team2seniordesignwiki/OmegaBlade/4013 Senior Design/galleryImages/rgbLED_pic_prototype1.jpg

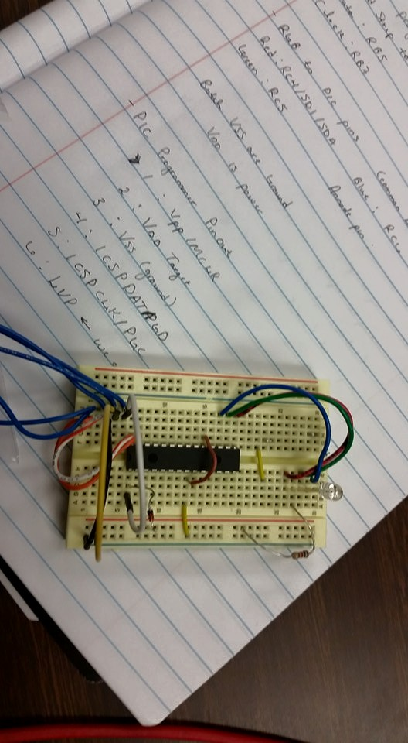
4013 Senior Design/galleryImages/rgbLED_pic_prototype1.jpg
