team2seniordesignwiki/OmegaBlade/4013 Senior Design/galleryImages/20151021221119.jpg

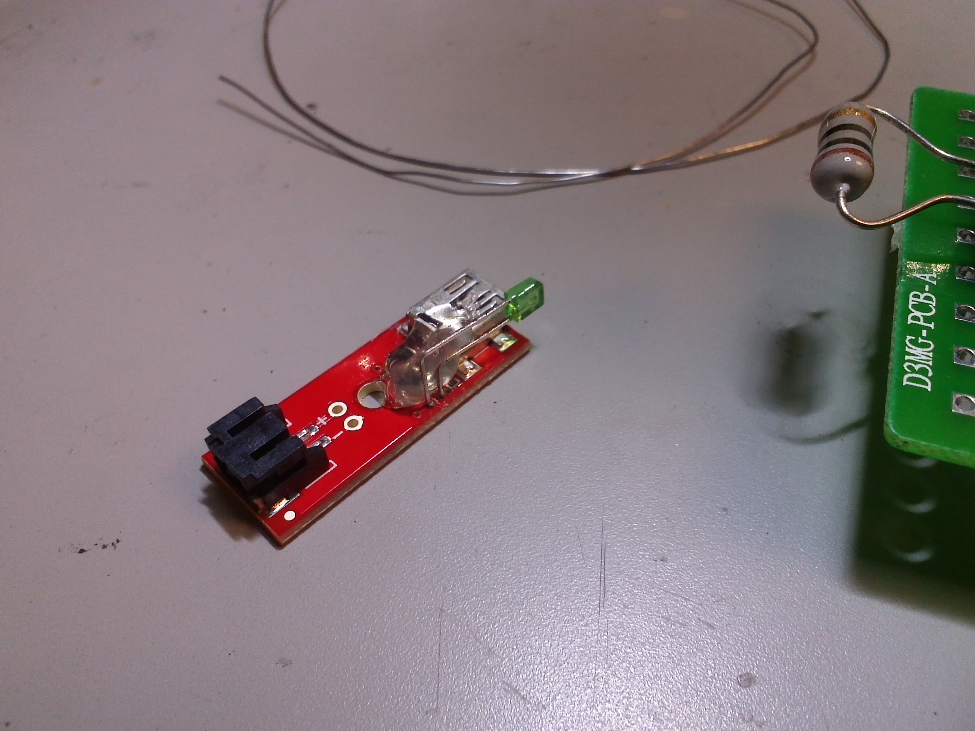
4013 Senior Design/galleryImages/20151021221119.jpg
