team2seniordesignwiki/OmegaBlade/Readme.txt

This the repository for Senior Design I - Team2 "Swordsmiths" for project OmegaBlade.
