team2seniordesignwiki/OmegaBlade/4013 Senior Design/Research/Blake/Blade and Grip Design/leather stripping for grips.txt

https://www.etsy.com/listing/176576841/russet-brown-genuine-leather-strips-2cm?ref=market
