team2seniordesignwiki/OmegaBlade/4013 Senior Design/Research/Derrian/Blade Locking Communication/Contact Connectors.txt

http://www.digikey.com/product-search/en?KeyWords=m90-6060845&WT.z_header=search_go

http://www.digikey.com/product-detail/en/M90-7060845/M90-7060845-ND/3924390

One order includes 4 connectors each
