team2seniordesignwiki/OmegaBlade/4013 Senior Design/Research/Derrian/Blade Locking Communication/Magnetic Connectors.txt

http://www.mindsetsonline.co.uk/Catalogue/ProductDetail/magnetic-connectors?productID=246373b2-2c6d-4ec8-a061-2f90dcc4a404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
