team2seniordesignwiki/OmegaBlade/4013 Senior Design/Managerial Docs/Team Block Diagram/Powerpoint Block Diagram Requirements.docx

## PowerPoint presentation must contain:

- Level 1 functional block diagram
- Pseudocode or flowchart for software
  - Flowchart must use proper symbology
- Gantt chart
  - Who’s doing what and when
- No Poster Needed
