team2seniordesignwiki/OmegaBlade/4013 Senior Design/Managerial Docs/Project Planning/4013 Senior Design I Team2 (Swordsmiths) Gantt Project.pdf

## 4013 Senior Design I Team2

(Swordsmiths) Gantt Project | Aug 30, 2015
ECEN Department | http://ecen4013.okstate.edu

Project manager
Project dates | Sep 1, 2015 - Nov 20, 2015
Completion | 0%
Tasks | 12
Resources | 6

This project contains both Gantt and PERT charts outlining task duration, deadlines, milestones, resource distribution, and task dependencies.

Name | Begin date | End date
Block Diagram | 9/1/15 | 9/21/15
Research | 9/1/15 | 9/21/15
Hardware Selection | 9/1/15 | 9/21/15
IR MIRP | 9/1/15 | 9/21/15
Enclosure Materials and Fabrication | 9/1/15 | 9/21/15
Prototyping | 9/17/15 | 10/8/15
Testing of IR Circuitry | 9/17/15 | 10/8/15
Testing of IR Transmission Code | 9/17/15 | 10/8/15
Enclosure Fabrication | 9/17/15 | 10/8/15
Integration Phase 1 | 10/1/15 | 10/15/15
Integration Phase 2 | 10/13/15 | 11/5/15
Project Report | 11/3/15 | 11/19/15

## 4013 Senior Design I Team2 (Swordsmiths)

Gantt Project | Aug 30, 2015
Tasks | 2

Name | Default role
Blake Schlesinger | Project Manger
Ben Jespersen | Lead Engineer
Austin Allen | Functional Specialist (Assembler)
Brandon Hogue | Treasurer
Christian Coffield | Proofreader/Editor
Derrian Glynn | Mediator
Resources | 3

## Gantt Chart

4

Name | Begin date | End date
Block Diagram | 9/1/15 | 9/21/15
Research | 9/1/15 | 9/21/15
Hardware Selection | 9/1/15 | 9/21/15
IR MIRP | 9/1/15 | 9/21/15
Enclosure Materials and ... 9/1/15 | 9/21/15
Prototyping | 9/17/15 | 10/8/15
Testing of IR Circuitry | 9/17/15 | 10/8/15
Testing of IR Transmissio...9/17/15 | 10/8/15
Enclosure Fabrication | 9/17/15 | 10/8/15
Integration Phase 1 | 10/1/15 | 10/15/15
Integration Phase 2 | 10/13/15 | 11/5/15
Project Report | 11/3/15 | 11/19/15
Week 36 | Week 37 | Week 38 | Week 39 | Week 40 | Week 41 | Week 42 | Week 43 | Week 44 | Week 45 | Week 46 | Week 47 | Week 48
8/30/15 | 9/6/15 | 9/13/15 | 9/20/15 | 9/27/15 | 10/4/15 | 10/11/15 | 10/18/15 | 10/25/15 | 11/1/15 | 11/8/15 | 11/15/15 | 11/22/15

## Resources Chart

5

Name | Default role
Blake Schlesinger | Project Manger
Ben Jespersen | Lead Engineer

Block Diagram

Hardware Sele...

Austin Allen | Functional Specialist (Ass...
Brandon Hogue | Treasurer
Christian Coffield | Proofreader/Editor
Derrian Glynn | Mediator
50% | 50% | 50%
70% | 70% | 70%
50% | 50% | 50%
20% | 20% | 20%
50% | 50% | 50% | 90% | 40% | 40% | 40%
50% | 50% | 50% | 70% | 20% | 20% | 20%
20% | 20% | 20% | 40% | 20% | 20% | 20%
50% | 50% | 50% | | 50% | 50% | 50%
Week 36 | Week 37 | Week 38 | Week 39 | Week 40 | Week 41 | Week 42 | Week 43 | Week 44 | Week 45 | Week 46 | Week 47 | Week 48
8/30/15 | 9/6/15 | 9/13/15 | 9/20/15 | 9/27/15 | 10/4/15 | 10/11/15 | 10/18/15 | 10/25/15 | 11/1/15 | 11/8/15 | 11/15/15 | 11/22/15
