team2seniordesignwiki/OmegaBlade/4013 Senior Design/Research/Brandon Hogue/IR/Transmit/NPN-CC-Driver-Schematic.pdf

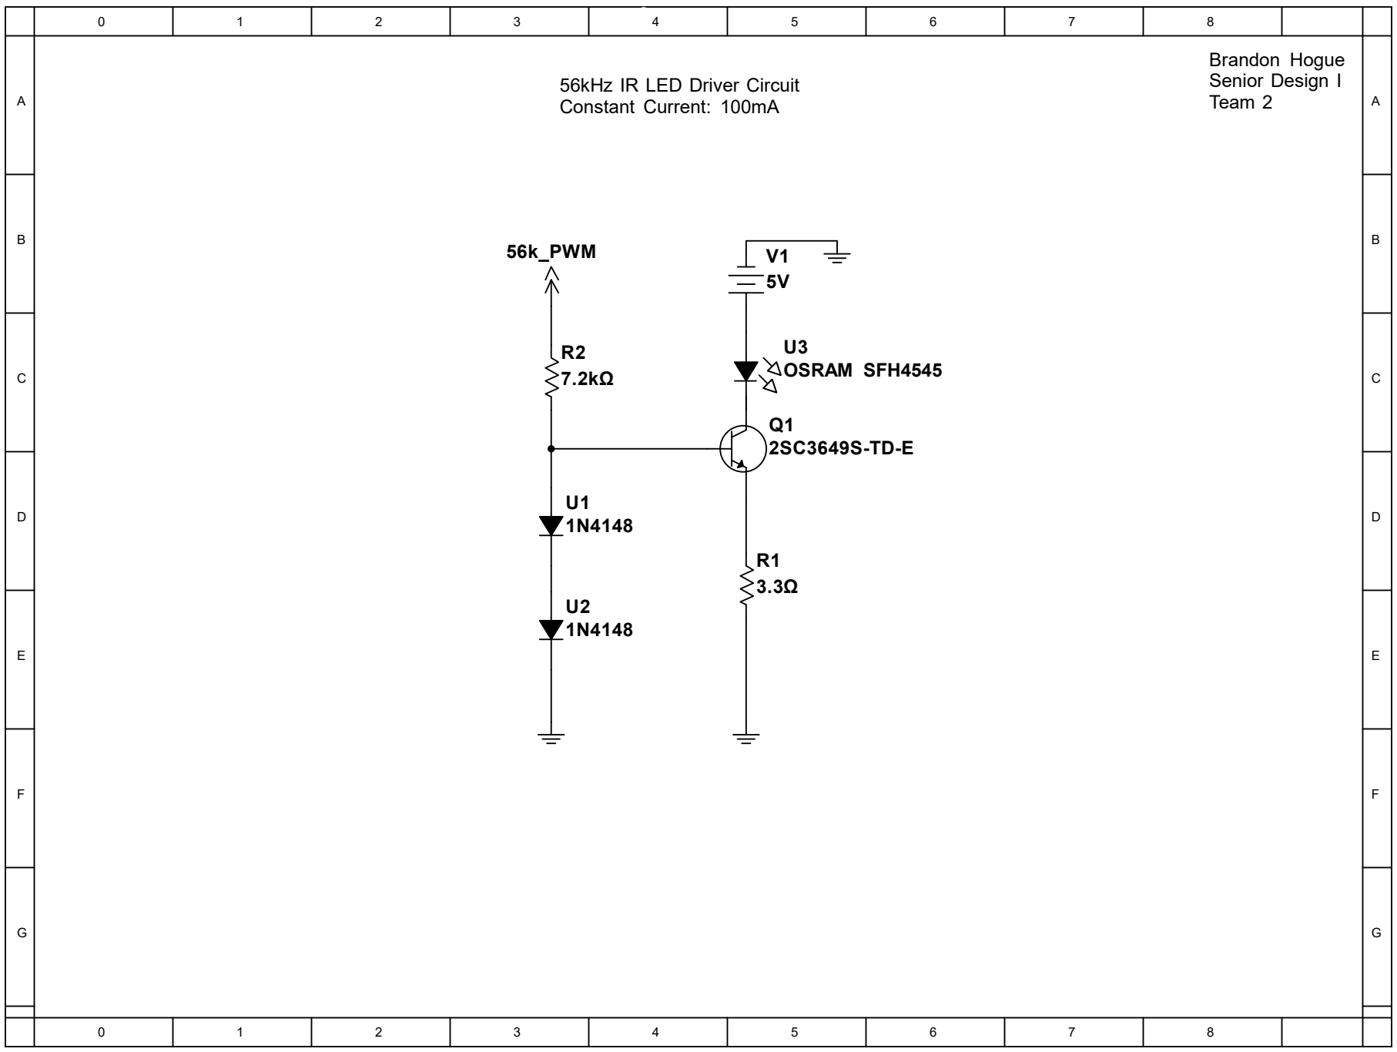
[picture p37: figure]
U3 OSRAM SFH4545; 56k_PWM; 56kHz IR LED Driver Circuit Constant Current: 100mA; Brandon Hogue Senior Design I Team 2
