team2seniordesignwiki/OmegaBlade/4013 Senior Design/Managerial Docs/Reports and Presentations/Omega Blade Team 2 Presentation.pptx

## Omega Blade

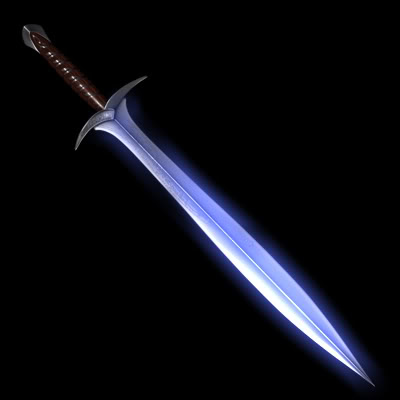
[picture p38: figure]
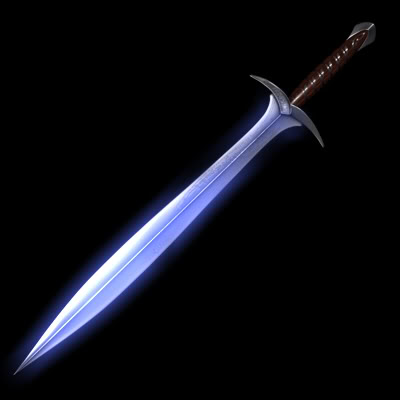
[picture p39: figure]

Team 2 “Swordsmiths”
Austin Allen
Christian Coffield
Derrian Glynn
Brandon Hogue
Ben Jespersen(LE)
Blake Schlesinger(PM)

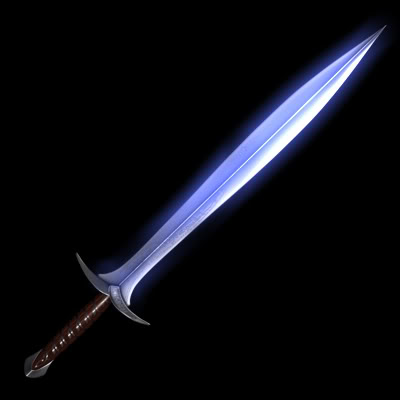
[picture p40: figure]

## The Story

## α

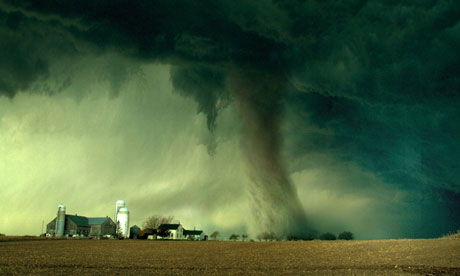
[picture p41: figure]

## β

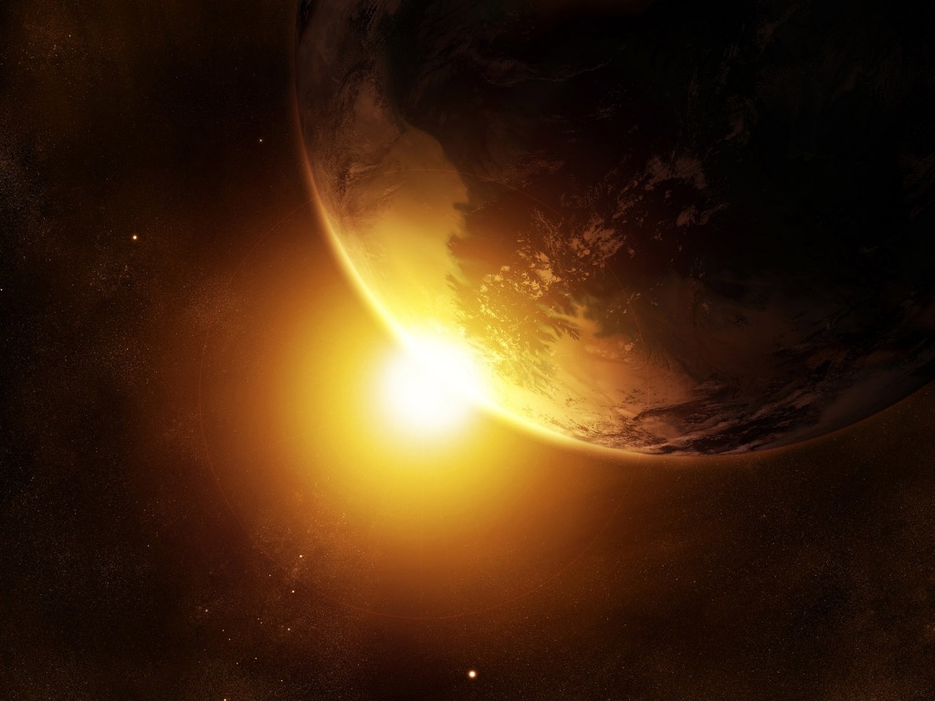
[picture p42: figure]

## Δ

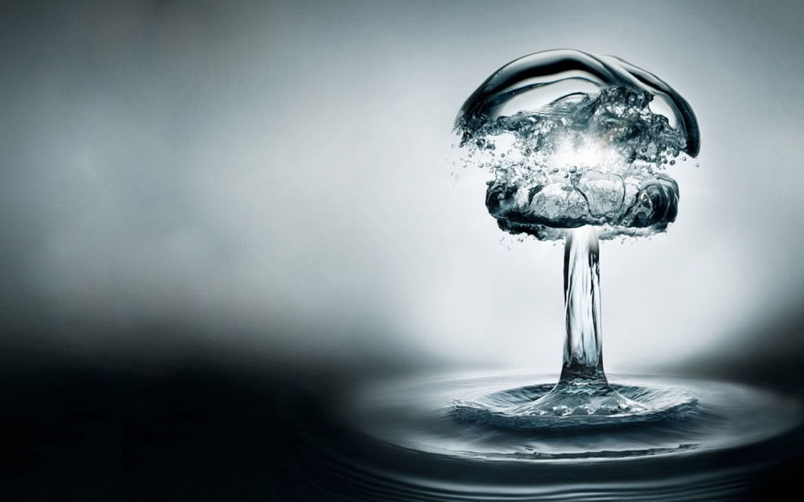
[picture p43: figure]

## γ

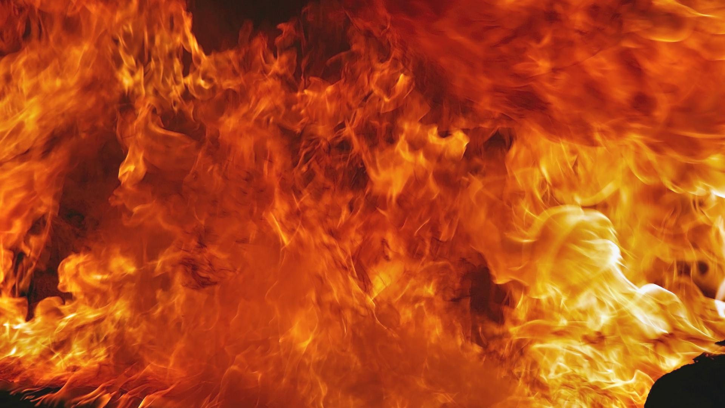
[picture p44: figure]

## Slide 7

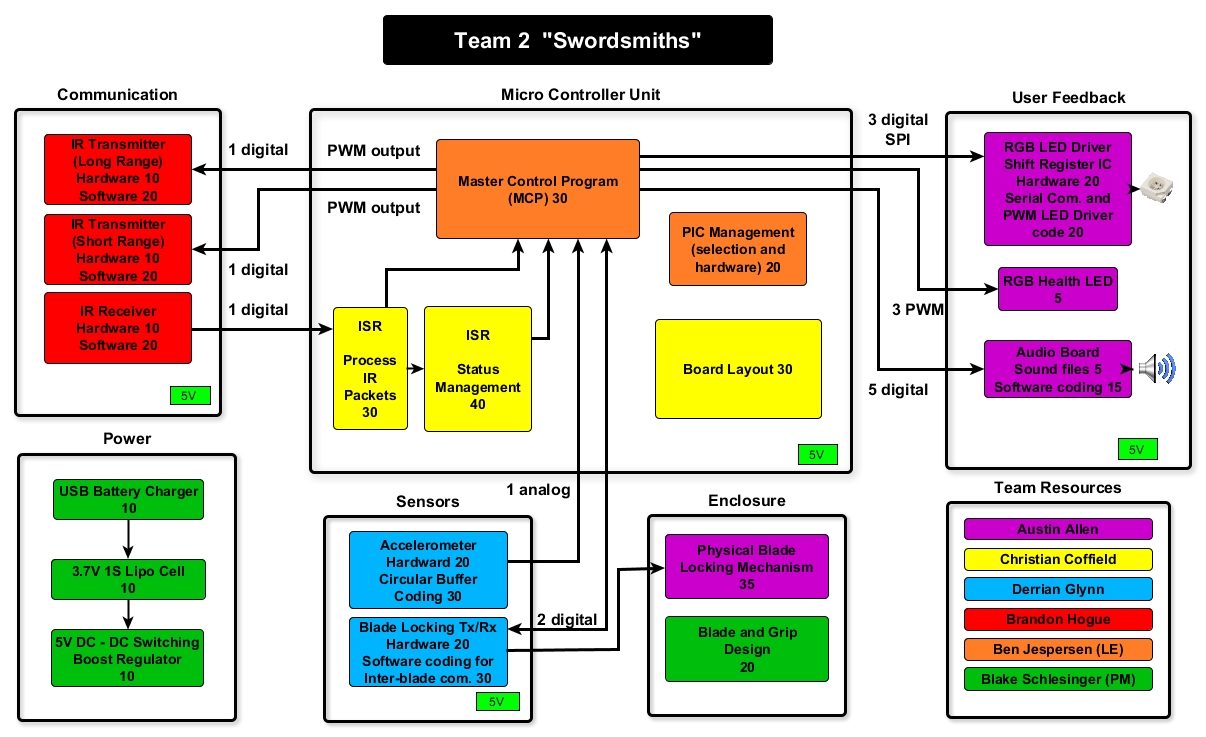
[picture p45: figure]

## Slide 8

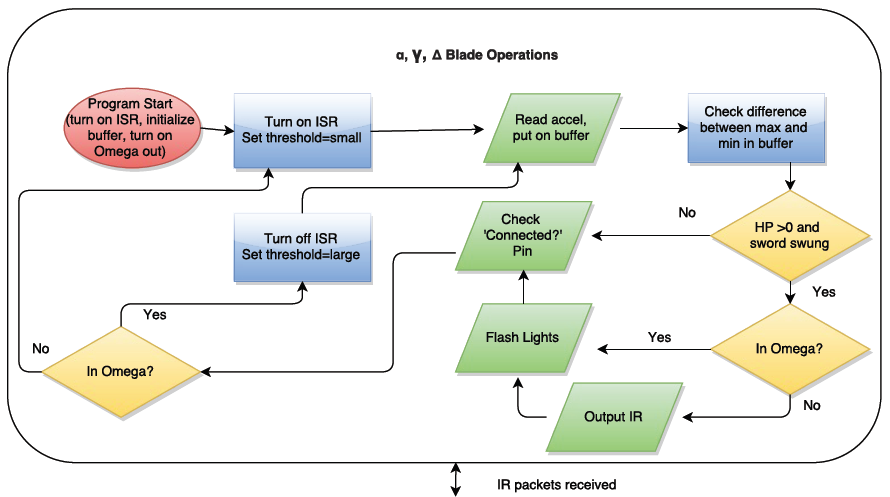
[picture p46: figure]
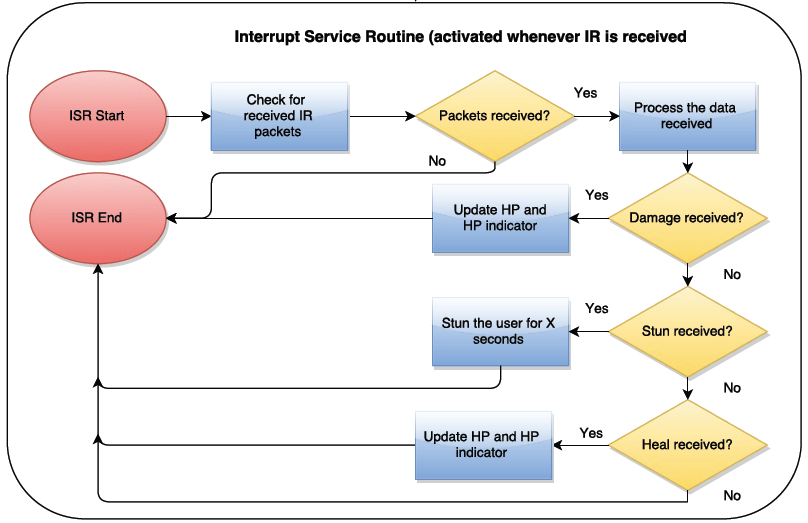
[picture p47: figure]

## Slide 9

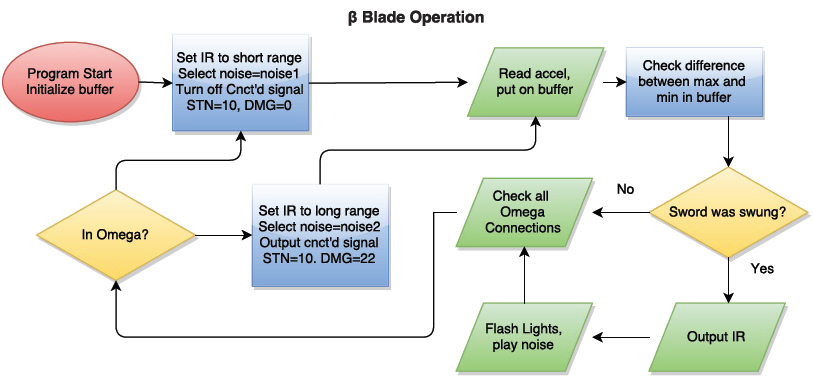
[picture p48: figure]

## Gantt Chart

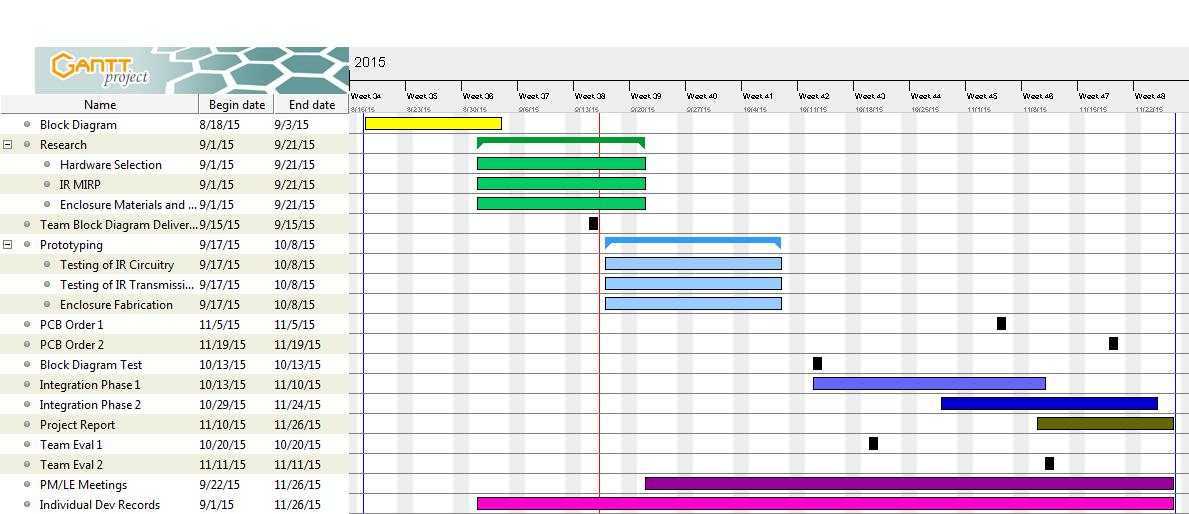
[picture p49: figure]

## Questions?
