team2seniordesignwiki/OmegaBlade/4013 Senior Design/Managerial Docs/Decision Matrix Spreadsheets/BLANK Table of Interests.xlsx

 | Pairwise comparison of selection criteria. |  |  |  |  |  |  |  | Note: Technical complexity meaning we want it to be more complex?
 |  | B |  |  |  |  |  |  | 1=A is equally important as B
 |  | Personal Skill | Complexity | Creativity | Cost | Interest | Geo.Mean | Weight | 2=A is moderately more important than B
A | Personal Skill |  |  |  |  |  | #NUM! | #NUM! | 3=A is strongly more important than B
 | Complexity |  |  |  |  |  | #NUM! | #NUM! | 4=A is very strongly more important than B
 | Creativity |  |  |  |  |  | #NUM! | #NUM! | 5=A is heavily more important than B
 | Cost |  |  |  |  |  | #NUM! | #NUM!
 | Interest |  |  |  |  |  | #NUM! | #NUM!
 |  |  |  |  |  | SUM= | #NUM! | #NUM!
 |  |  | Scoring the projects |  |  | Projects |  |  | Ranking from 1-5, with 1 being unfavorable, 5 being very favorable
 | CRITERIA | WEIGHT | Blacksmith | E-Bow | OmegaBlade | Puzzle | MOAB | Follower
 | Personal Skill | #NUM!
 | Complexity | #NUM!
 | Creativity | #NUM!
 | Cost | #NUM!
 | Interest | #NUM!
 |  | Points | #NUM! | #NUM! | #NUM! | #NUM! | #NUM! | #NUM!
