team2seniordesignwiki/OmegaBlade/4013 Senior Design/Managerial Docs/Decision Matrix Spreadsheets/decision_matrix_ben_jespersen.xlsx

Sheet: Sheet1
Determination of Weights | Team Skill | Technical Complexity | Creativity | Cost | Interest | Geometric Mean | Weights | Ranking Scale | Alternatives
Personal Skill | 1 | 2 | 0.5 | 0.3333333333 | 0.3333333333 | 0.644 | 0.110 | 1 = equal | Blacksmith 2.0
Technical Complexity | 0.5 | 1 | 0.5 | 0.25 | 0.25 | 0.435 | 0.074 | 2 = moderate | E-Bow
Creativity | 2 | 2 | 1 | 0.5 | 0.5 | 1.000 | 0.171 | 3 = strong | Omega Blade
Cost | 3 | 4 | 2 | 1 | 1 | 1.888 | 0.322 | 4 = very strong | Mystic Puzzle
Interest | 3 | 4 | 2 | 1 | 1 | 1.888 | 0.322 | 5 = heavy | MOAB
 |  |  |  |  |  |  |  |  | Follower Watchdog
Project Ratings | Personal Skill | Technical Complexity | Creativity | Cost | Interest | Geometric Mean | Ratings | Project Ratings Scale
Blacksmith 2.0 | 5 | 3 | 3 | 4 | 3 | 3.519 | 0.202 | 1 = least favorable
E-Bow | 3 | 2 | 2 | 2 | 4 | 2.491 | 0.143 | 2 = moderate
Omega Blade | 5 | 3 | 3 | 3 | 5 | 3.680 | 0.211 | 3 = strong
Mystic Puzzle | 3 | 2 | 4 | 3 | 5 | 3.245 | 0.186 | 4 = very strong
MOAB | 5 | 5 | 1 | 5 | 1 | 2.627 | 0.151 | 5 = most favorable
Follower Watchdog | 3 | 1 | 4 | 1 | 2 | 1.888 | 0.108
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
