team2seniordesignwiki/OmegaBlade/4013 Senior Design/Managerial Docs/Decision Matrix Spreadsheets/Table of Interests - Austin Allen.xlsx

Pairwise comparison of selection criteria. |  |  |  |  |  |  |  | Note: Technical complexity meaning we want it to be more complex?
 | B |  |  |  |  |  |  | 1=A is equally important as B
 | Personal Skill | Complexity | Creativity | Cost | Interest | Geo.Mean | Weight | 2=A is moderately more important than B
Personal Skill | 1 | 4 | 2 | 0.3333333333 | 1 | 1.216728684 | 0.2166311875 | 3=A is strongly more important than B
Complexity | 0.25 | 1 | 0.25 | 0.25 | 0.25 | 0.3298769777 | 0.05873260191 | 4=A is very strongly more important than B
Creativity | 0.5 | 4 | 1 | 3 | 1 | 1.430969081 | 0.2547753953 | 5=A is heavily more important than B
Cost | 3 | 4 | 0.3333333333 | 1 | 1 | 1.319507911 | 0.2349304076
Interest | 1 | 4 | 1 | 1 | 1 | 1.319507911 | 0.2349304076
 |  |  |  |  | SUM= | 5.616590564 | 1
 |  | Scoring the projects |  |  | Projects |  |  | Ranking from 1-5, with 1 being unfavorable, 5 being very favorable
CRITERIA | WEIGHT | Blacksmith | E-Bow | OmegaBlade | Puzzle | MOAB | Follower
Personal Skill | 0.25 | 4 | 4 | 3 | 2 | 4 | 4
Complexity | 0.25 | 2 | 3 | 4 | 4 | 2 | 5
Creativity | 0.25 | 3 | 3 | 2 | 1 | 4 | 3
Cost | 0.2349304076 | 3 | 2 | 3 | 2 | 3 | 1
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
