team2seniordesignwiki/OmegaBlade/4013 Senior Design/Managerial Docs/Decision Matrix Spreadsheets/Table of Interests - Christian Coffield.xlsx

 | Pairwise comparison of selection criteria. |  |  |  |  |  |  |  | Note: Technical complexity meaning we want it to be more complex?
 |  | B |  |  |  |  |  |  | 1=A is equally important as B
 |  | Personal Skill | Complexity | Creativity | Cost | Interest | Geo.Mean | Weight | 2=A is moderately more important than B
A | Personal Skill | 1 | 3 | 3 | 0.3333333333 | 0.5 | 1.084471771 | 0.1937165646 | 3=A is strongly more important than B
 | Complexity | 0.3333333333 | 1 | 0.25 | 0.3333333333 | 0.3333333333 | 0.3920263408 | 0.07002671531 | 4=A is very strongly more important than B
 | Creativity | 0.33 | 4 | 1 | 0.25 | 0.3333333333 | 0.6431000406 | 0.1148754019 | 5=A is heavily more important than B
 | Cost | 3 | 3 | 4 | 1 | 1 | 2.047672511 | 0.3657707787
 | Interest | 2 | 3 | 1 | 1 | 1 | 1.430969081 | 0.2556105394
 |  |  |  |  |  | SUM= | 5.598239745 | 1
 |  |  | Scoring the projects |  |  | Projects |  |  | Ranking from 1-5, with 1 being unfavorable, 5 being very favorable
 | CRITERIA | WEIGHT | Blacksmith | E-Bow | OmegaBlade | Puzzle | MOAB | Follower
 | Personal Skill | 0.1937165646 | 3 | 2 | 3 | 3 | 5 | 4
 | Complexity | 0.07002671531 | 3 | 4 | 3 | 3 | 1 | 4
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
