team2seniordesignwiki/OmegaBlade/4013 Senior Design/Managerial Docs/Decision Matrix Spreadsheets/Team2 AHP Project Decision Matrix Revised.xlsx

Team 2: Analytical Hierarchy Process (AHP)
Members: Austin Allen, Ben Jespersen, Blake Schlesinger, Brandon Hogue, Christian Coffield, Derrian Glynn
Pairwise Comparison of the Selection Criteria
 | Cost | Interest | Creativity | Skill | Complexity | Geometric Mean | Weight
Cost | 1 | 4 | 3 | 2 | 1 | 1.888175023 | 0.2486883236
Interst | 4 | 1 | 2 | 2 | 1 | 1.741101127 | 0.2293174707
Creativity | 3 | 2 | 1 | 1 | 2 | 1.64375183 | 0.2164957602
Skill | 2 | 2 | 1 | 1 | 1 | 1.319507911 | 0.1737901447
Complexity | 1 | 1 | 1 | 1 | 1 | 1 | 0.1317083007
 |  |  |  |  | Summation: | 7.592535889 | 1
Decision Matrix
 | BlackSmith 2.0 | E-Bow | The Omega Blade | The Mystic Puzzle | MOAB | Follower/WatchDog | Weight
Cost | 0.2 | 0.2 | 0.2666666667 | 0.2666666667 | 0.2666666667 | 0.2666666667 | 0.2486883236
Interest | 0.2 | 0.2666666667 | 0.2666666667 | 0.2 | 0.1333333333 | 0.06666666667 | 0.2293174707
Creativity | 0.2666666667 | 0.2 | 0.2 | 0.2 | 0.1333333333 | 0.1333333333 | 0.2164957602
Skill | 0.1333333333 | 0.2 | 0.1333333333 | 0.2 | 0.2666666667 | 0.2666666667 | 0.1737901447
Complexity | 0.2 | 0.1333333333 | 0.1333333333 | 0.1333333333 | 0.2 | 0.2666666667 | 0.1317083007
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
