team2seniordesignwiki/OmegaBlade/4013 Senior Design/Managerial Docs/Decision Matrix Spreadsheets/Team2 AHP Project Decision Matrix.xlsx

Team 2: Analytical Hierarchy Process (AHP)
Members: Austin Allen, Ben Jespersen, Blake Schlesinger, Brandon Hogue, Christian Coffield, Derrian Glynn
Pairwise Comparison of the Selection Criteria
 | Cost | Interest | Creativity | Skill | Complexity | Geometric Mean | Weight
Cost | 1 | 4 | 3 | 2 | 1 | 1.888175023 | 0.2486883236
Interst | 4 | 1 | 2 | 2 | 1 | 1.741101127 | 0.2293174707
Creativity | 3 | 2 | 1 | 1 | 2 | 1.64375183 | 0.2164957602
Skill | 2 | 2 | 1 | 1 | 1 | 1.319507911 | 0.1737901447
Complexity | 1 | 1 | 1 | 1 | 1 | 1 | 0.1317083007
 |  |  |  |  | Summation: | 7.592535889 | 1
Decision Matrix
 | BlackSmith 2.0 | E-Bow | The Omega Blade | The Mystic Puzzle | MOAB | Follower/WatchDog | Weight
Cost | 3 | 3 | 3 | 3 | 4 | 4 | 0.2486883236
Interest | 3 | 4 | 5 | 3 | 1 | 1 | 0.2293174707
Creativity | 4 | 3 | 4 | 3 | 2 | 3 | 0.2164957602
Skill | 2 | 3 | 3 | 3 | 4 | 1 | 0.1737901447
Complexity | 3 | 2 | 3 | 4 | 2 | 1 | 0.1317083007
Total Points | 3.042705616 | 3.09760917 | 3.675130702 | 3.131708301 | 2.615639466 | 2.179056491
Score Weights: | 0.1714987817 | 0.1745933606 | 0.2071447315 | 0.1765153209 | 0.1474276642 | 0.1228201412
Sum Weights (Should = 1): |  | 1
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
