team2seniordesignwiki/OmegaBlade/4013 Senior Design/Research/Derrian/Accelerometer/WiiMote Data/SwingLog.xlsx

RelAccX | RelAccY | RelAccZ
0.39 | 0.81 | 0.2
0 | 1.01 | -0.17
0.01 | -0.18 | -0.11
-0.02 | 0.27 | 0.14
-0.02 | 0.27 | 0.14
-0.01 | 0.18 | 0.1
-0.01 | 0.18 | 0.1
-0.01 | 0.18 | 0.1
-0.01 | 0.18 | 0.1
0 | 0.18 | 0.09
0 | 0.18 | 0.09
-0.01 | 0.33 | 0.17
0 | 0.03 | 0.02
0 | 0.03 | 0.02
-0.01 | 0.18 | 0.1
-0.01 | 0.18 | 0.1
-0.01 | 0.33 | 0.17
-0.01 | 0.33 | 0.17
-0.01 | 0.18 | 0.1
-0.01 | 0.18 | 0.1
-0.01 | 0.18 | 0.1
-0.01 | 0.18 | 0.1
-0.01 | 0.18 | 0.1
-0.01 | 0.26 | 0.14
-0.01 | 0.18 | 0.1
-0.01 | 0.33 | 0.17
-0.01 | 0.33 | 0.17
-0.01 | 0.18 | 0.1
-0.01 | 0.18 | 0.1
-0.01 | 0.26 | 0.14
-0.01 | 0.26 | 0.14
-0.01 | 0.18 | 0.1
-0.01 | 0.18 | 0.1
-0.01 | 0.25 | 0.14
-0.01 | 0.25 | 0.14
-0.01 | 0.25 | 0.14
-0.01 | 0.26 | 0.14
-0.01 | 0.26 | 0.14
-0.03 | 0.35 | 0.2
-0.03 | 0.35 | 0.2
-0.01 | 0.19 | 0.11
-0.01 | 0.19 | 0.11
0.28 | 1.51 | 0.01
-0.01 | 1.2 | 0.59
-0.7 | 0.02 | 1.15
-0.7 | 0.02 | 1.15
-0.02 | 0.19 | 0.13
-0.01 | 0.11 | 0.07
-0.01 | 0.11 | 0.07
0.09 | 0.5 | 0.45
0.09 | 0.5 | 0.45
0.48 | 1.87 | 0.26
0.48 | 1.87 | 0.26
-0.11 | -2.44 | 1.2
0.77 | -3.03 | 2.33
0 | -0.15 | -0.19
0 | -0.17 | -0.2
0 | -0.12 | -0.17
-0.01 | 0.21 | 0.3
-0.01 | 0.21 | 0.3
0 | 0.08 | 0.12
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
