team2seniordesignwiki/OmegaBlade/4013 Senior Design/galleryImages/4013 Senior Design I Team2 (Swordsmiths) Gantt Project.jpg

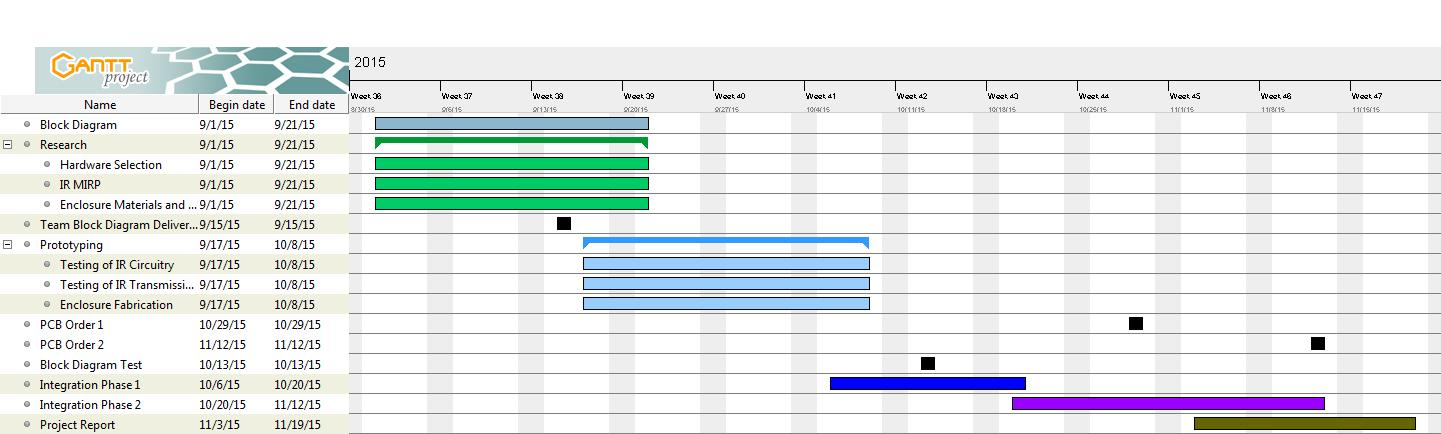
4013 Senior Design/galleryImages/4013 Senior Design I Team2 (Swordsmiths) Gantt Project.jpg
