team2seniordesignwiki/OmegaBlade/4013 Senior Design/galleryImages/4013 Senior Design Team2 Level1 Functional Block Diagram Rev1.0.jpg

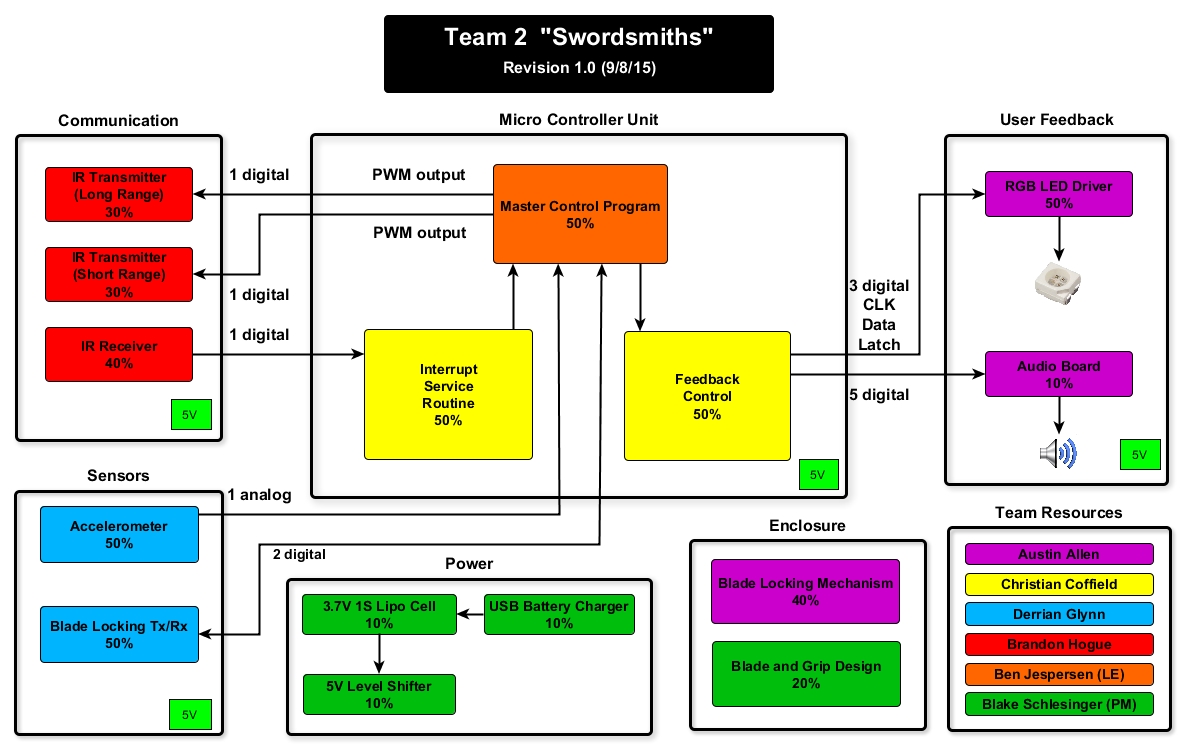
4013 Senior Design/galleryImages/4013 Senior Design Team2 Level1 Functional Block Diagram Rev1.0.jpg
