team2seniordesignwiki/OmegaBlade/4013 Senior Design/galleryImages/11950278_170965093241196_2516988166269493549_o.jpg

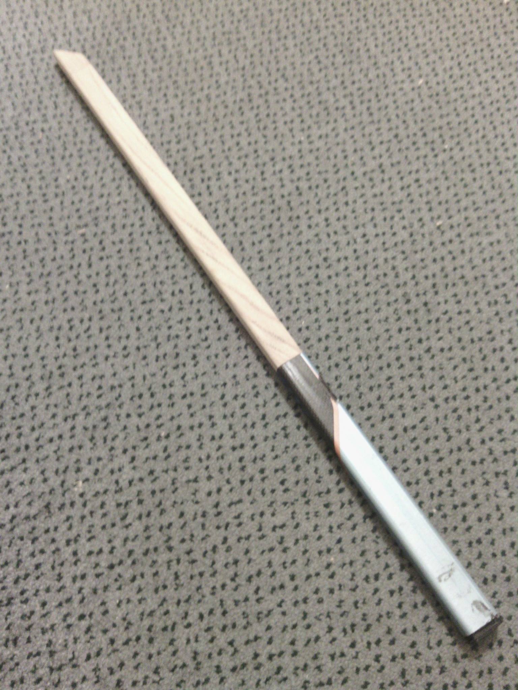
4013 Senior Design/galleryImages/11950278_170965093241196_2516988166269493549_o.jpg
