team2seniordesignwiki/OmegaBlade/4013 Senior Design/galleryImages/12080031_10203753922449047_6051384339884506381_o.jpg

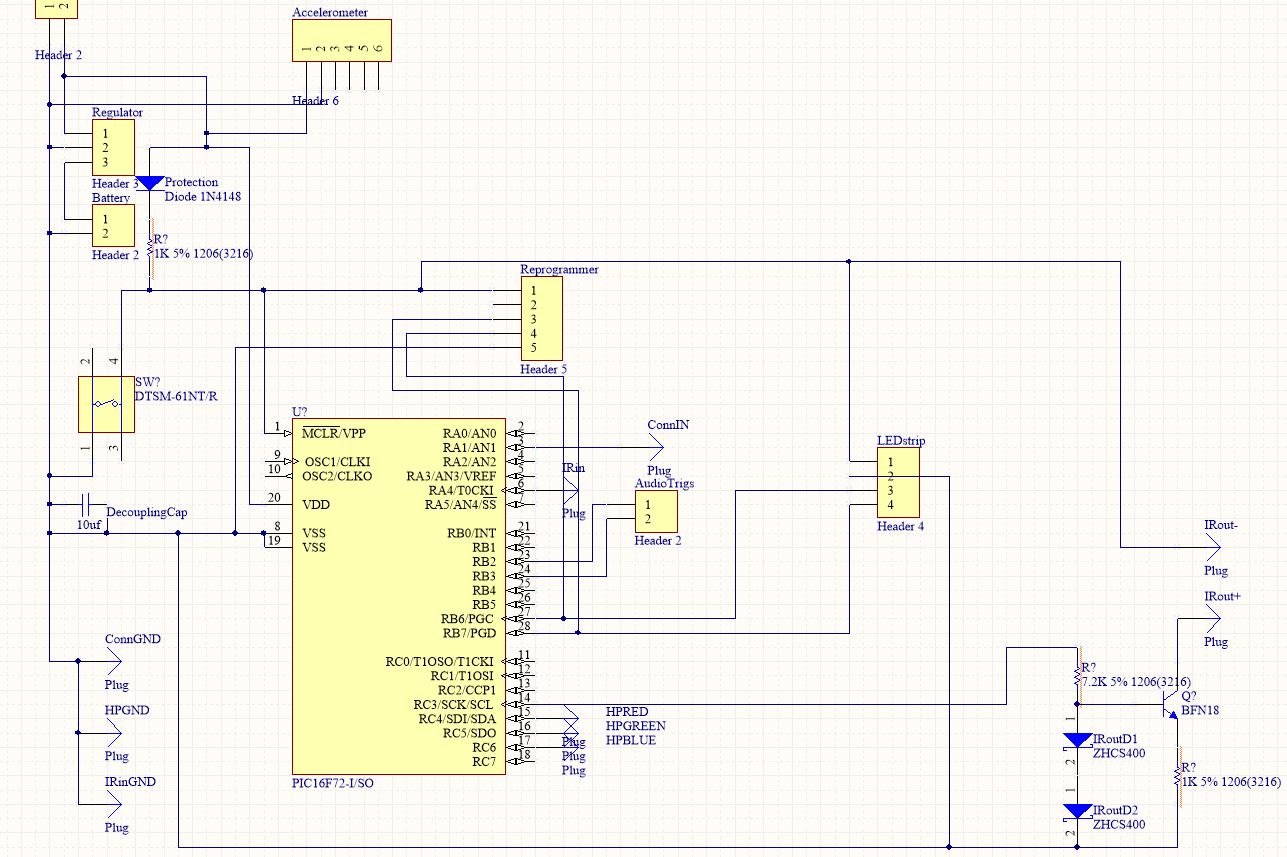
4013 Senior Design/galleryImages/12080031_10203753922449047_6051384339884506381_o.jpg
