team2seniordesignwiki/OmegaBlade/4013 Senior Design/galleryImages/12112323_10207700417086064_191214422558281539_n.jpg

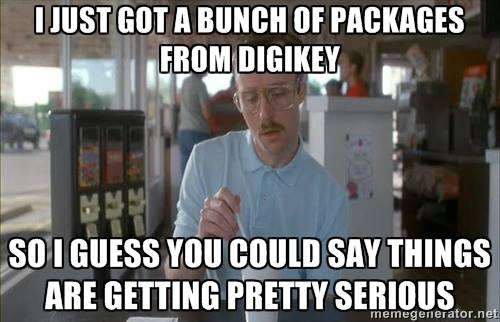
4013 Senior Design/galleryImages/12112323_10207700417086064_191214422558281539_n.jpg
