team2seniordesignwiki/OmegaBlade/4013 Senior Design/galleryImages/12144730_10203749504978613_2182690374924432743_n.jpg

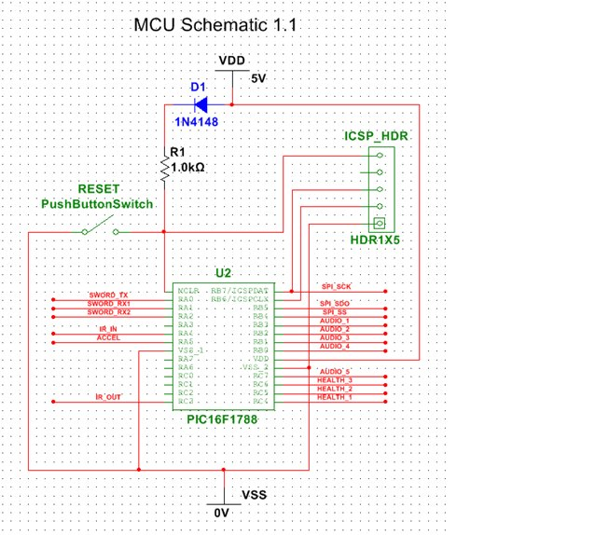
4013 Senior Design/galleryImages/12144730_10203749504978613_2182690374924432743_n.jpg
