team2seniordesignwiki/OmegaBlade/4013 Senior Design/galleryImages/20150928_135025.jpg

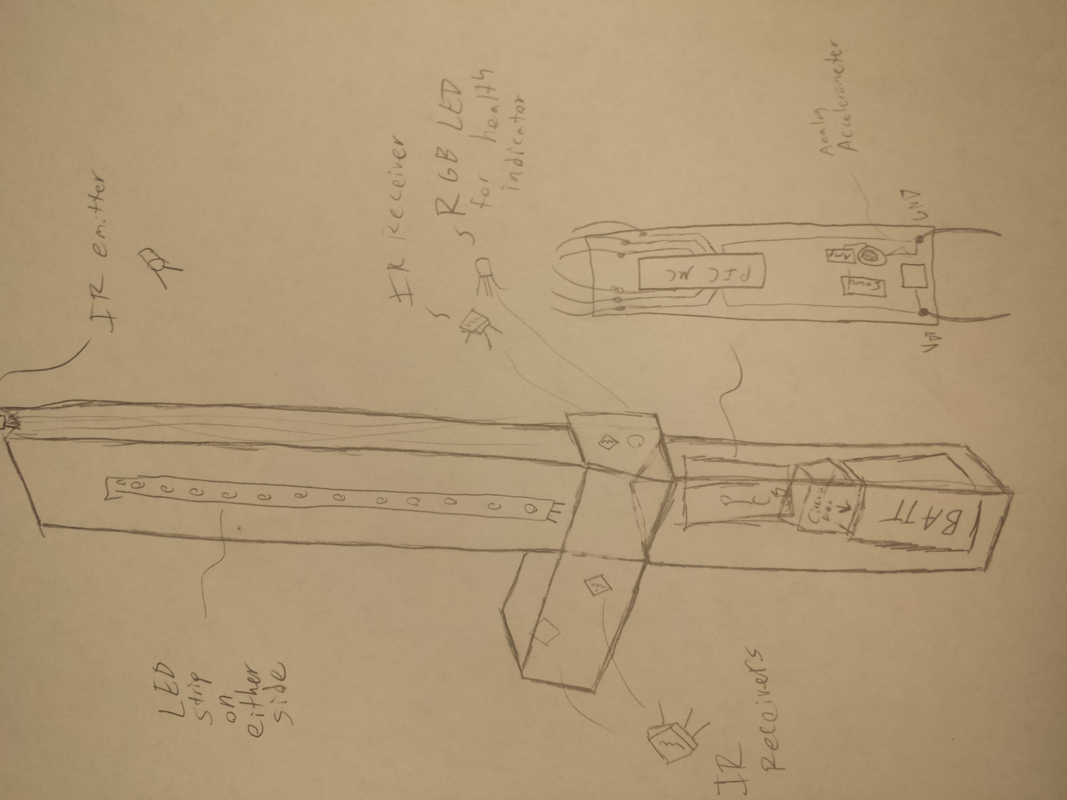
4013 Senior Design/galleryImages/20150928_135025.jpg
