team2seniordesignwiki/OmegaBlade/4013 Senior Design/galleryImages/20150928_135035.jpg

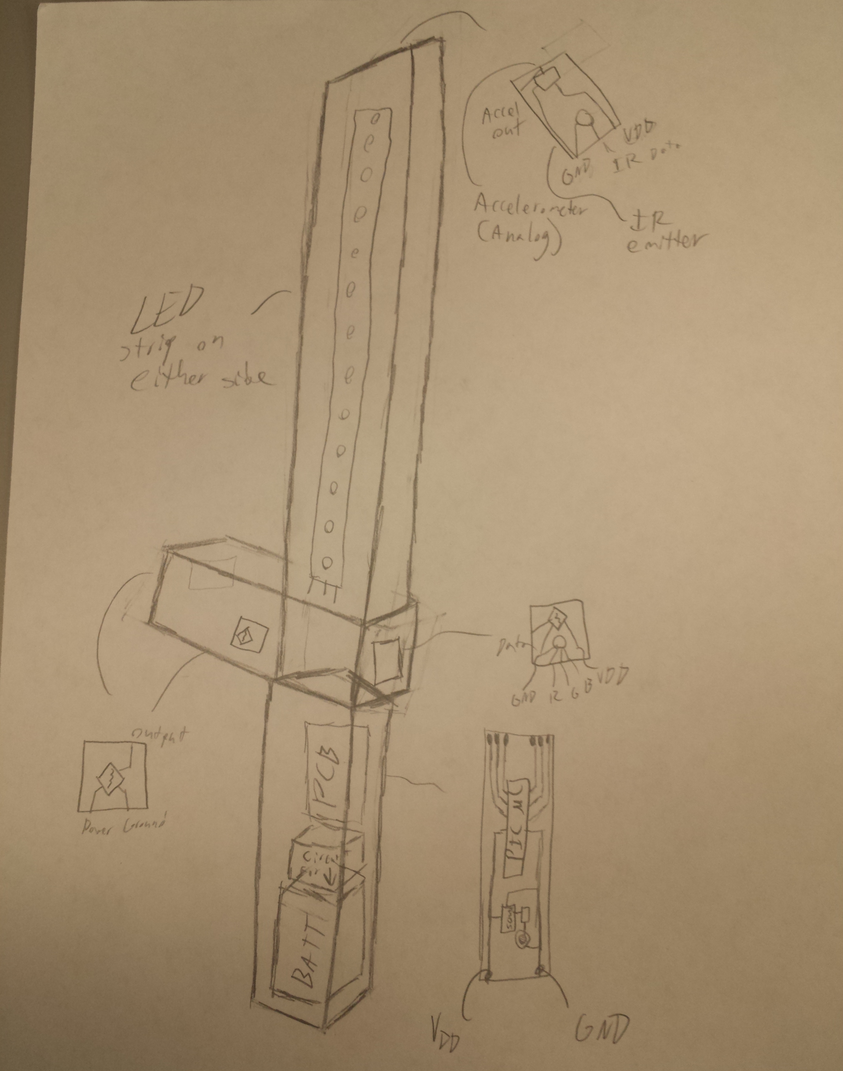
4013 Senior Design/galleryImages/20150928_135035.jpg
