team2seniordesignwiki/OmegaBlade/4013 Senior Design/galleryImages/20151020152824.jpg

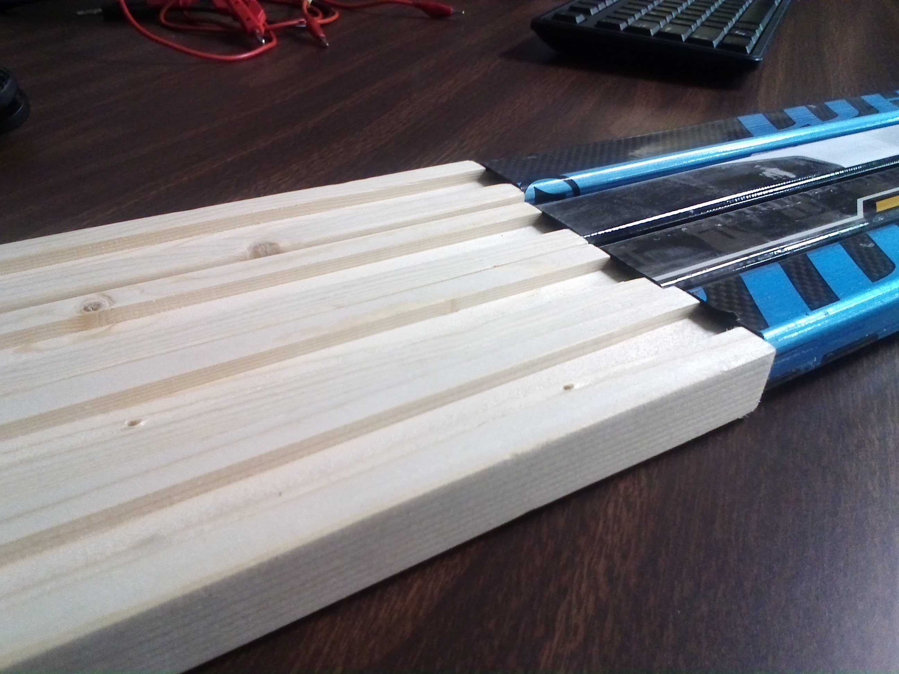
4013 Senior Design/galleryImages/20151020152824.jpg
