team2seniordesignwiki/OmegaBlade/4013 Senior Design/galleryImages/20151020170233.jpg

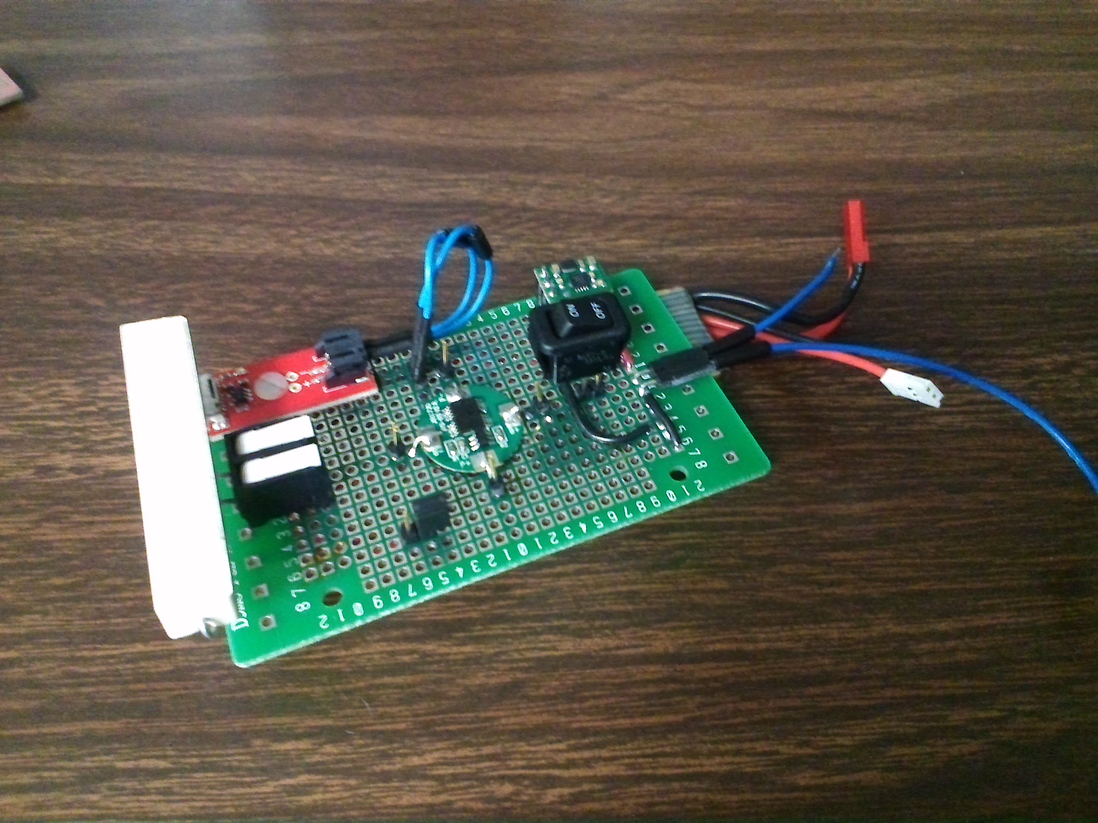
4013 Senior Design/galleryImages/20151020170233.jpg
