team2seniordesignwiki/OmegaBlade/4013 Senior Design/galleryImages/20151021221250.jpg

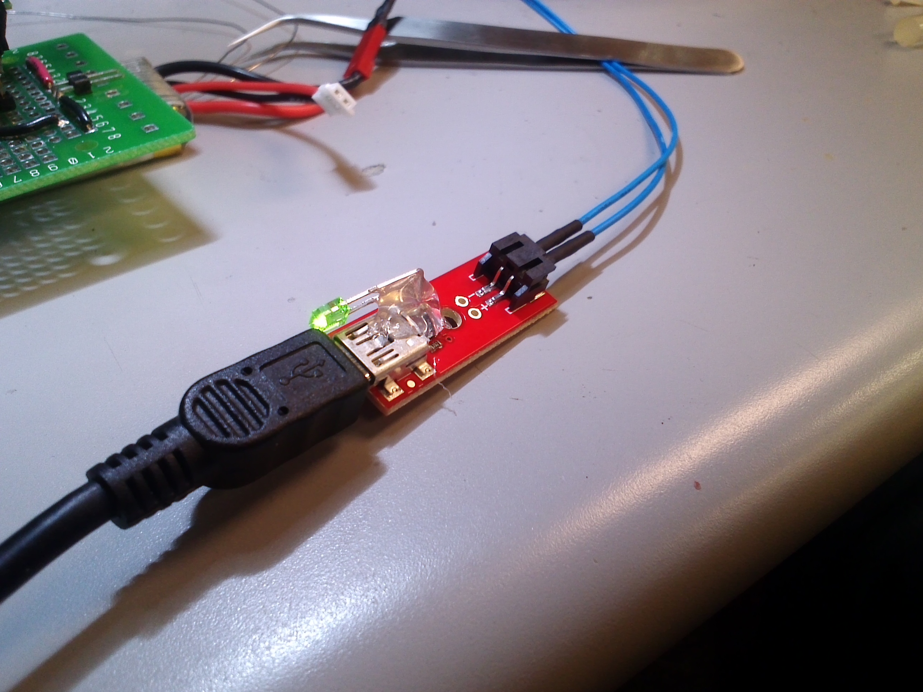
4013 Senior Design/galleryImages/20151021221250.jpg
