team2seniordesignwiki/OmegaBlade/4013 Senior Design/galleryImages/20151106184501.jpg

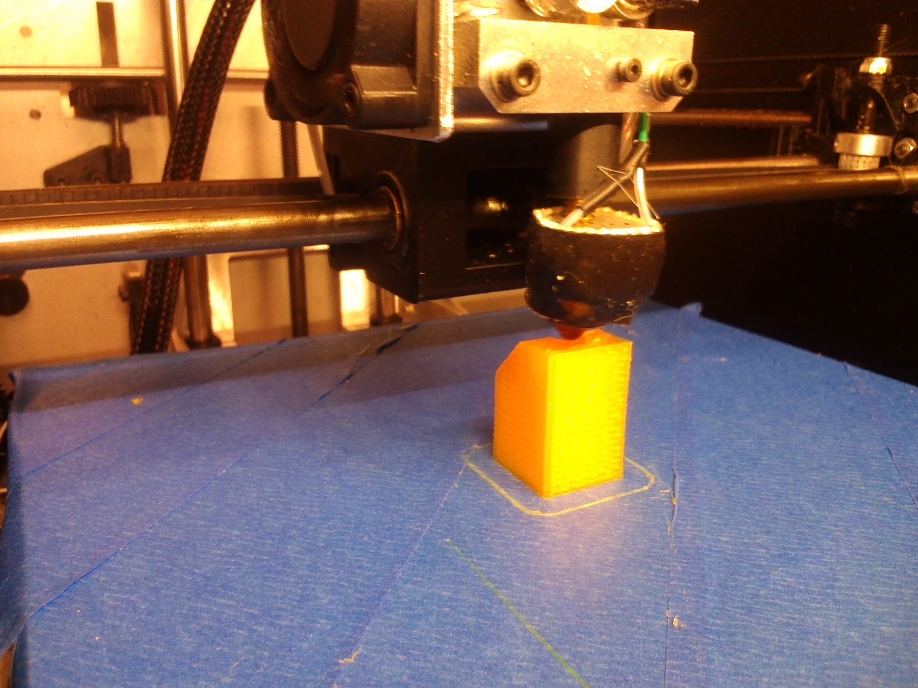
4013 Senior Design/galleryImages/20151106184501.jpg
