team2seniordesignwiki/OmegaBlade/4013 Senior Design/galleryImages/bladeGripConnectedPrototype.jpg

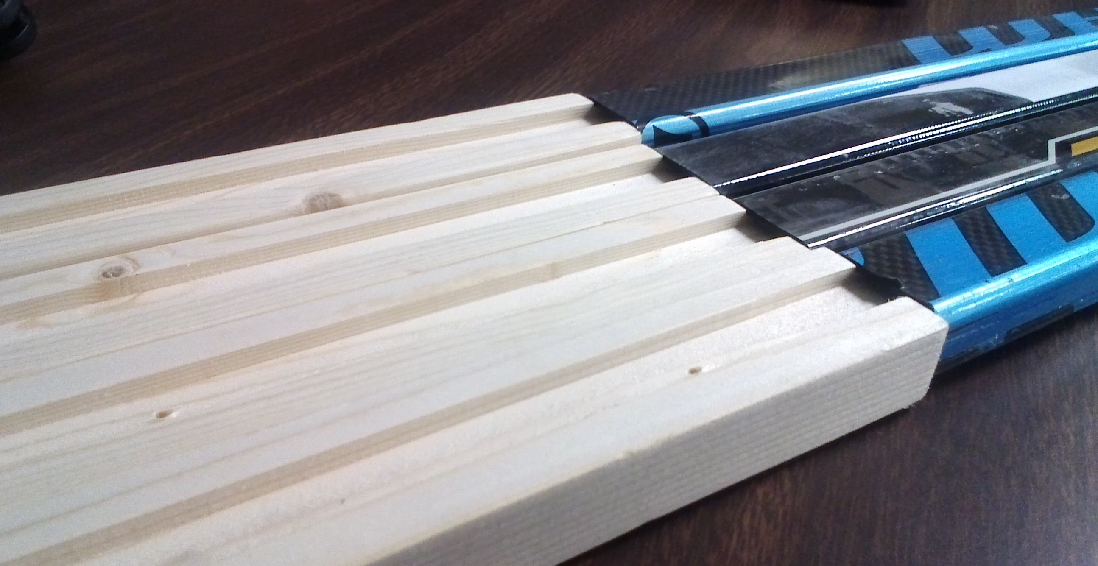
4013 Senior Design/galleryImages/bladeGripConnectedPrototype.jpg
