team2seniordesignwiki/OmegaBlade/4013 Senior Design/galleryImages/bladeTray2.jpg

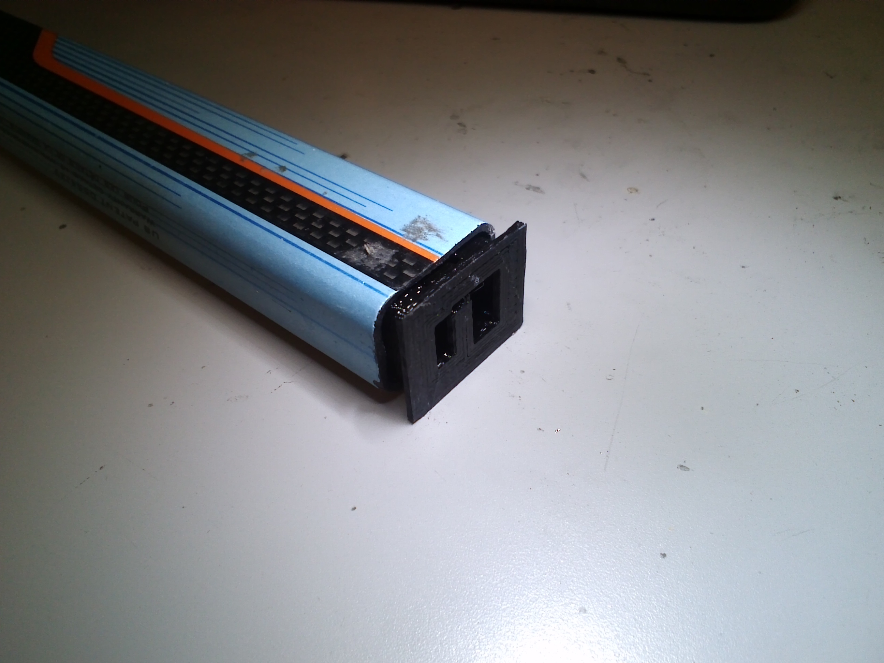
4013 Senior Design/galleryImages/bladeTray2.jpg
