team2seniordesignwiki/OmegaBlade/4013 Senior Design/galleryImages/Christian's Level 1 Functional Block.png

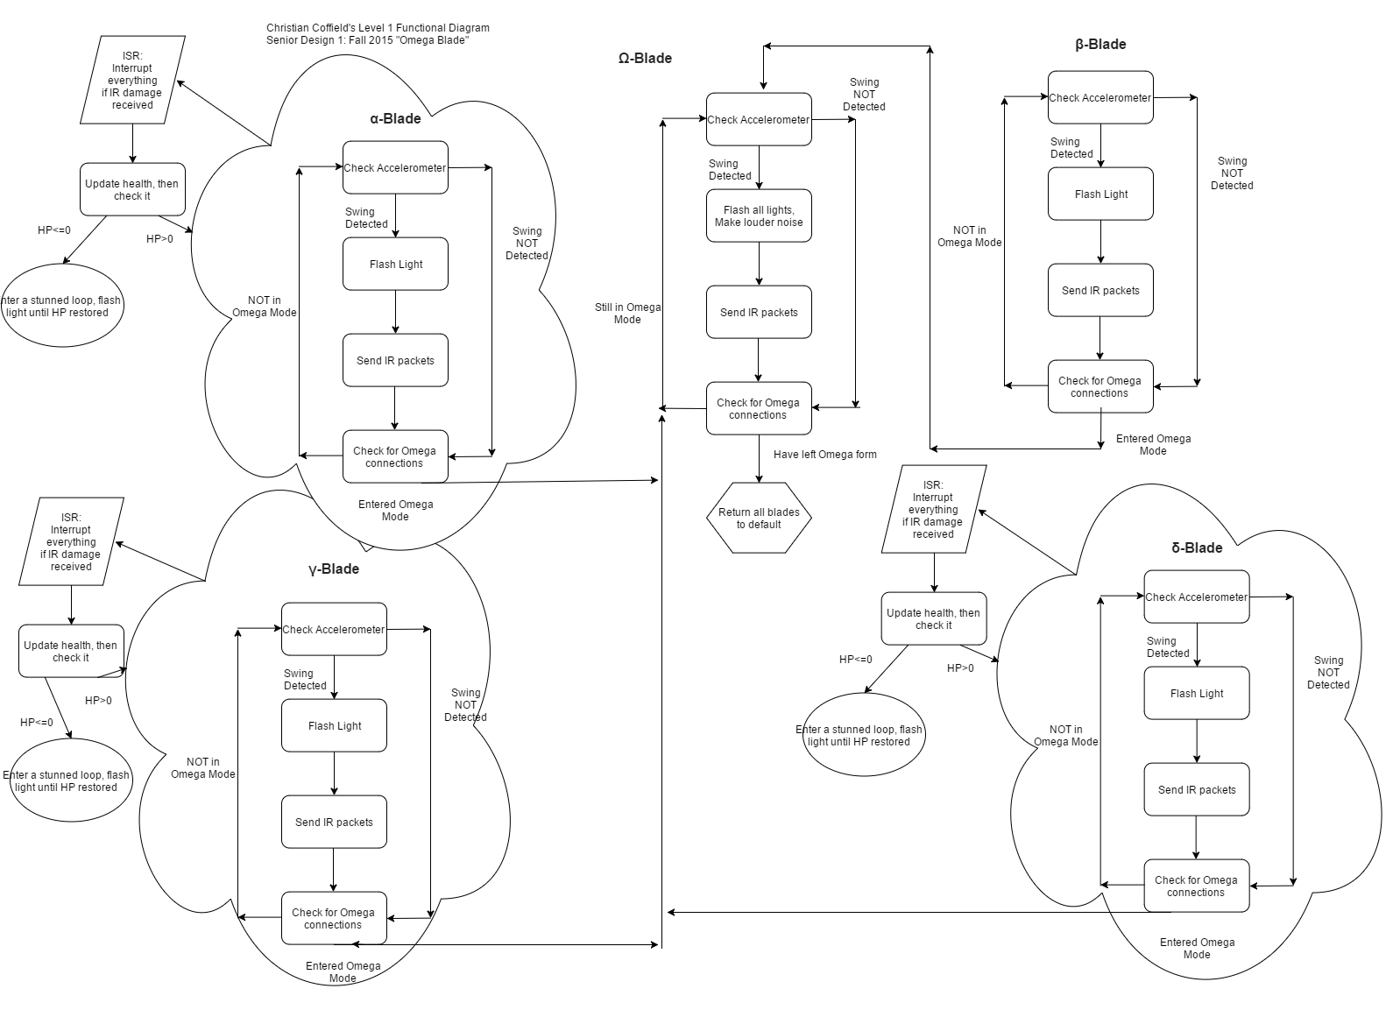
4013 Senior Design/galleryImages/Christian's Level 1 Functional Block.png
