team2seniordesignwiki/OmegaBlade/4013 Senior Design/galleryImages/internalGripTray.jpg

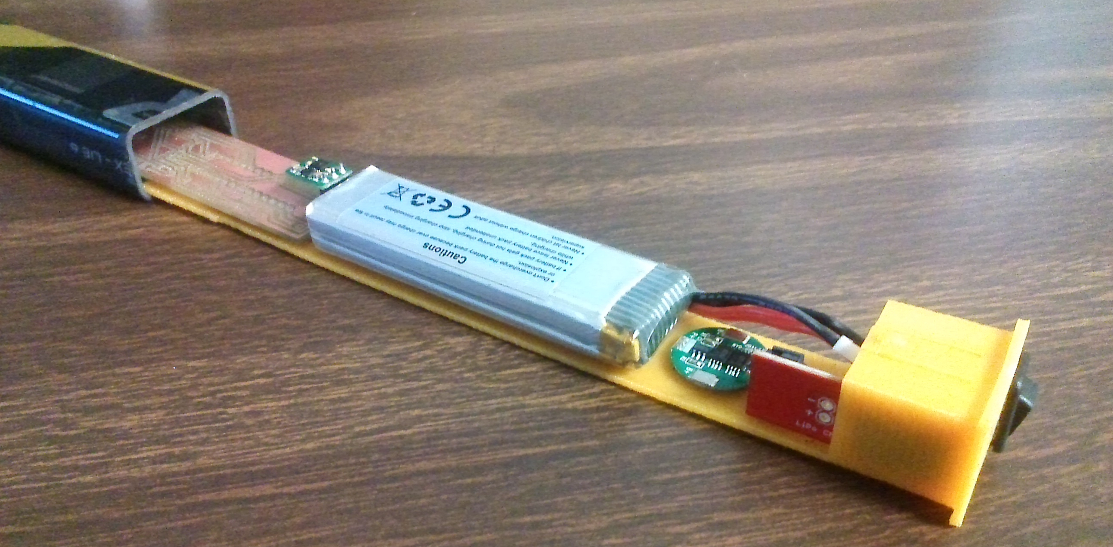
4013 Senior Design/galleryImages/internalGripTray.jpg
