team2seniordesignwiki/OmegaBlade/4013 Senior Design/galleryImages/ledStripsDone.jpg

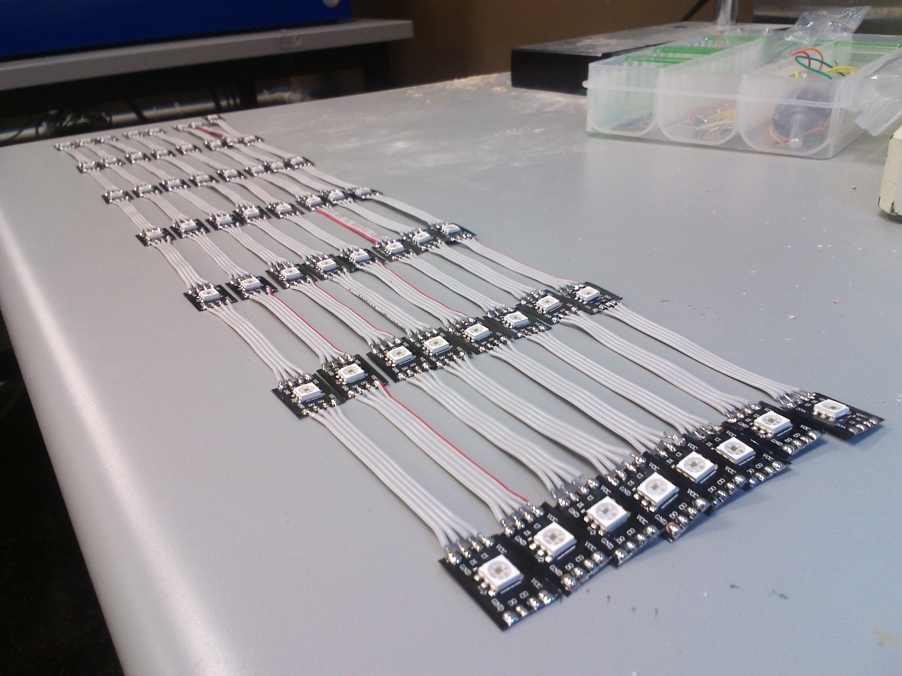
4013 Senior Design/galleryImages/ledStripsDone.jpg
