team2seniordesignwiki/OmegaBlade/4013 Senior Design/galleryImages/originalImages/adafruitAudioBoard.jpg

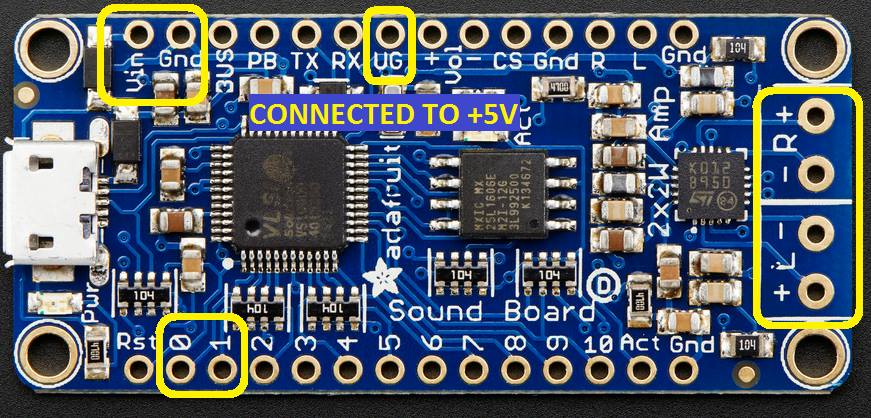
4013 Senior Design/galleryImages/originalImages/adafruitAudioBoard.jpg
