team2seniordesignwiki/OmegaBlade/4013 Senior Design/galleryImages/originalImages/bladeTray1.jpg

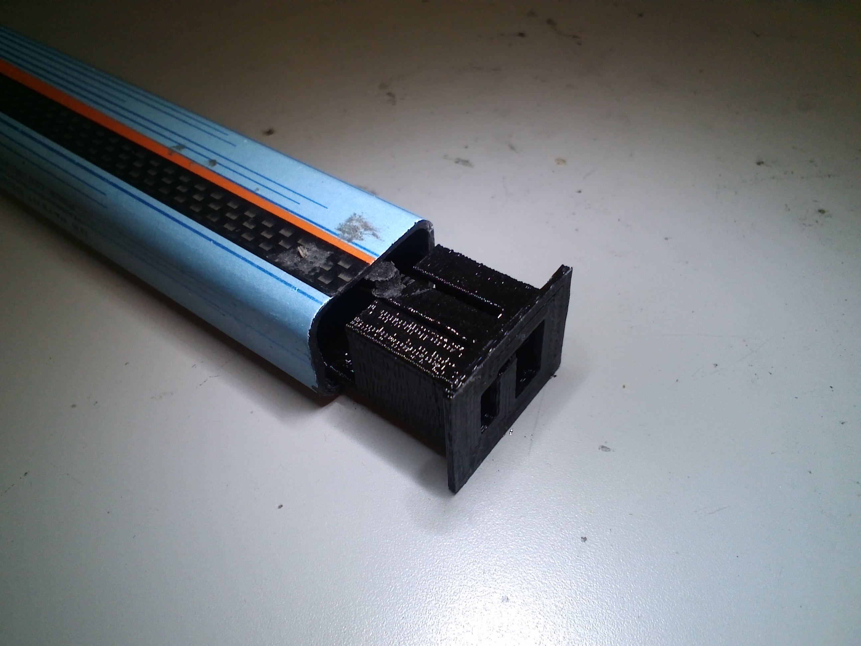
4013 Senior Design/galleryImages/originalImages/bladeTray1.jpg
