team2seniordesignwiki/OmegaBlade/4013 Senior Design/galleryImages/originalImages/bladeTrayPrototype.jpg

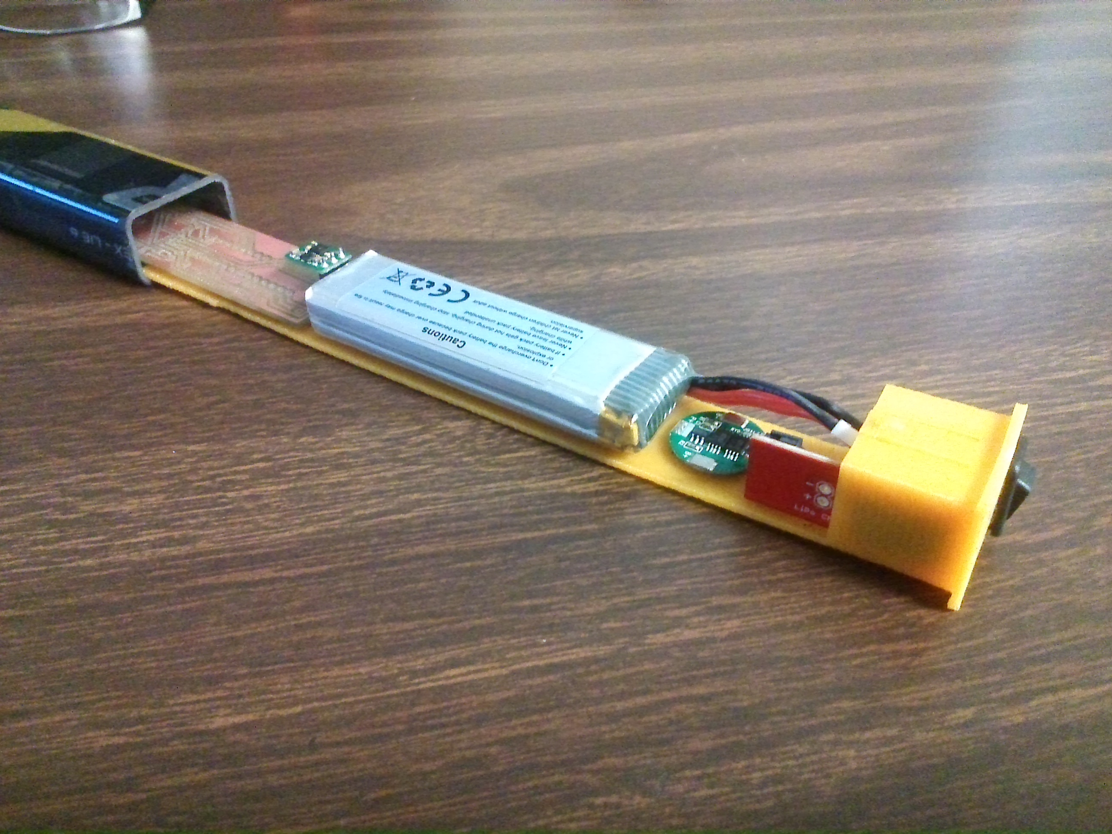
4013 Senior Design/galleryImages/originalImages/bladeTrayPrototype.jpg
