team2seniordesignwiki/OmegaBlade/4013 Senior Design/galleryImages/originalImages/connectorSizeComparison.jpg

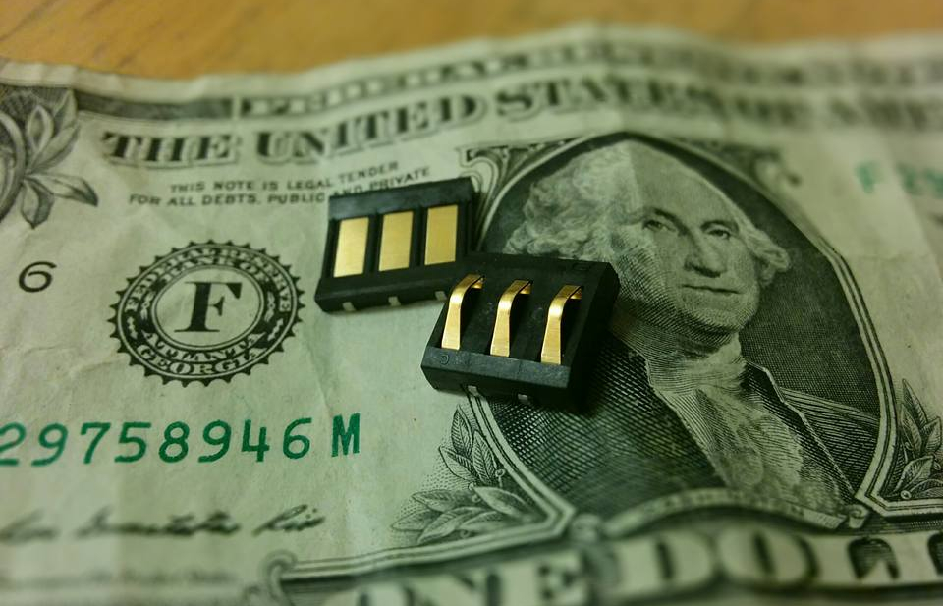
4013 Senior Design/galleryImages/originalImages/connectorSizeComparison.jpg
