team2seniordesignwiki/OmegaBlade/4013 Senior Design/galleryImages/originalImages/integrationPowerBoardHotGlue.jpg

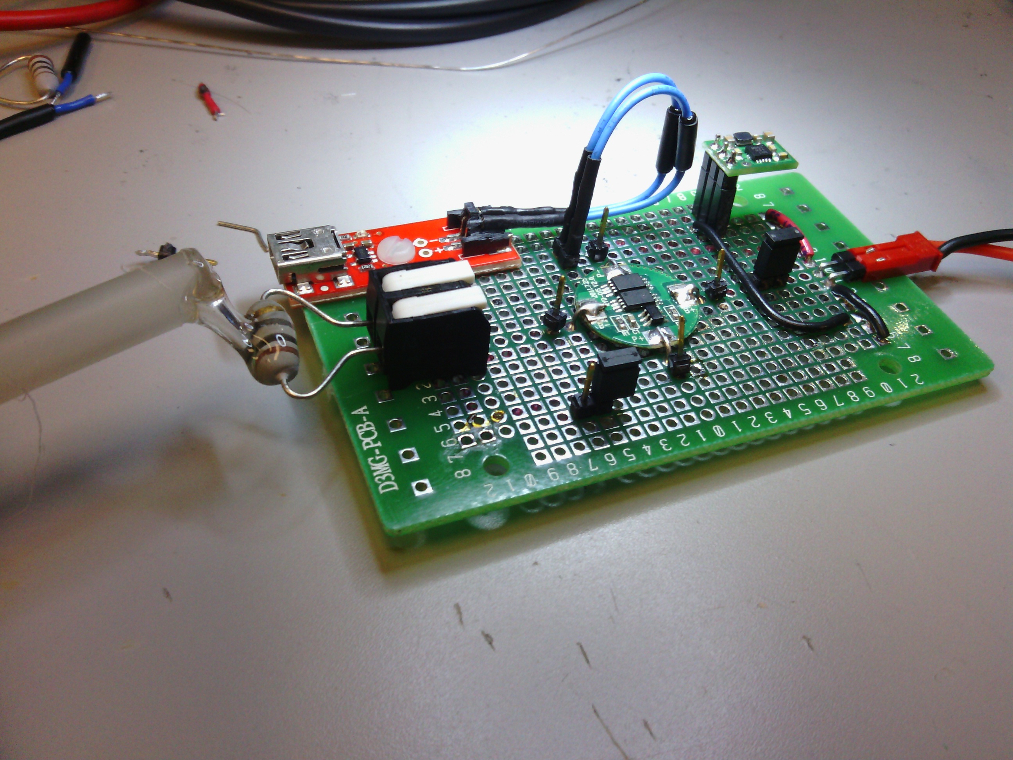
4013 Senior Design/galleryImages/originalImages/integrationPowerBoardHotGlue.jpg
