team2seniordesignwiki/OmegaBlade/4013 Senior Design/galleryImages/originalImages/irReceiver.jpg

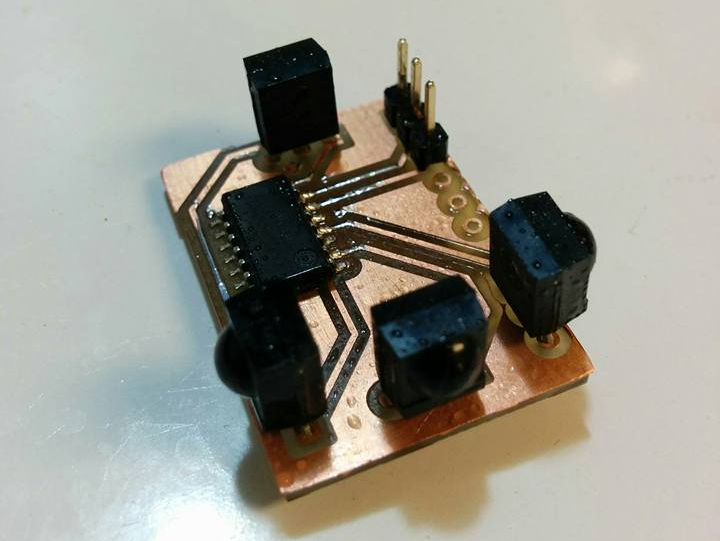
4013 Senior Design/galleryImages/originalImages/irReceiver.jpg
