team2seniordesignwiki/OmegaBlade/4013 Senior Design/galleryImages/originalImages/irTransmitter.jpg

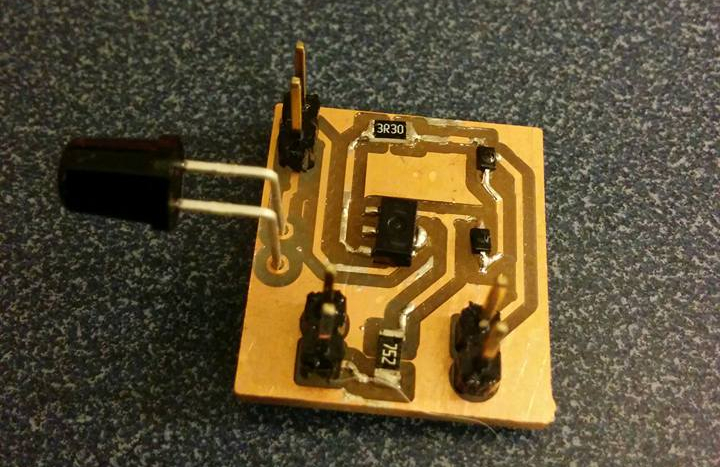
4013 Senior Design/galleryImages/originalImages/irTransmitter.jpg
