team2seniordesignwiki/OmegaBlade/4013 Senior Design/galleryImages/originalImages/ledStrips.jpg

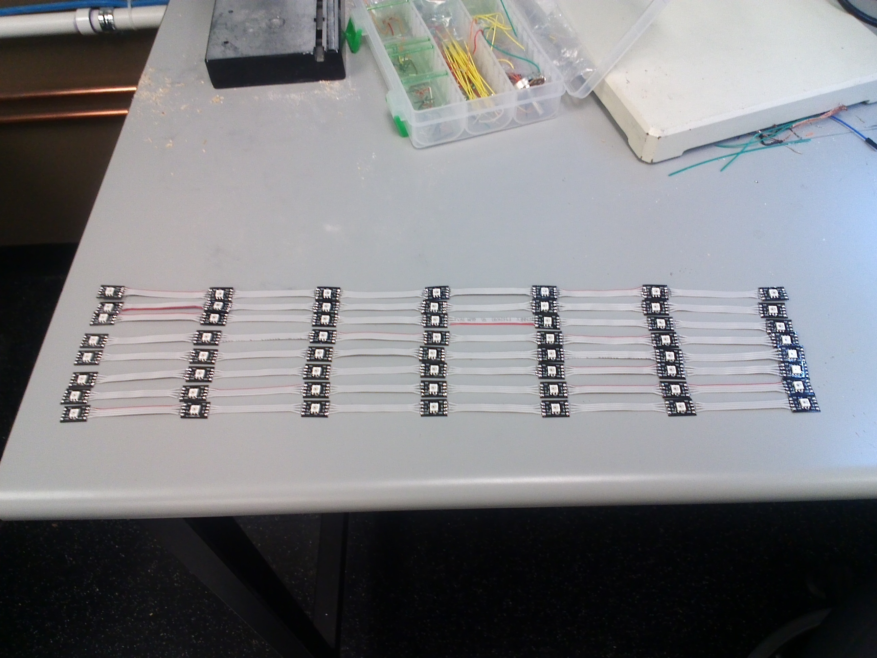
4013 Senior Design/galleryImages/originalImages/ledStrips.jpg
