team2seniordesignwiki/OmegaBlade/4013 Senior Design/galleryImages/originalImages/lipoChargerLed.jpg

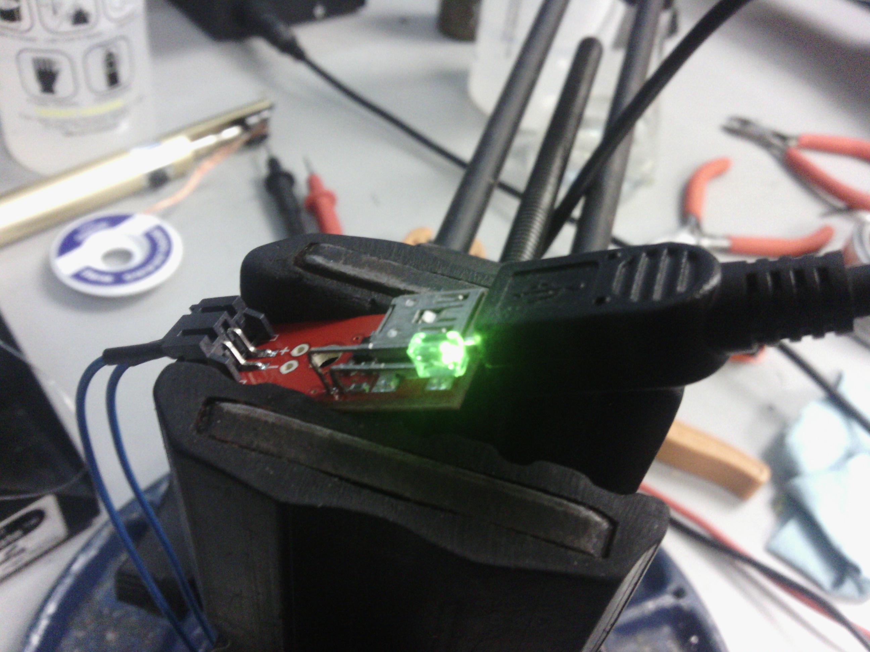
4013 Senior Design/galleryImages/originalImages/lipoChargerLed.jpg
