team2seniordesignwiki/OmegaBlade/4013 Senior Design/galleryImages/originalImages/pcbPrototypeBoardLayout.jpg

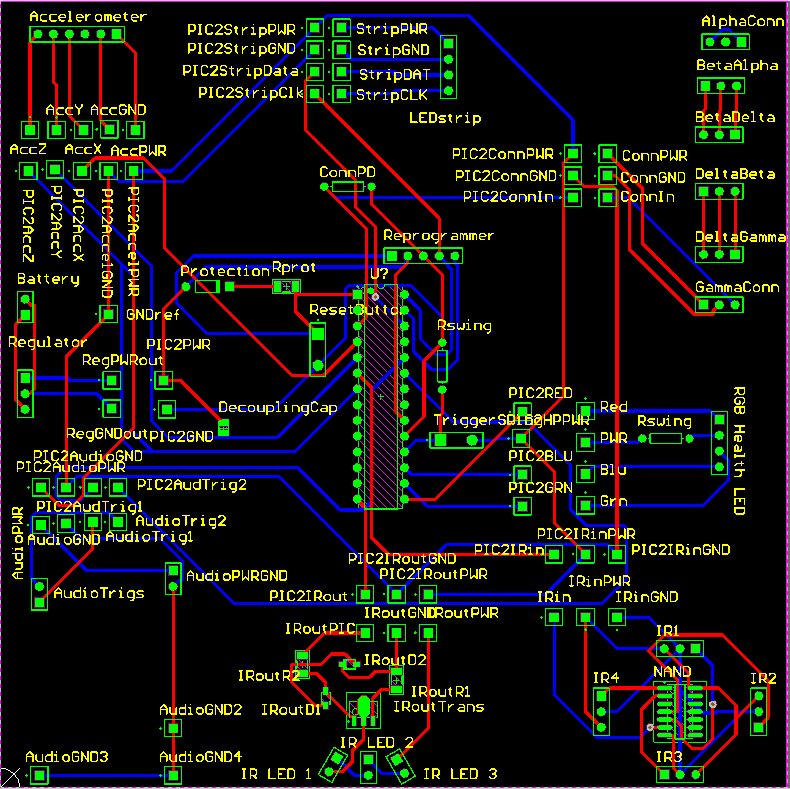
4013 Senior Design/galleryImages/originalImages/pcbPrototypeBoardLayout.jpg
