team2seniordesignwiki/OmegaBlade/4013 Senior Design/galleryImages/originalImages/pcbPrototypeSchematic.jpg

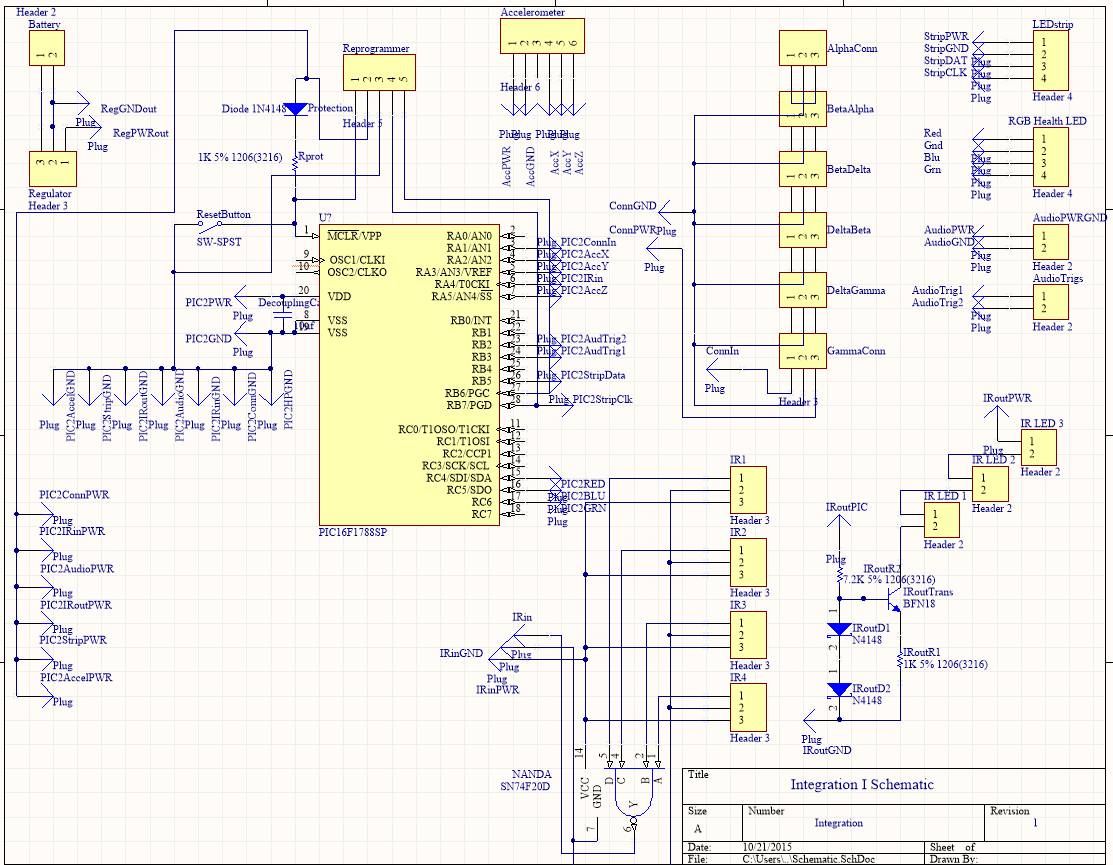
4013 Senior Design/galleryImages/originalImages/pcbPrototypeSchematic.jpg
