team2seniordesignwiki/OmegaBlade/4013 Senior Design/galleryImages/originalImages/rgbLED_pic_prototype1rotated.jpg

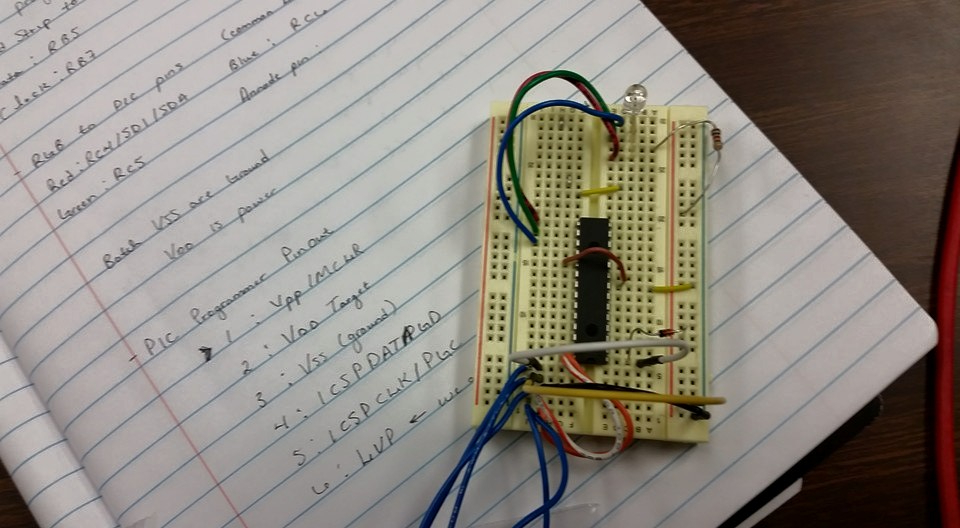
4013 Senior Design/galleryImages/originalImages/rgbLED_pic_prototype1rotated.jpg
