team2seniordesignwiki/OmegaBlade/4013 Senior Design/galleryImages/originalImages/walkeraLipo.jpg

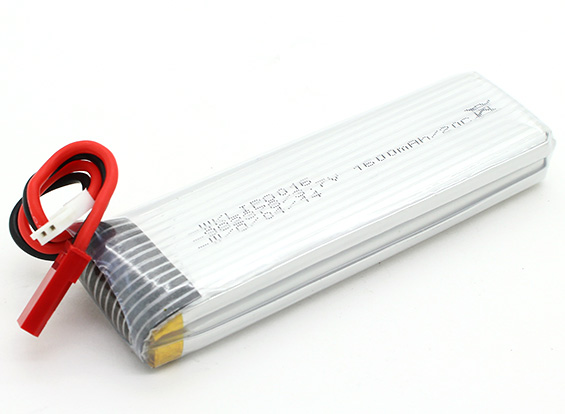
4013 Senior Design/galleryImages/originalImages/walkeraLipo.jpg
