team2seniordesignwiki/OmegaBlade/4013 Senior Design/galleryImages/originalImages/woodShop.jpg

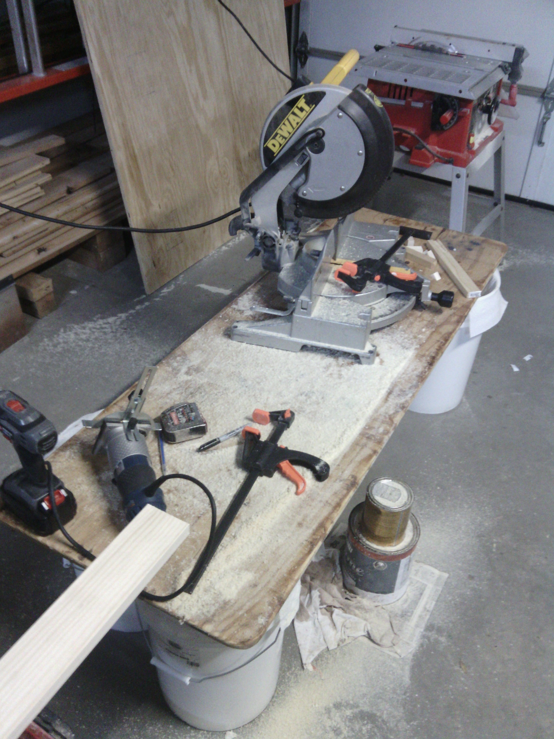
4013 Senior Design/galleryImages/originalImages/woodShop.jpg
