team2seniordesignwiki/OmegaBlade/4013 Senior Design/galleryImages/rgbLED_pic_prototype2.jpg

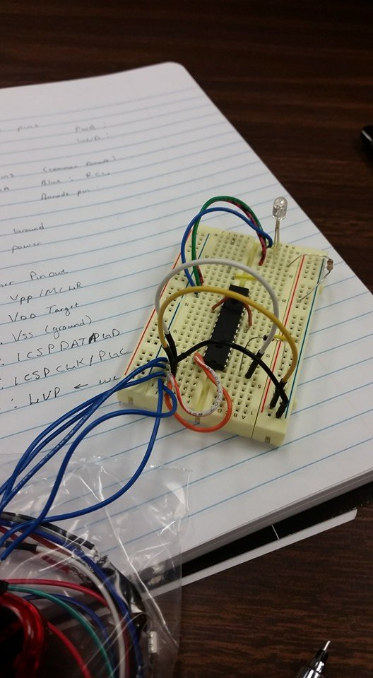
4013 Senior Design/galleryImages/rgbLED_pic_prototype2.jpg
