team2seniordesignwiki/OmegaBlade/4013 Senior Design/galleryImages/team2members.jpg

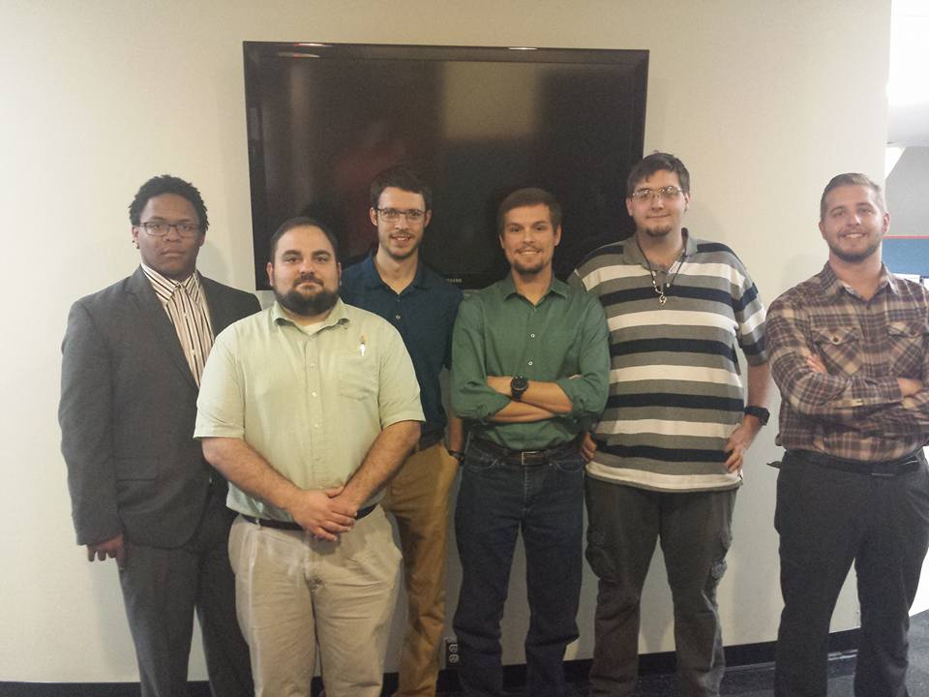
4013 Senior Design/galleryImages/team2members.jpg
