team2seniordesignwiki/OmegaBlade/4013 Senior Design/galleryImages/thumbnails/connectorSizeComparison_thumbnail.jpg

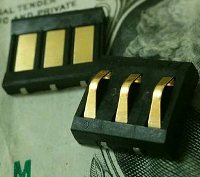
4013 Senior Design/galleryImages/thumbnails/connectorSizeComparison_thumbnail.jpg
