team2seniordesignwiki/OmegaBlade/4013 Senior Design/galleryImages/thumbnails/integrationPowerBoardHotGlue_thumbnail.jpg

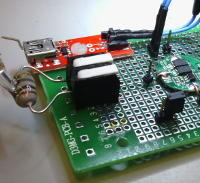
4013 Senior Design/galleryImages/thumbnails/integrationPowerBoardHotGlue_thumbnail.jpg
