team2seniordesignwiki/OmegaBlade/4013 Senior Design/galleryImages/thumbnails/lipoChargerLed_thumbnail.jpg

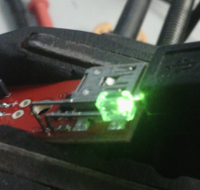
4013 Senior Design/galleryImages/thumbnails/lipoChargerLed_thumbnail.jpg
