team2seniordesignwiki/OmegaBlade/4013 Senior Design/galleryImages/thumbnails/rgbLED_pic_prototype1rotated_thumbnail.jpg

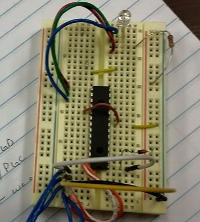
4013 Senior Design/galleryImages/thumbnails/rgbLED_pic_prototype1rotated_thumbnail.jpg
