team2seniordesignwiki/OmegaBlade/4013 Senior Design/Images/integration1_pcb.JPG

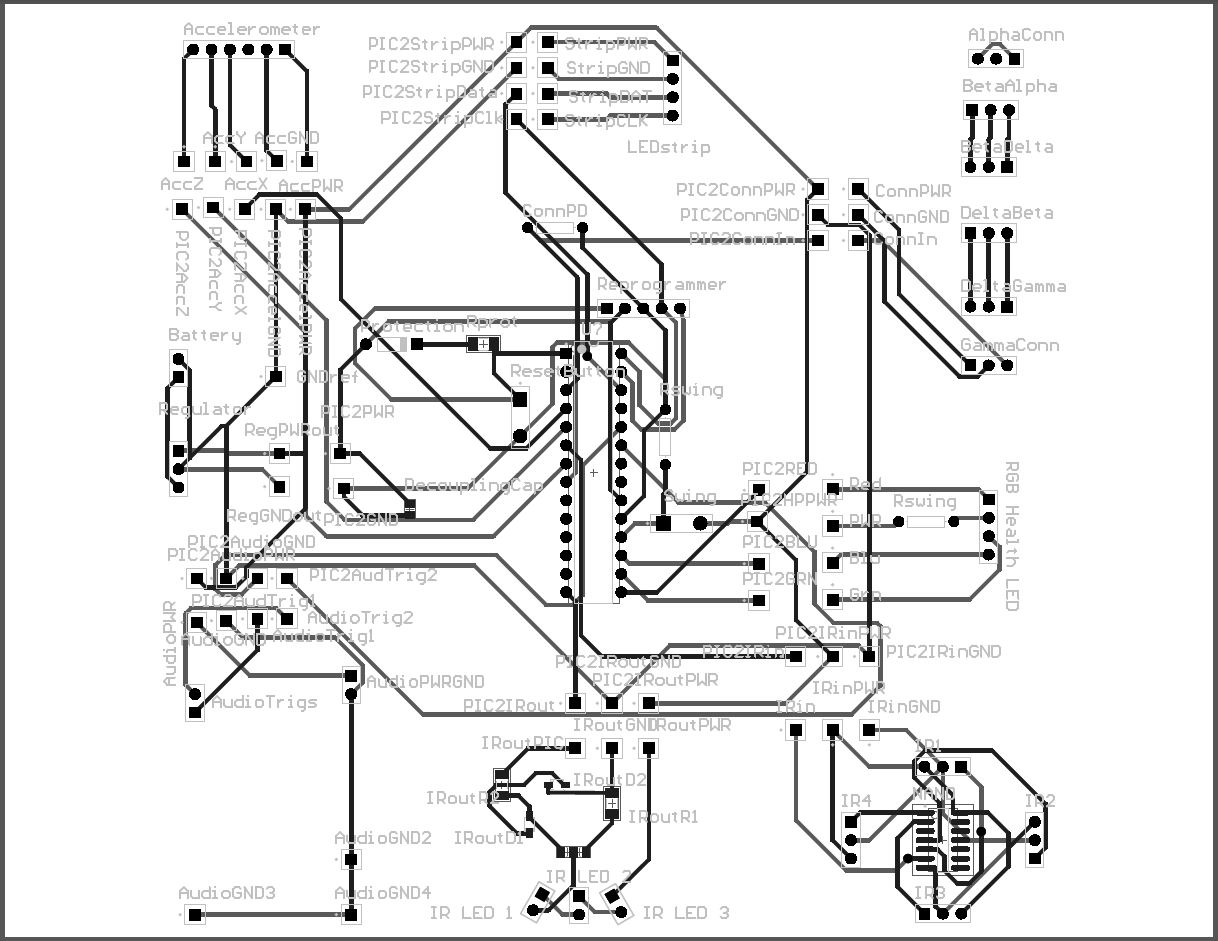
4013 Senior Design/Images/integration1_pcb.JPG
