team2seniordesignwiki/OmegaBlade/4013 Senior Design/Managerial Docs/Budget and Costing/Receipts-Invoices/DigiKey-10-6-15.PNG

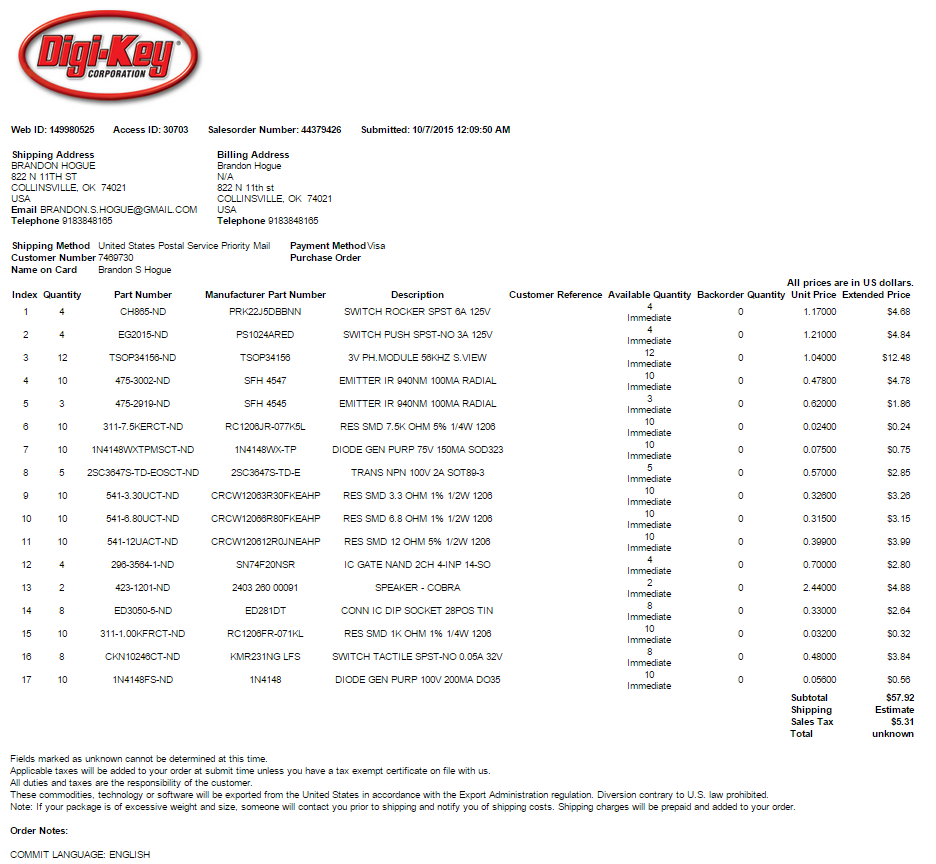
4013 Senior Design/Managerial Docs/Budget and Costing/Receipts-Invoices/DigiKey-10-6-15.PNG
