team2seniordesignwiki/OmegaBlade/4013 Senior Design/Prototyping/Ben/main_program_flowchart_beta_1.3.JPG

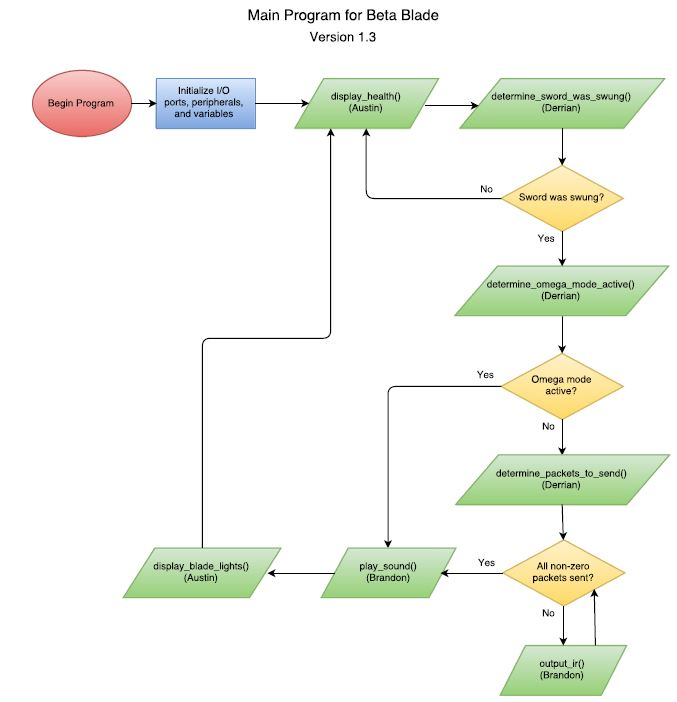
4013 Senior Design/Prototyping/Ben/main_program_flowchart_beta_1.3.JPG
