team2seniordesignwiki/OmegaBlade/4013 Senior Design/Prototyping/Ben/pic_management_block_diagram_1.1.JPG

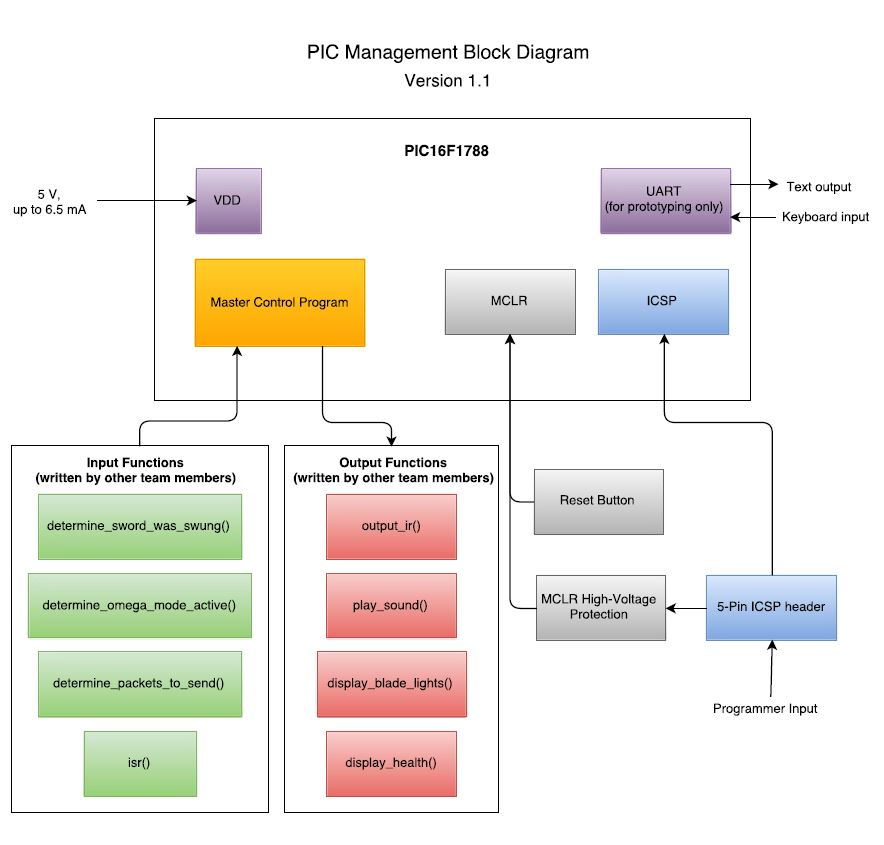
4013 Senior Design/Prototyping/Ben/pic_management_block_diagram_1.1.JPG
