team2seniordesignwiki/OmegaBlade/4013 Senior Design/Prototyping/Ben/prototype_schematic.JPG

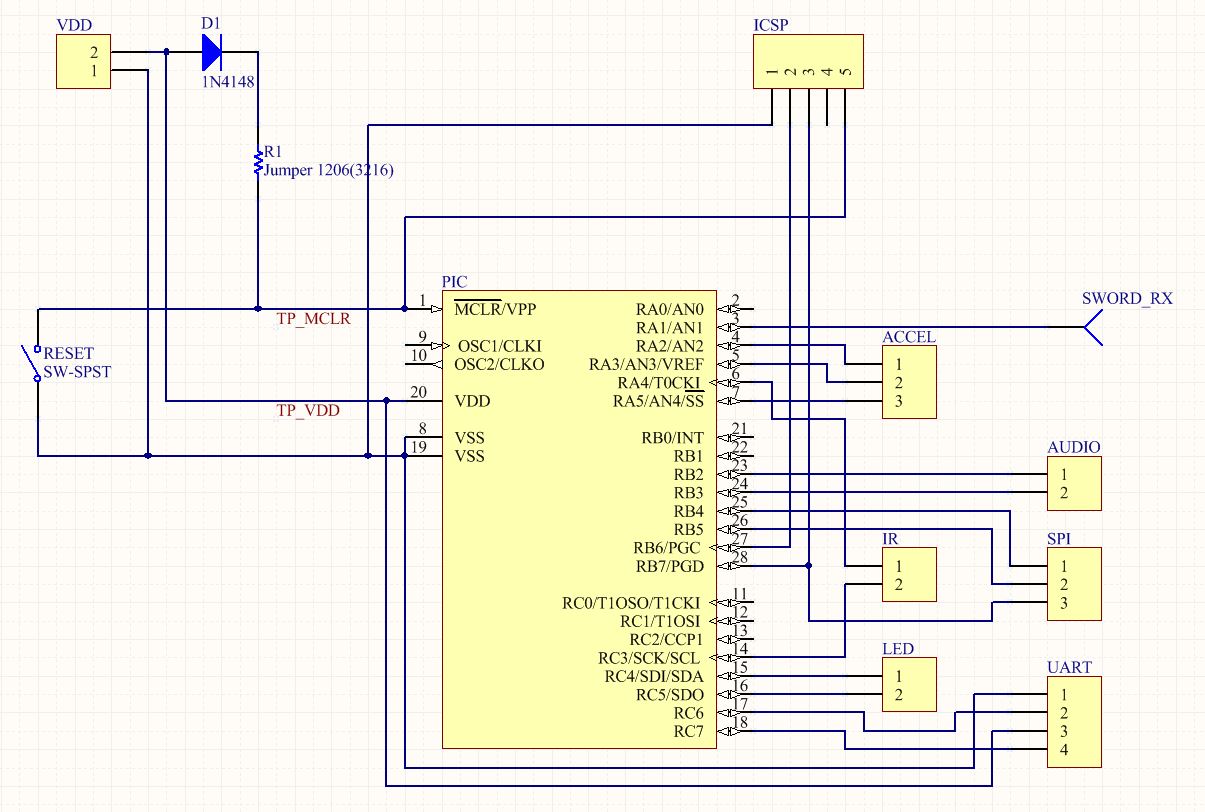
4013 Senior Design/Prototyping/Ben/prototype_schematic.JPG
