team2seniordesignwiki/OmegaBlade/4013 Senior Design/Prototyping/Brandon/IR/Receive/irReceiverPrototypePCB.PNG

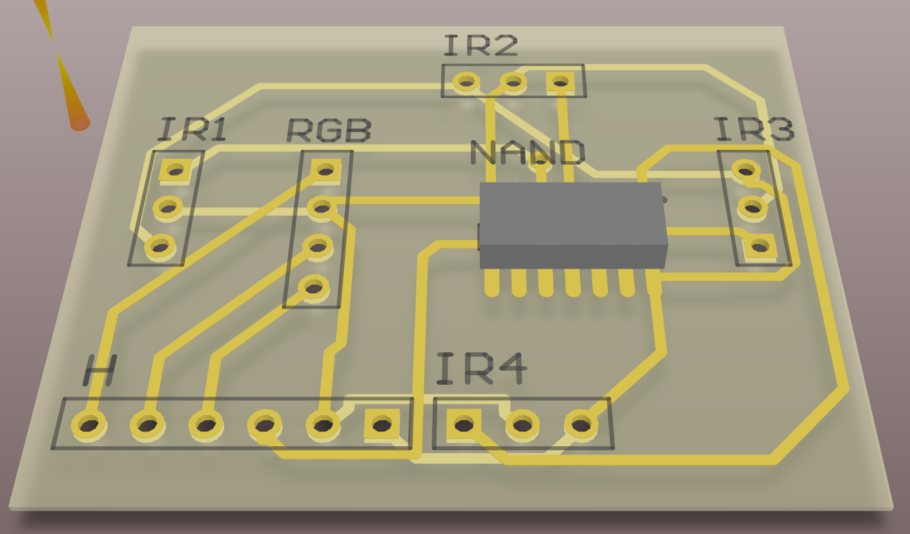
4013 Senior Design/Prototyping/Brandon/IR/Receive/irReceiverPrototypePCB.PNG
