team2seniordesignwiki/OmegaBlade/4013 Senior Design/Prototyping/Brandon/IR/Transmit/irTransmitterPrototypingBoardLayout3D.PNG

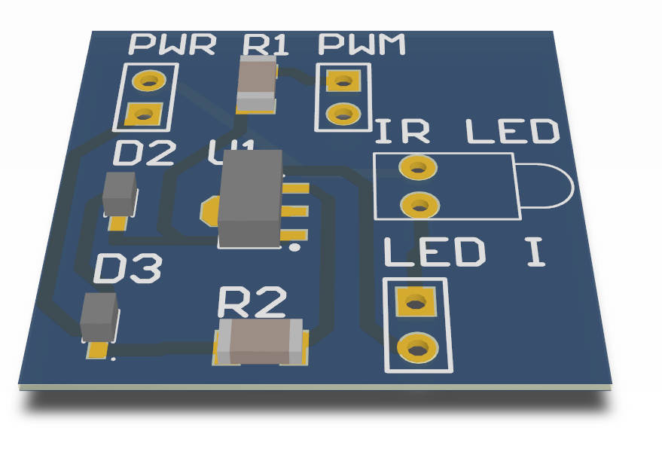
4013 Senior Design/Prototyping/Brandon/IR/Transmit/irTransmitterPrototypingBoardLayout3D.PNG
