team2seniordesignwiki/OmegaBlade/4013 Senior Design/Research/Ben/PIC/main_program_flowchart_beta_1.1.PNG

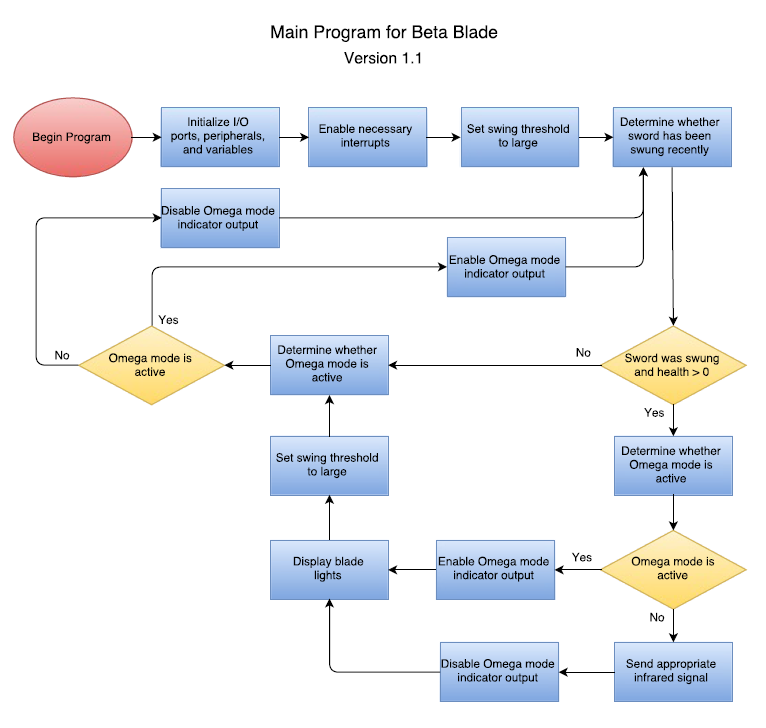
4013 Senior Design/Research/Ben/PIC/main_program_flowchart_beta_1.1.PNG
