team2seniordesignwiki/OmegaBlade/4013 Senior Design/Research/Ben/PIC/main_program_flowchart_secondary_1.0.PNG

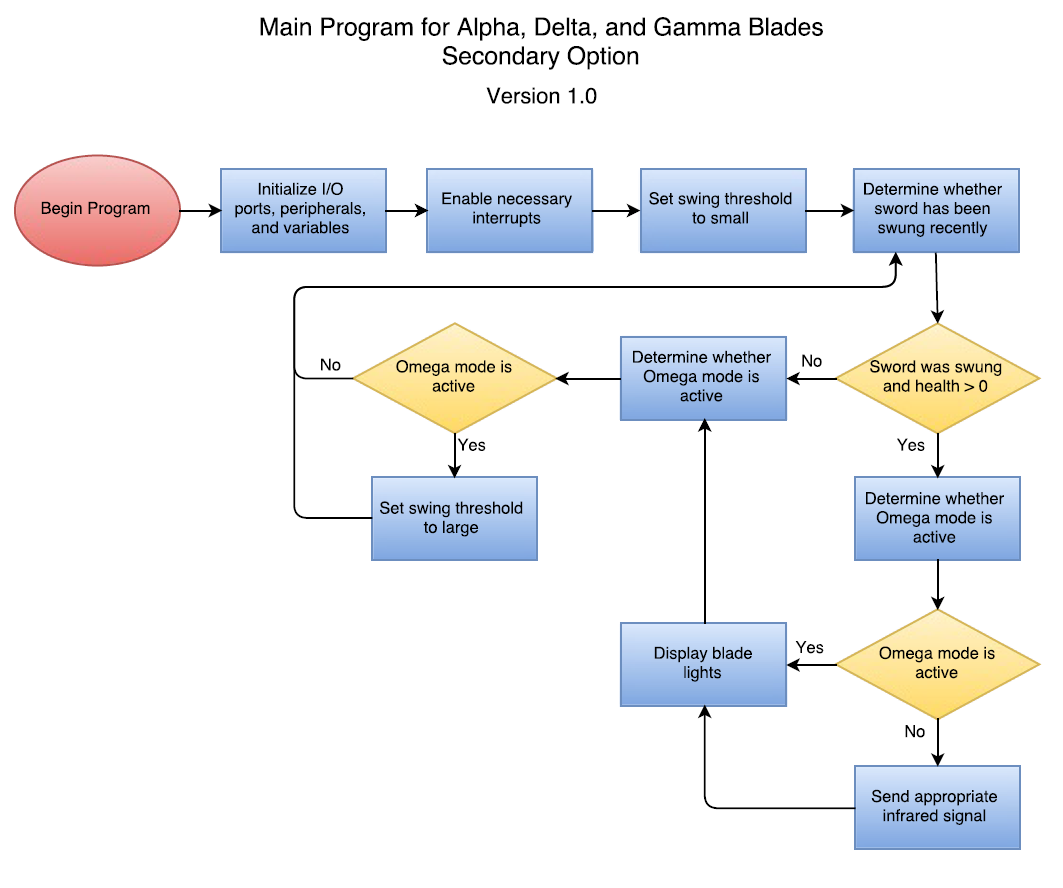
4013 Senior Design/Research/Ben/PIC/main_program_flowchart_secondary_1.0.PNG
