team2seniordesignwiki/OmegaBlade/4013 Senior Design/Research/Ben/PIC/mcu_schematic_1.0.PNG

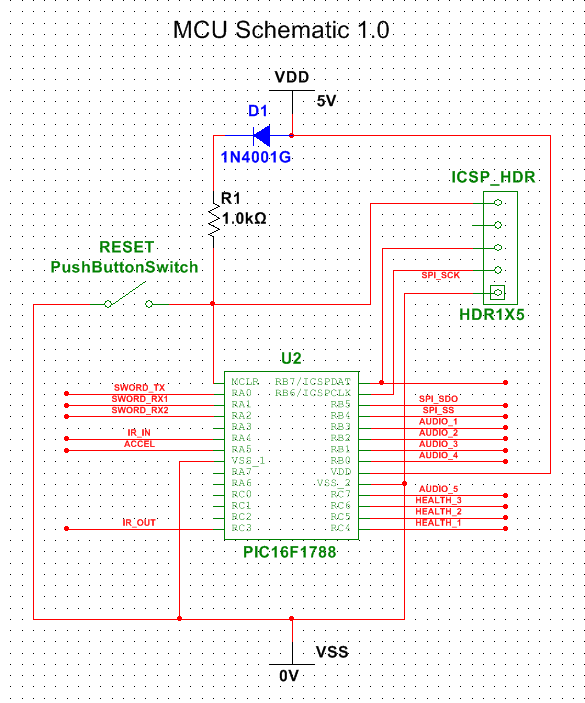
4013 Senior Design/Research/Ben/PIC/mcu_schematic_1.0.PNG
