team2seniordesignwiki/OmegaBlade/4013 Senior Design/Research/Ben/PIC/mcu_secondary_schematic_1.0.JPG

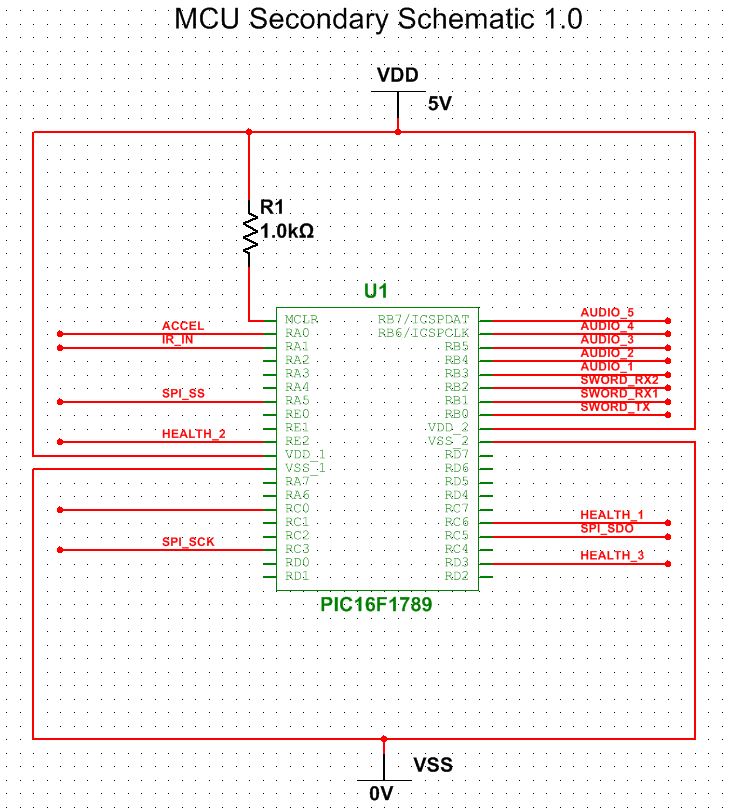
4013 Senior Design/Research/Ben/PIC/mcu_secondary_schematic_1.0.JPG
