team2seniordesignwiki/OmegaBlade/4013 Senior Design/Research/Ben/PIC/pic_management_block_diagram_secondary_1.0.PNG

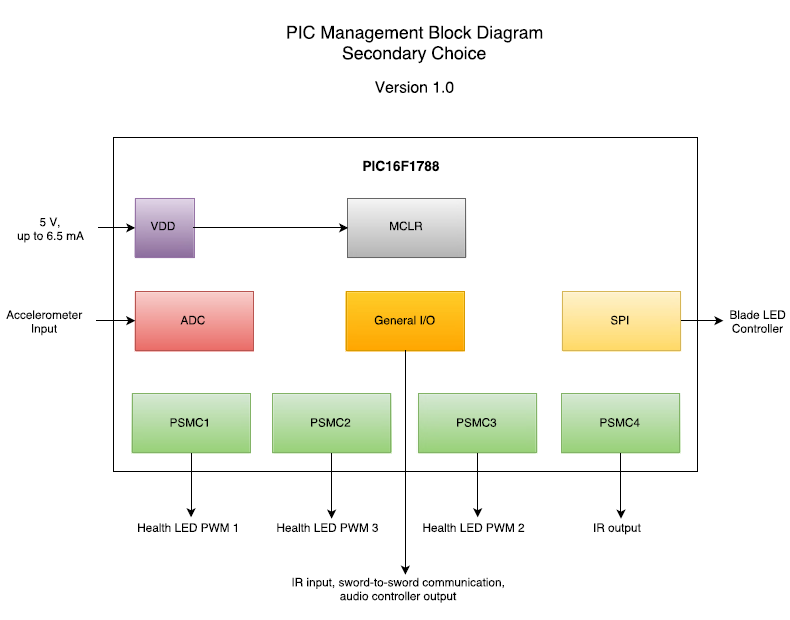
4013 Senior Design/Research/Ben/PIC/pic_management_block_diagram_secondary_1.0.PNG
