team2seniordesignwiki/OmegaBlade/4013 Senior Design/Research/Blake/Resources and Other/digikeyEstimatedShipping.PNG

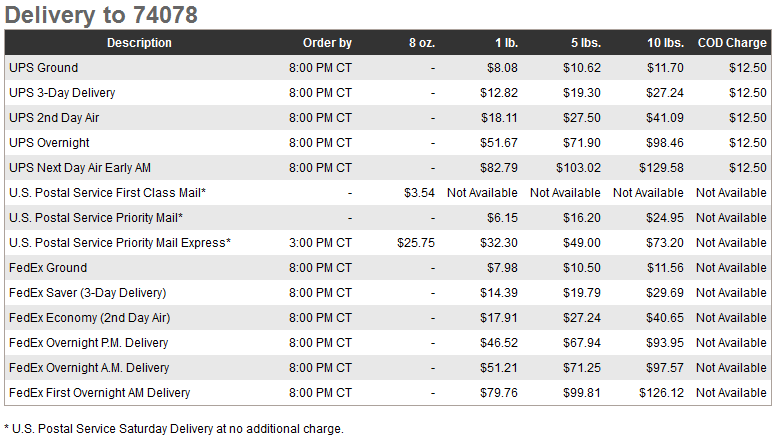
4013 Senior Design/Research/Blake/Resources and Other/digikeyEstimatedShipping.PNG
