team2seniordesignwiki/OmegaBlade/4013 Senior Design/Research/Blake/Resources and Other/LVCBoardSpecs.PNG

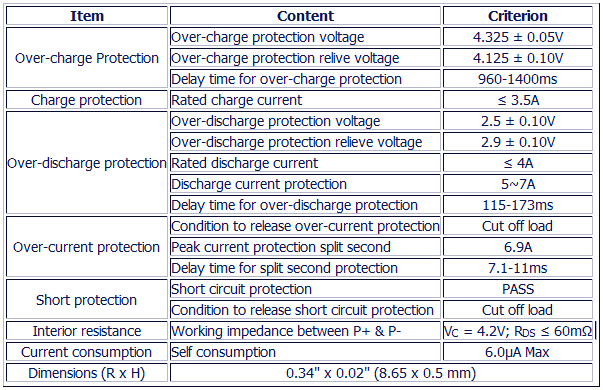
4013 Senior Design/Research/Blake/Resources and Other/LVCBoardSpecs.PNG
