team2seniordesignwiki/OmegaBlade/4013 Senior Design/Research/Blake/Resources and Other/Pololu 5V output SMPS Boost Regulator Specs.PNG

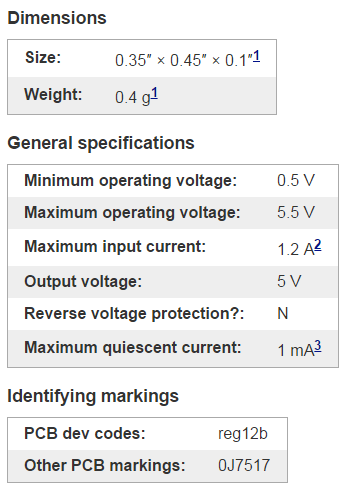
4013 Senior Design/Research/Blake/Resources and Other/Pololu 5V output SMPS Boost Regulator Specs.PNG
