team2seniordesignwiki/OmegaBlade/4013 Senior Design/Research/Brandon Hogue/IR/IR Distance.PNG

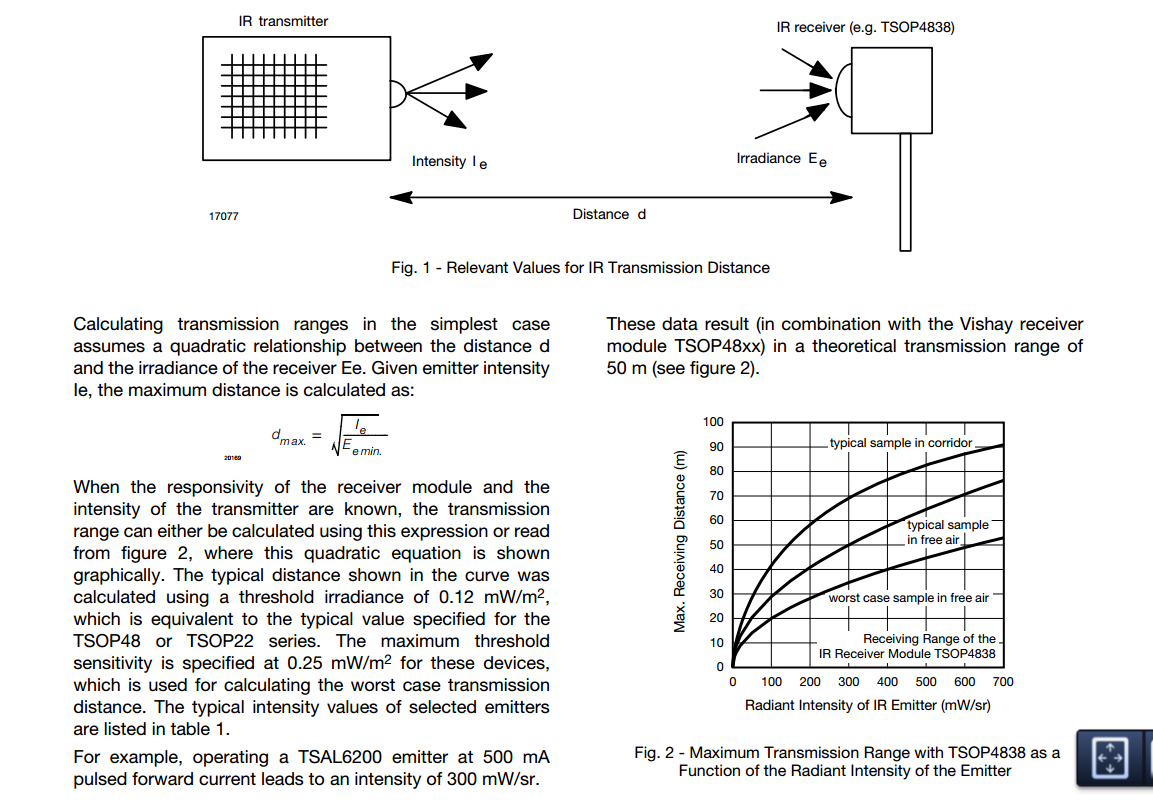
4013 Senior Design/Research/Brandon Hogue/IR/IR Distance.PNG
