team2seniordesignwiki/OmegaBlade/4013 Senior Design/Research/Christian/ISR/INTCON.png

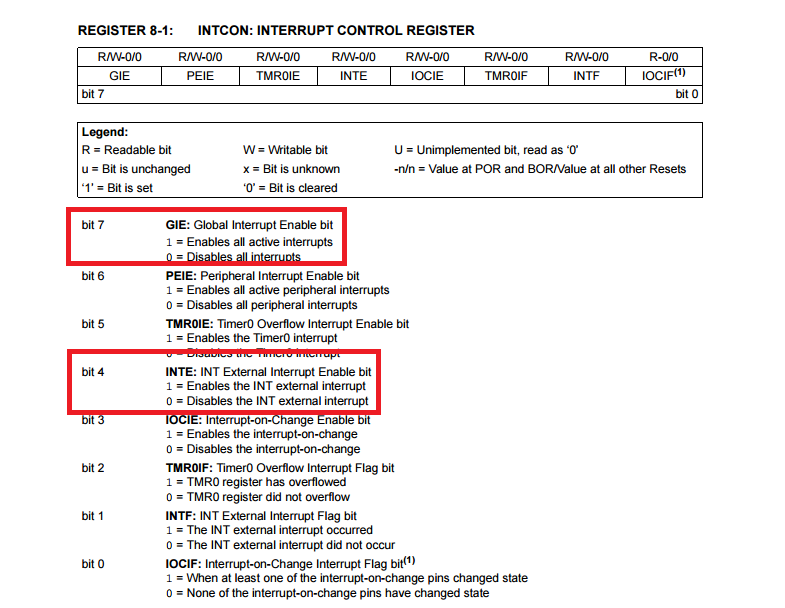
4013 Senior Design/Research/Christian/ISR/INTCON.png
