team2seniordesignwiki/OmegaBlade/4013 Senior Design/Research/Derrian/Accelerometer/WiiMote Data/accelerometerGraph.PNG

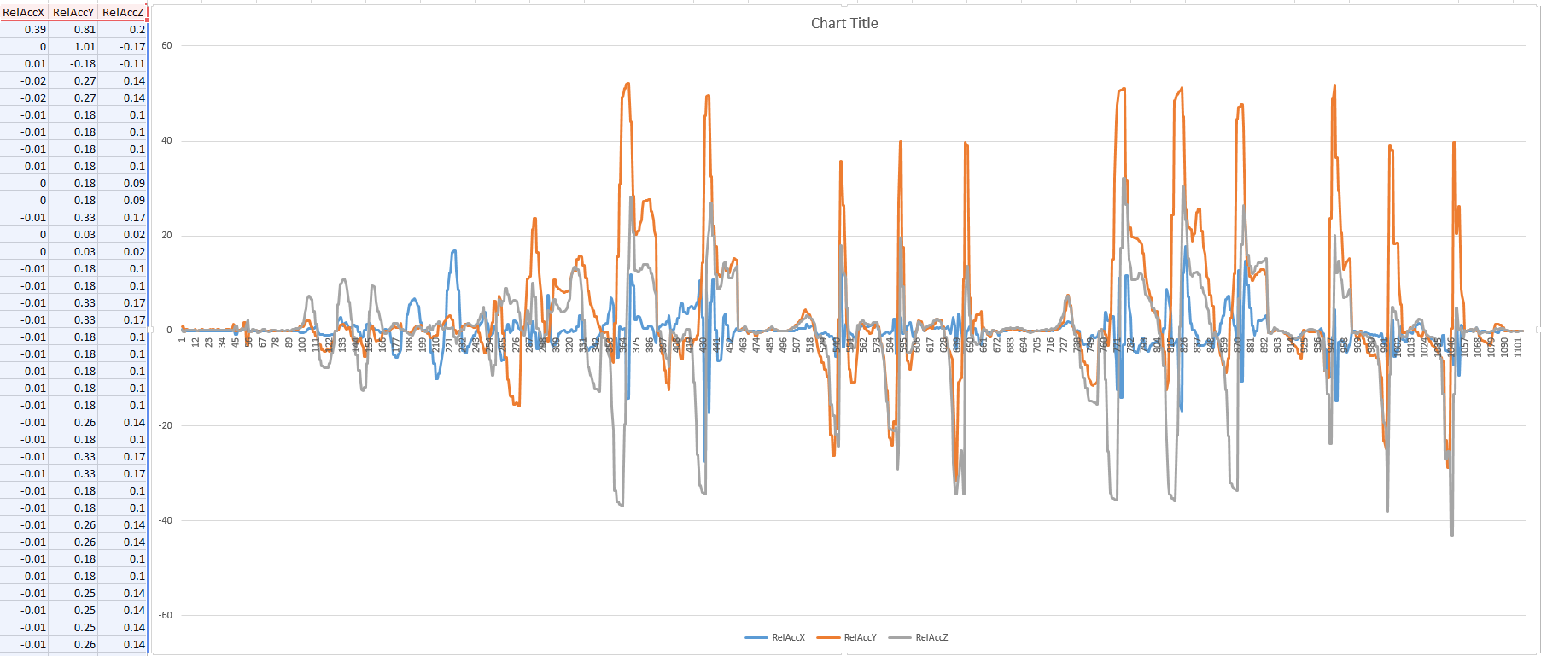
4013 Senior Design/Research/Derrian/Accelerometer/WiiMote Data/accelerometerGraph.PNG
