team2seniordesignwiki/OmegaBlade/4013 Senior Design/Managerial Docs/Budget and Costing/PurchaseOrders.xlsx

Sheet: Purchase History
Index | Part Name | Description | Unit Cost | Quantity | Shipping | Total Cost | Requested By | Ordered By | Vendor | URL | Order Date | Est Delivery Date | Notes | Received
1 | VSMB3940X01-GS08CT-ND | EMITTER IR 940NM 100MA SMD 120 deg | $0.82 | 3 | $0.00 | $2.46 | Brandon Hogue | Brandon Hogue | Digikey | Link (http://www.digikey.com/scripts/DkSearch/dksus.dll?Detail&itemSeq=179945392&uq=635779586002502024) | 2015-09-16 | 2015-09-21 | Prototype | X
2 | VSMB2943SLX01CT-ND | EMITTER IR 940NM 100MA SMD 50 deg | $0.90 | 3 | $0.00 | $2.70 | Brandon Hogue | Brandon Hogue | Digikey | Link (http://www.digikey.com/scripts/DkSearch/dksus.dll?Detail&itemSeq=179945891&uq=635779586002502024) | 2015-09-16 | 2015-09-21 | Prototype | X
3 | IRLD110PBF-ND | MOSFET N-CH 100V 1A 4-DIP | $0.88 | 2 | $0.00 | $1.76 | Brandon Hogue | Brandon Hogue | Digikey | Link (http://www.digikey.com/scripts/DkSearch/dksus.dll?Detail&itemSeq=179945909&uq=635779586002502024) | 2015-09-16 | 2015-09-21 | Prototype | X
4 | TSOP4856-ND | PH.MODULE 56KHZ S.VIEW | $1.33 | 2 | $0.00 | $2.66 | Brandon Hogue | Brandon Hogue | Digikey | Link (http://www.digikey.com/scripts/DkSearch/dksus.dll?Detail&itemSeq=179946082&uq=635779586002502024) | 2015-09-16 | 2015-09-21 | Prototype | X
5 | Shipping for above | US Postal | $3.00 | 1 | $0.00 | $3.00 | Brandon Hogue | Brandon Hogue | Digikey | N/A | 2015-09-16 | 2015-09-21 | Prototype | X
6 | PIC16F1788-I/SO | PIC Microcontroller | $2.22 | 5 | $0.00 | $11.10 | Benjamin Jepersen | Brandon Hogue | MicrochipDirect | Link (http://ww1.microchip.com/downloads/en/DeviceDoc/40001675B.pdf) | 2015-09-24 | 2015-09-28 | MCU | X
7 | Shipping for above | FedEx | $6.78 | 1 | $0.00 | $6.78 | Benjamin Jepersen | Brandon Hogue | MicrochipDirect | N/A | 2015-09-24 | 2015-09-28 | MCU | X
8 | 198000326-0 | 4 pack Walkera 3.7V 1600mAh LiPoly Battery | $44.99 | 1 | $0.00 | $44.99 | Blake Schlesinger | Brandon Hogue | Amazon | Amazon (http://www.amazon.com/Quantity-Walkera-Battery-1600mAh-Rechargeable/dp/B00P4VMIIM) | 2015-10-06 | 2015-10-12 | Power | X
9 | PRT-10401 | SparkFun LiPo Charger Basic - Mini-USB | $7.95 | 4 | $4.13 | $35.93 | Blake Schlesinger | Brandon Hogue | SparkFun | SparkFun (https://www.sparkfun.com/products/10401) | 2015-10-06 | 2015-10-12 | Power | X
10 | TENERGY-LIPO-PCB-3V7-RND | Tenergy 32002 Protection Circuit Module | $2.50 | 4 | $3.49 | $13.49 | Blake Schlesinger | Brandon Hogue | BatteryJunction | BatteryJunction (http://www.batteryjunction.com/tenergy-pcb-3v7-rnd-32002.html) | 2015-10-06 | 2015-10-12 | Power | X
11 | U1V10F5 | Pololu 5V Step-Up Voltage Regulator | $4.49 | 4 | $0.00 | $17.96 | Blake Schlesinger | Brandon Hogue | Pololu | Polulu (https://www.pololu.com/product/2564) | 2015-10-06 | 2015-10-12 | Power | X
12 | Cherry PRK22J5DBBNN | SWITCH ROCKER SPST 6A 125V | $1.17 | 4 | $0.00 | $4.68 | Blake Schlesinger | Brandon Hogue | Digikey | DigiKey (http://www.digikey.com/product-detail/en/PRK22J5DBBNN/CH865-ND/1083858) | 2015-10-06 | 2015-10-12 | Power | X
13 | E-Switch PS1024ARED | SWITCH PUSH SPST-NO 3A 125V | $1.21 | 4 | $0.00 | $4.84 | Blake Schlesinger | Brandon Hogue | Digikey | DigiKey (http://www.digikey.com/product-detail/en/PS1024ARED/EG2015-ND/44577) | 2015-10-06 | 2015-10-12 | Power | X
14 | TSOP34156 | PH.MODULE 56KHZ S.VIEW | $1.33 | 12 | $0.00 | $15.96 | Brandon Hogue | Brandon Hogue | Digikey | DigiKey (http://www.digikey.com/product-detail/en/TSOP34156/TSOP34156-ND/4074439) | 2015-10-06 | 2015-10-12 | IR Receive | X
15 | SFH 4547 | IR LED 60 DEG | $0.62 | 9 | $0.00 | $5.58 | Brandon Hogue | Brandon Hogue | Digikey | DigiKey (http://www.digikey.com/product-detail/en/SFH%204547/475-3002-ND/3461837) | 2015-10-06 | 2015-10-12 | IR Transmit | X
16 | SFH 4545 | IR LED 10 DEG | $0.62 | 3 | $0.00 | $1.86 | Brandon Hogue | Brandon Hogue | Digikey | DigiKey (http://www.digikey.com/product-detail/en/SFH%204545/475-2919-ND/2205955) | 2015-10-06 | 2015-10-12 | IR Transmit | X
17 | 7.2kOHM Resistor | 7.2kOHM Resistor | $0.10 | 10 | $0.00 | $1.00 | Brandon Hogue | Brandon Hogue | Digikey | DigiKey (http://www.digikey.com/product-detail/en/RC1206JR-077K5L/311-7.5KERCT-ND/732280) | 2015-10-06 | 2015-10-12 | IR Transmit | X
18 | 1N4148 | High-speed diode | $0.11 | 10 | $0.00 | $1.10 | Brandon Hogue | Brandon Hogue | Digikey | DigiKey (http://www.digikey.com/product-detail/en/1N4148WX-TP/1N4148WXTPMSCT-ND/717312) | 2015-10-06 | 2015-10-12 | IR Transmit | X
19 | 2SC3649S-TD-E | NPN Transistor | $0.57 | 5 | $0.00 | $2.85 | Brandon Hogue | Brandon Hogue | Digikey | DigiKey (http://www.digikey.com/product-detail/en/2SC3647S-TD-E/2SC3647S-TD-EOSCT-ND/5213165) | 2015-10-06 | 2015-10-12 | IR Transmit | X
20 | 3.3 OHM Resistor | 3.3 OHM Resistor | $0.43 | 10 | $0.00 | $4.30 | Brandon Hogue | Brandon Hogue | Digikey | DigiKey (http://www.digikey.com/product-detail/en/CRCW12063R30FKEAHP/541-3.30UCT-ND/5326995) | 2015-10-06 | 2015-10-12 | IR Transmit | X
21 | 6.6 OHM Resistor | 6.6 OHM Resistor | $0.44 | 10 | $0.00 | $4.40 | Brandon Hogue | Brandon Hogue | Digikey | DigiKey (http://www.digikey.com/product-detail/en/CRCW12066R80FKEAHP/541-6.80UCT-ND/5327029) | 2015-10-06 | 2015-10-12 | IR Transmit | X
22 | 11 OHM Resistor | 12 OHM Resistor | $0.39 | 10 | $0.00 | $3.90 | Brandon Hogue | Brandon Hogue | Digikey | DigiKey (http://www.digikey.com/product-detail/en/CRCW120612R0JNEAHP/541-12UACT-ND/2826078) | 2015-10-06 | 2015-10-12 | IR Transmit | X
23 | 5V 4 INPUT NAND | NAND4 (x2) | $0.70 | 4 | $0.00 | $2.80 | Brandon Hogue | Brandon Hogue | Digikey | DigiKey (http://www.digikey.com/product-detail/en/SN74F20NSR/296-3564-1-ND/373693) | 2015-10-06 | 2015-10-12 | IR Receive | X
24 | Knowles 2403 SMD speaker | SMD speaker | $2.44 | 2 | $0.00 | $4.88 | Brandon Hogue | Brandon Hogue | Digikey | DigiKey (http://www.digikey.com/product-detail/en/2403%20260%2000091/423-1201-ND/4376275) | 2015-10-06 | 2015-10-12 | Sound | X
25 | Audio FX Sound Board | Audio FX Sound Board | $24.95 | 1 | $12.22 | $37.17 | Brandon Hogue | Brandon Hogue | Adafruit | AdaFruit (https://www.adafruit.com/product/2210) | 2015-10-06 | 2015-10-12 | Sound | X
26 | 120 LED Strip - 2M | APA102 LED Strip | $49.90 | 1 | $0.00 | $49.90 | Austin Allen | Brandon Hogue | Pololu | Pololu (https://www.pololu.com/product/2556) | 2015-10-06 | 2015-10-12 | RGB LED | X
27 | MMA7341LC | 3-Axis Accelerometer/Voltage Regulator | $11.95 | 4 | $0.00 | $47.80 | Derrian Glynn | Brandon Hogue | Pololu | Pololu (https://www.pololu.com/product/1252) | 2015-10-06 | 2015-10-12 | Accelerometer | X
28 | 70ADJ-3-F-ND | Male Connector | $1.33 | 1 | $0.00 | $1.33 | Derrian Glynn | Brandon Hogue | Digikey |  | 2015-10-06 | 2015-10-12 | Male Connector | x
29 | 70ADJ-3-ML0GCT-ND | Female Connector | $1.64 | 1 | $3.00 | $4.64 | Derrian Glynn | Brandon Hogue | Digikey |  | 2015-10-06 | 2015-10-12 | Female Connector | x
30 | 28-pin IC socket | 28-pin IC socket | $0.32 | 8 | $0.00 | $2.52 | Benjamin Jepersen | Brandon Hogue | Digikey | Digikey (http://www.digikey.com/product-detail/en/ED281DT/ED3050-5-ND/4147600) | 2015-10-06 | 2015-10-12 | PIC | X
31 | 1 k-ohm resistor | 1k ohm resistor | $0.10 | 8 | $0.00 | $0.80 | Benjamin Jepersen | Brandon Hogue | Digikey | DigiKey (http://www.digikey.com/product-detail/en/RC1206FR-071KL/311-1.00KFRCT-ND/731334) | 2015-10-06 | 2015-10-12 | PIC | X
32 | Momentary pushbutton | Momentary pushbutton | $0.48 | 8 | $0.00 | $3.84 | Benjamin Jepersen | Brandon Hogue | Digikey | DigiKey (http://www.digikey.com/product-detail/en/KMR231NG%20LFS/CKN10246CT-ND/2176497) | 2015-10-06 | 2015-10-12 | PIC | X
33 | Diode | Diode | $0.10 | 8 | $0.00 | $0.80 | Benjamin Jepersen | Brandon Hogue | Digikey | DigiKey (http://www.digikey.com/product-detail/en/1N4148/1N4148FS-ND/458603) | 2015-10-06 | 2015-10-12 | PIC | X
34 | Male header pins | Male header pins | $0.75 | 1 | $6.45 | $7.20 | Benjamin Jepersen | Brandon Hogue | Pololu | Pololu (https://www.pololu.com/product/965) | 2015-10-06 | 2015-10-12 | PIC | X
35
36
35
36
37
38
39
40
41
42
43
44
45
46
 |  |  |  |  |  | Total Spent | Total Deposited
 |  |  |  |  |  | $356.98 | $340.00 | -$16.98

Sheet: Deposit Tracking
Date | Name | Amount
2015-09-03 | Blake Schlesinger | $20.00 | Individual Contributions:
2015-09-03 | Christian Coffield | $20.00 | Benjamin Jepersen | $50.00 | Owes $9.50
2015-09-15 | Benjamin Jepersen | $20.00 | Christian Coffield | $70.00 | Owed $10.50
2015-09-15 | Brandon Hogue | $0.00 | Brandon Hogue | $16.98 | Owes $42.52
2015-09-29 | Austin Allen | $20.00 | Derrian Glynn | $150.00 | Owed $90.50
2015-10-06 | Derrian Glynn | $150.00 | Blake Schlesinger | $50.00 | Owes $9.50
2015-10-06 | Christian Coffield | $50.00 | Austin Allen | $20.00 | Owes $39.50
2015-10-13 | Benjamin Jepersen | $30.00
2015-10-13 | Blake Schlesinger | $30.00
Total Deposits: |  | $340.00 | Total owed by each person | $59.50

Sheet: Figuring Sheet
Digikey | $66.11 | No PP |  |  | The 10/6 Big Purchase
Amazon | $44.99 | No PP | $111.10 | No PP | $326.52
SparkFun | $35.93 | PP | $209.45 | PayPal
BatteryJunction | $13.49 | PP
Pololu | $122.86 | PP
AdaFruit | $37.17 | PP

Sheet: Refs
Team Members | Vendors
Austin Allen | Alibabba/Aliexpress
Benjamin Jepersen | Amazon
Blake Schlesinger | Digikey
Brandon Hogue | eBay
Christian Coffield | Mouser
Derrian Glynn | MicrochipDirect
 | HobbyKing
 | SparkFun
 | BatteryJunction
 | Pololu
 | Adafruit
