team2seniordesignwiki/OmegaBlade/4013 Senior Design/Managerial Docs/Budget and Costing/Parts Lists/parts_request_ben_jespersen.xlsx

Description | Quantity | Unit Price | Total Price (without tax/shipping) | Link | Additional notes
28-pin IC socket | 8 | 0.315 | 2.52 | http://www.digikey.com/product-detail/en/ED281DT/ED3050-5-ND/4147600 | Ordering twice as many of each part as necessary for final project.
1 k-ohm resistor | 8 | 0.1 | 0.8 | http://www.digikey.com/product-detail/en/RC1206FR-071KL/311-1.00KFRCT-ND/731334 | This is to allow separate parts for prototyping and integration
Momentary pushbutton | 8 | 0.48 | 3.84 | http://www.digikey.com/product-detail/en/KMR231NG%20LFS/CKN10246CT-ND/2176497 | phases, as well as a couple extras of each part in case of damage or
Diode | 8 | 0.1 | 0.8 | http://www.digikey.com/product-detail/en/1N4148/1N4148FS-ND/458603 | loss.
Male header pins | 1 | 0.75 | 0.75 | https://www.pololu.com/product/965
 |  | Total Cost: | 8.71
