team2seniordesignwiki/OmegaBlade/4013 Senior Design/Prototyping/Blake/Blade 3D Modeling/bladeEndCapSimple2rev.SLDPRT

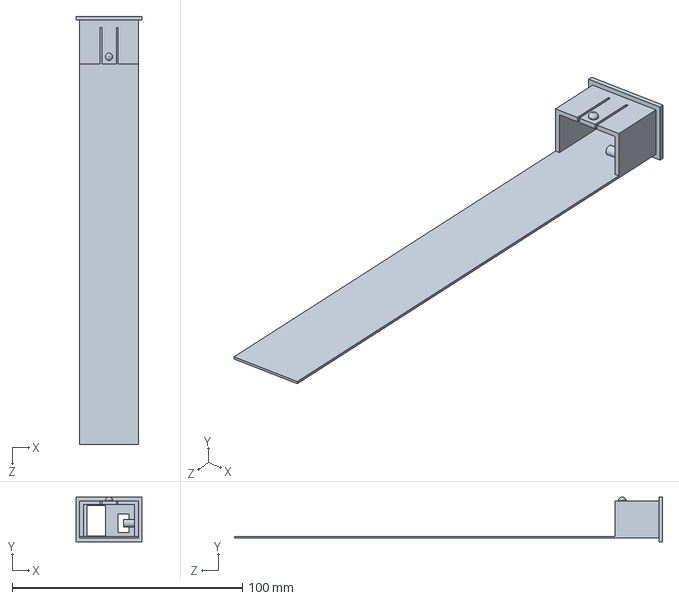
[picture p116: CAD file, 2015-10-25]
4013 Senior Design/Prototyping/Blake/Blade 3D Modeling/bladeEndCapSimple2rev.SLDPRT
28.6 x 19.4 x 185.7 mm
