team2seniordesignwiki/OmegaBlade/4013 Senior Design/Prototyping/Blake/Blade 3D Modeling/bladeEndCapSimple.SLDPRT

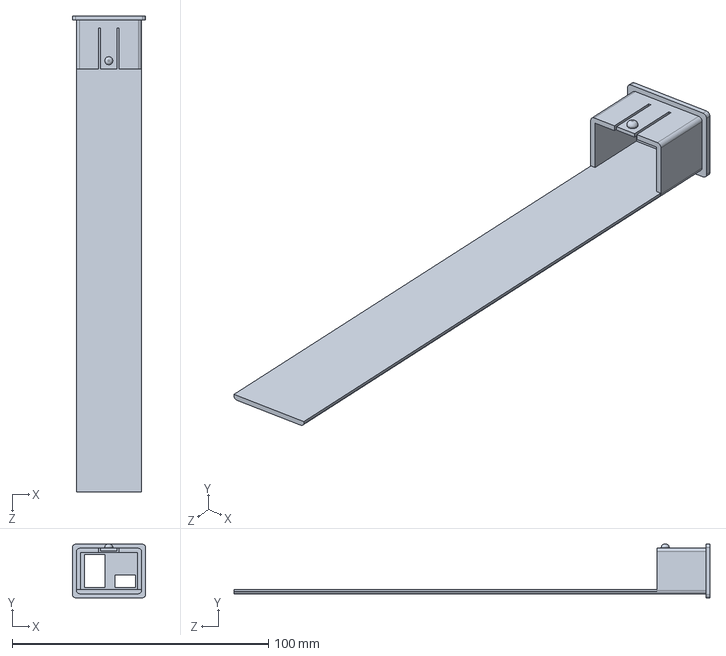
[picture p117: CAD file, 2015-10-25]
4013 Senior Design/Prototyping/Blake/Blade 3D Modeling/bladeEndCapSimple.SLDPRT
28.6 x 21.0 x 185.7 mm
