team2seniordesignwiki/OmegaBlade/4013 Senior Design/Prototyping/Blake/Blade 3D Modeling/bladeEndCap_save5.SLDPRT

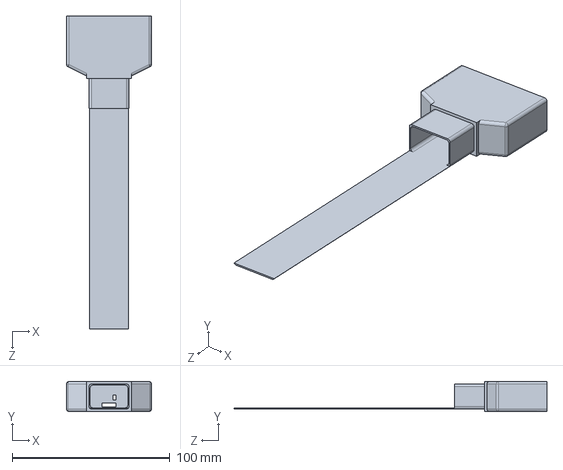
[picture p118: CAD file, 2015-10-25]
4013 Senior Design/Prototyping/Blake/Blade 3D Modeling/bladeEndCap_save5.SLDPRT
54.0 x 19.1 x 198.4 mm
