team2seniordesignwiki/OmegaBlade/(list of files, cad)

Other CAD files:
4013 Senior Design/Homework/MAGE Troubleshooting Board/Board2.X/Board2.X/dist/default/production/Board6.X.production.obj
4013 Senior Design/Homework/MAGE Troubleshooting Board/Board2.X/Board2.X/l.obj
4013 Senior Design/Prototyping/Brandon/IR/Transmit/Code/IR3.X/dist/default/production/IR3.X.production.obj
4013 Senior Design/Prototyping/Blake/Blade 3D Modeling/bladeEndCapSimple.STL
4013 Senior Design/Prototyping/Blake/Blade 3D Modeling/bladeEndCapSimple2rev.STL
4013 Senior Design/Prototyping/Blake/Blade 3D Modeling/bladeEndCap_save5.STL
