team2seniordesignwiki/OmegaBlade/4013 Senior Design/Tutorials/Milling/IsoPro Instructions.rtf

IsoPro Quick Reference

1. After obtaining the board, drill two holes (using an 1/8” or 9/64” drill bit) on opposite ends of the board for mounting. Make sure the holes line up properly on the mill.

TIP: Use a board that already has mounting holes as a stencil. Tape the “stencil board” on top of your board and drill.

2. Turn on the mill. You should always do this before starting the software. (Additionally, if the mill freezes, you may need to power cycle the mill and restart IsoPro)

3. Open the IsoPro software by either double clicking on the desktop icon, or by going to start > Programs > IsoPro > IsoPro 3.1

4. Go to mill > material change. This will cause the drill to move out of your way. Pin the board to the backing plate on the mill. Click OK to return the drill to its proper location.

5. Click on Mill and select initialize. This will cause the drill to zero itself.

6. Go to file, then down to import. Choose Autodetect and open the Drill file first (it should have a .d** extension). If prompted, select the appropriate size board.

7. Repeat step four for the net/Gerber files.

8. Make sure that the holes line up with the pads. If they do not, go to Tools > Register Layers. Click on a pad and find the corresponding hole and select it. The layers should now be aligned.

9. Verify the aperture settings. Either click on the Apertures icon, or hit F3. From here, you can control the trace widths and pad sizes. If your Gerber files are not in the RS274X standard, you will have to manually adjust these sizes.

TIP: The RS274X file specifies the dimensions of the board. The RS274D does not specify the board dimensions.

10. By selecting the Tools Icon, or hitting F4, you can control the holes sizes by selecting the size of the drill bits. Remember, the minimum trace spacing you will want to use is 20 mils. This means that there needs to be a minimum clearance of 20 mils between traces for the isolation.

11. Go to tools > Isolate, then select the layer that you wish to isolate. Set the tool size for the isolation (0.031, 0.020, etc.). Visually inspect the isolation to make sure that the pads and traces do not overlap.

12. If using a small end mill to clean up traces (i.e. 0.020”) remove redundant data by selecting these areas and deleting them. This will save you milling time and reduces the wearing of the bit.

13. Now save the file. It should save as *.ISO. You can now open this file later if you need to re-drill the board.

14. Go to Layer Table and mirror the diagrams.

15. To check if the board is in position and milling does not run off the board, a dummy round of selected milling is recommended. To run a dummy round, adjust the foot of the mill so it sits below the level of the bit. (“+ ←” moves the foot up and “- → “ moves the foot down.) You turn the knob “- →.” Select the extreme areas that you must mill on each side of the board and mill. If the bit looks like it will mill off the board, stop milling. Adjust the offsets of the board and try again until all your milling looks like it will fit on the board.

WARNING: ***If you are going to be milling close to the alignment pins, confirm that these pins are flush with the copper board! Failure to do so can lead to the mill becoming damaged and unusable. ***

16. Move the mill to an area that is empty and hit the “Get Material Height” button.

17. When you are ready to drill, select the layer that you wish to drill. Go to mill > run layer. You will be prompted to insert the drill bit. By default 24 inches per minute is selected for the maximum speed for drilling. For the smaller bits, a maximum speed of 9 inches per minute is recommended. Bits tend to break at higher speeds.

18. Once the bit has been changed, the mill will proceed with drilling.

Below is a Table with typical bits sizes and the corresponding uses.

Bit Size | Uses
40 mils | Resistors, DIP headers, capacitors
32 mils | ICs
60 mils | potentiometers
62 mils | cutting the board’s outline
1/8 inch | creating the holes to pin the board
