team2seniordesignwiki/OmegaBlade/4013 Senior Design/Tutorials/Milling/Mill Home Settings.rtf

T-Tech Mill Home Positions

Right Mill room 401
Serial #: 50244
X Home: 5698
Y Home: 27002

Left Mill room 401
Serial #: 50056
X Home: 5484
Y Home: 26856
