team2seniordesignwiki/OmegaBlade/4013 Senior Design/Research/Blake/Resources and Other/dc-dc converter tutorial (Maxim).txt

https://www.maximintegrated.com/en/app-notes/index.mvp/id/2031
