team2seniordesignwiki/OmegaBlade/4013 Senior Design/galleryImages/makingLedStrips.jpg

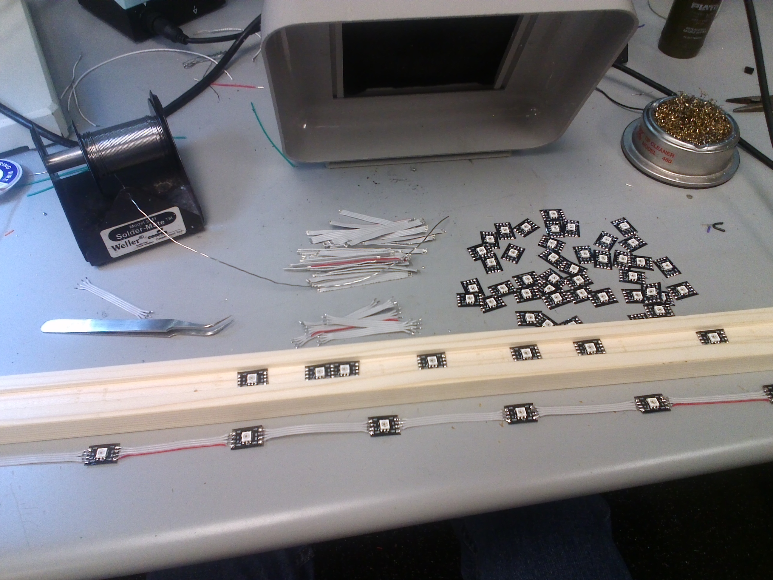
4013 Senior Design/galleryImages/makingLedStrips.jpg
