team2seniordesignwiki/OmegaBlade/4013 Senior Design/galleryImages/thumbnails/powerPrototypeBoardTest_thumbnail.jpg

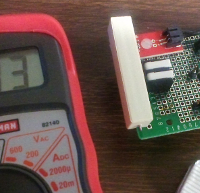
4013 Senior Design/galleryImages/thumbnails/powerPrototypeBoardTest_thumbnail.jpg
