team2seniordesignwiki/OmegaBlade/4013 Senior Design/Homework/MAGE Troubleshooting Board/Board2.X/Headband.pdf

U7

U6

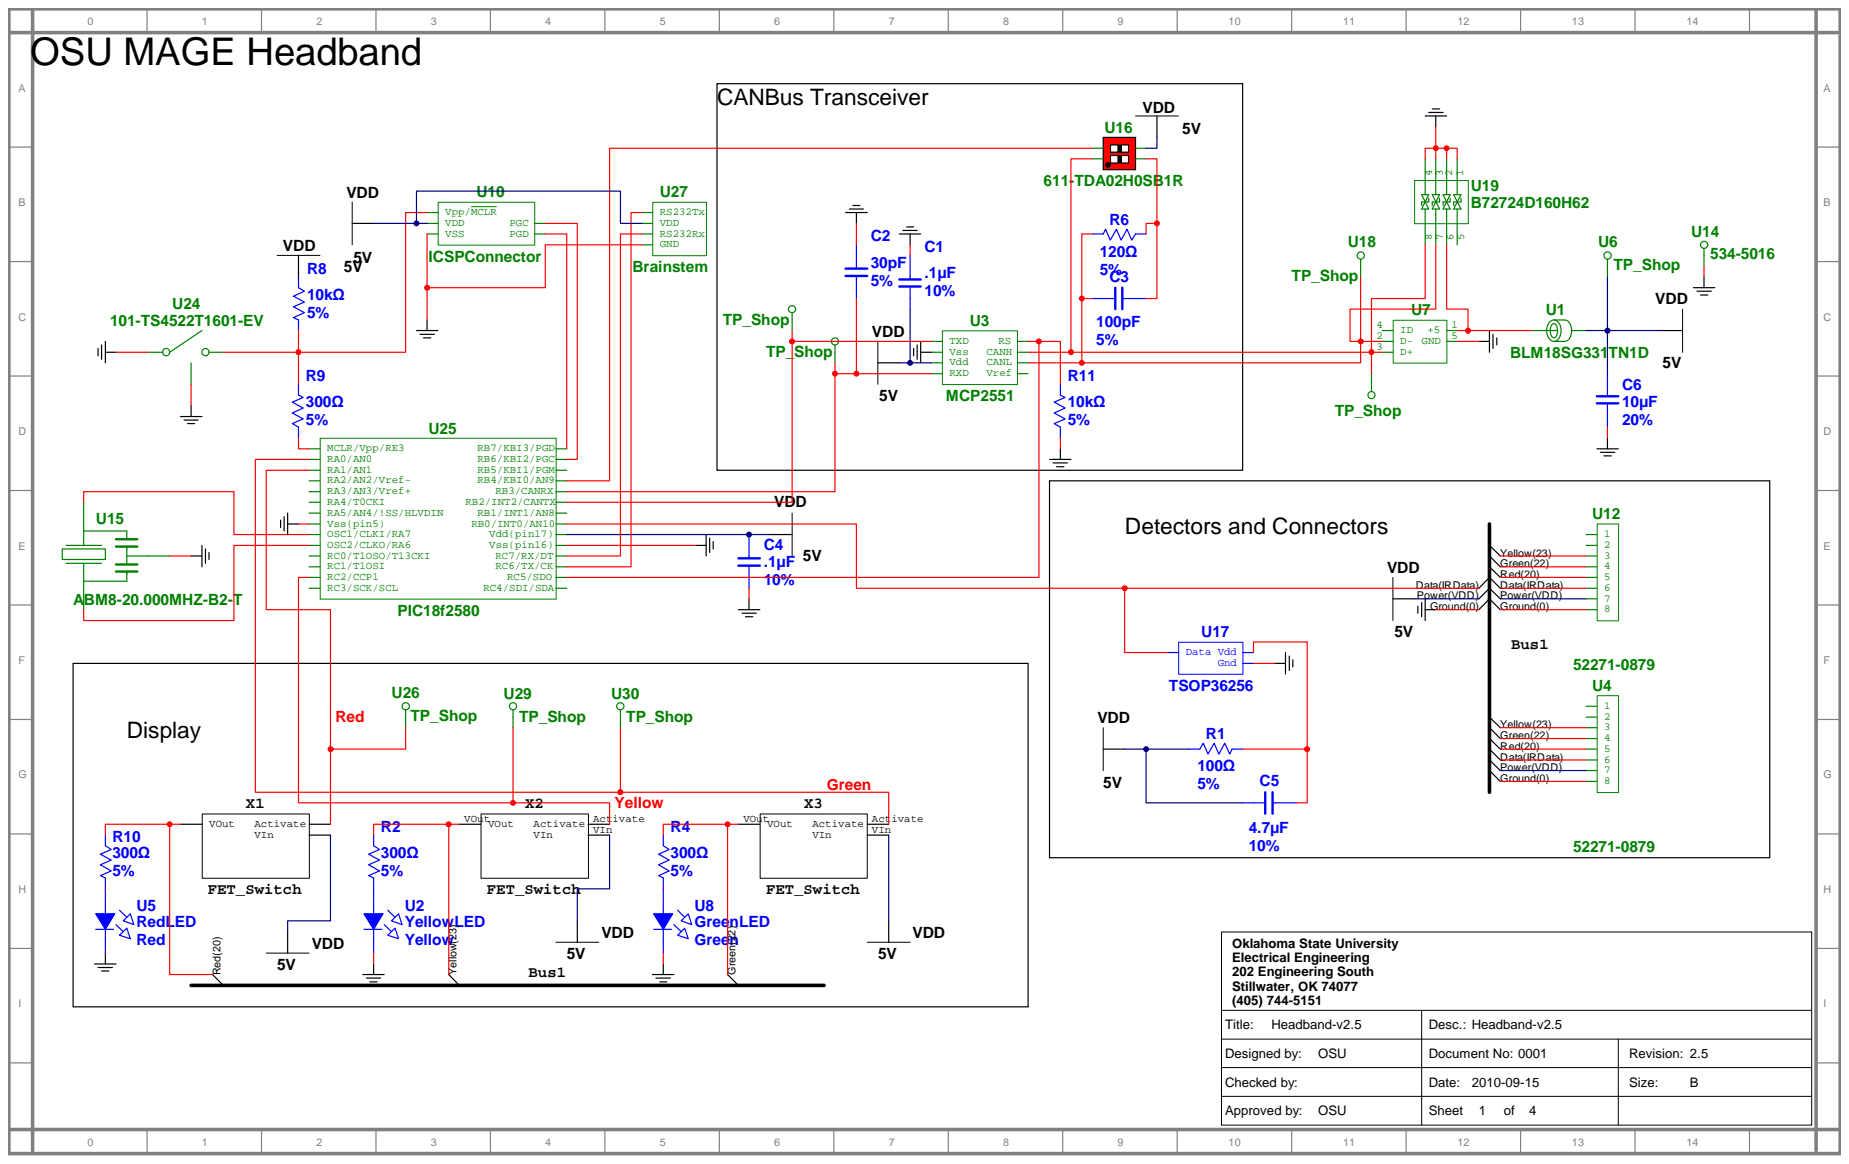
[picture p122: page 1]

Activate Activate VOut VOut

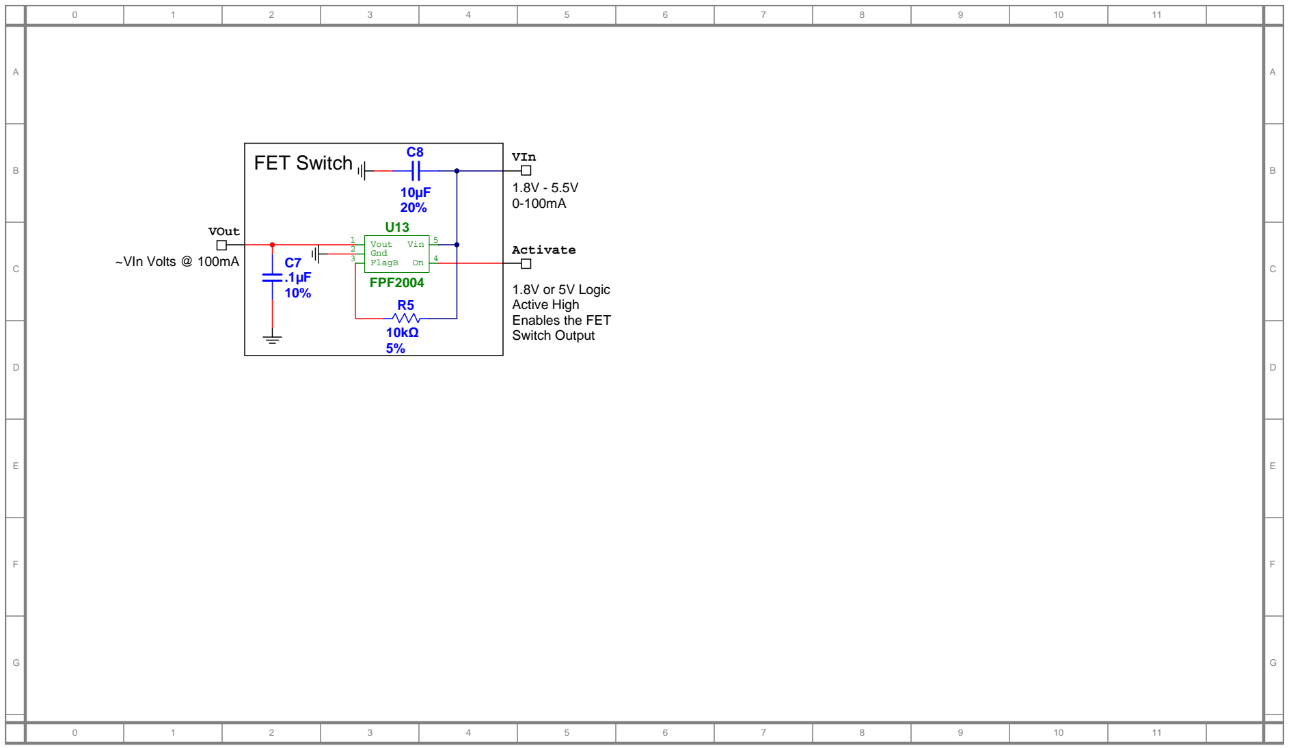
[picture p123: figure]
Activate; VOut; FPF2004; Vout 1 Gnd 2; FlagB 3; Vin 5; VIn FET Switch; 1.8V or 5V Logic Active High Enables the FET Switch Output; ~VIn Volts @ 100mA
