team2seniordesignwiki/OmegaBlade/4013 Senior Design/Managerial Docs/Project Planning/Functional Block Diagram - Brandon Hogue.pdf

# Functional Block Diagram

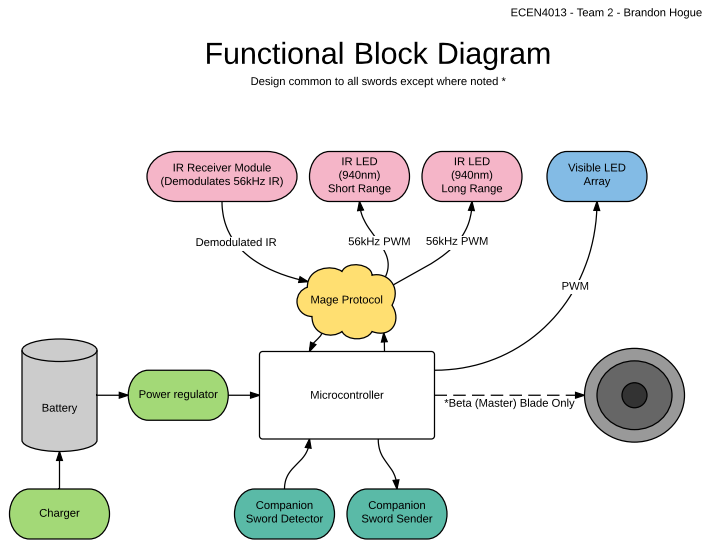
[picture p124: page 1]
Microcontroller; Demodulated IR; 56kHz PWM; IR LED (940nm) Short Range; IR LED (940nm) Long Range; Mage Protocol; Companion Sword Detector; Companion Sword Sender; Battery; Charger; Visible LED Array; PWM; Power regulator

ECEN4013 - Team 2 - Brandon Hogue

Design common to all swords except where noted *

IR Receiver Module
(Demodulates 56kHz IR)

*Beta (Master) Blade Only
