team2seniordesignwiki/OmegaBlade/4013 Senior Design/Prototyping/Christian/ISR/ISR Schematic.pdf

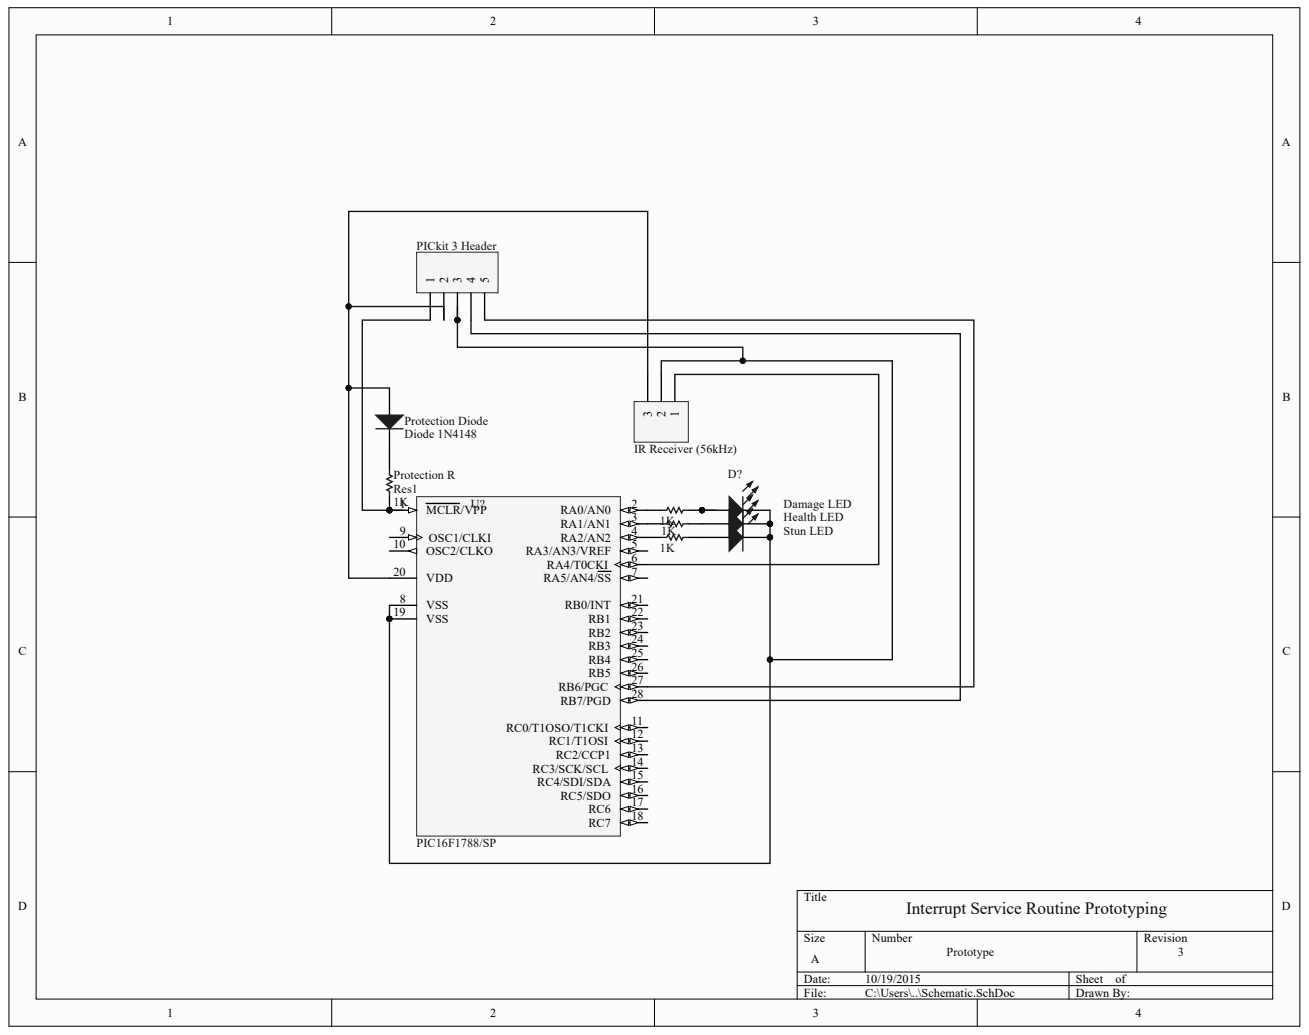
[picture p125: page 1]

Interrupt Service Routine Prototyping
