team2seniordesignwiki/OmegaBlade/4013 Senior Design/Prototyping/Christian/PCB/Large Schematic.pdf

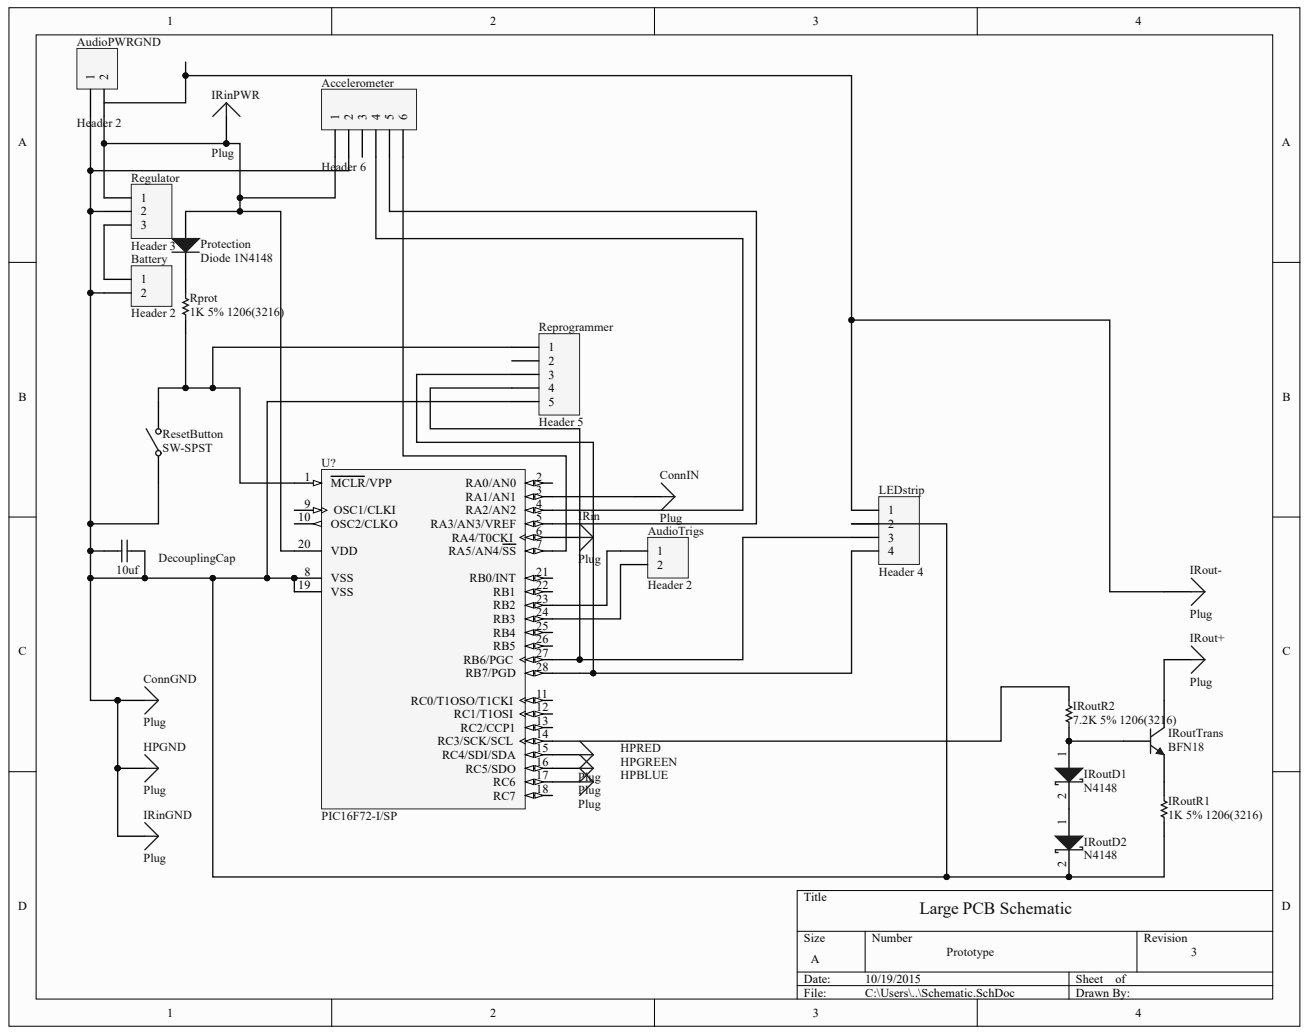
[picture p126: page 1]

ge PCB Schematic Prototype
Lar
