team2seniordesignwiki/OmegaBlade/4013 Senior Design/Prototyping/Christian/PCB/Small Schematic.pdf

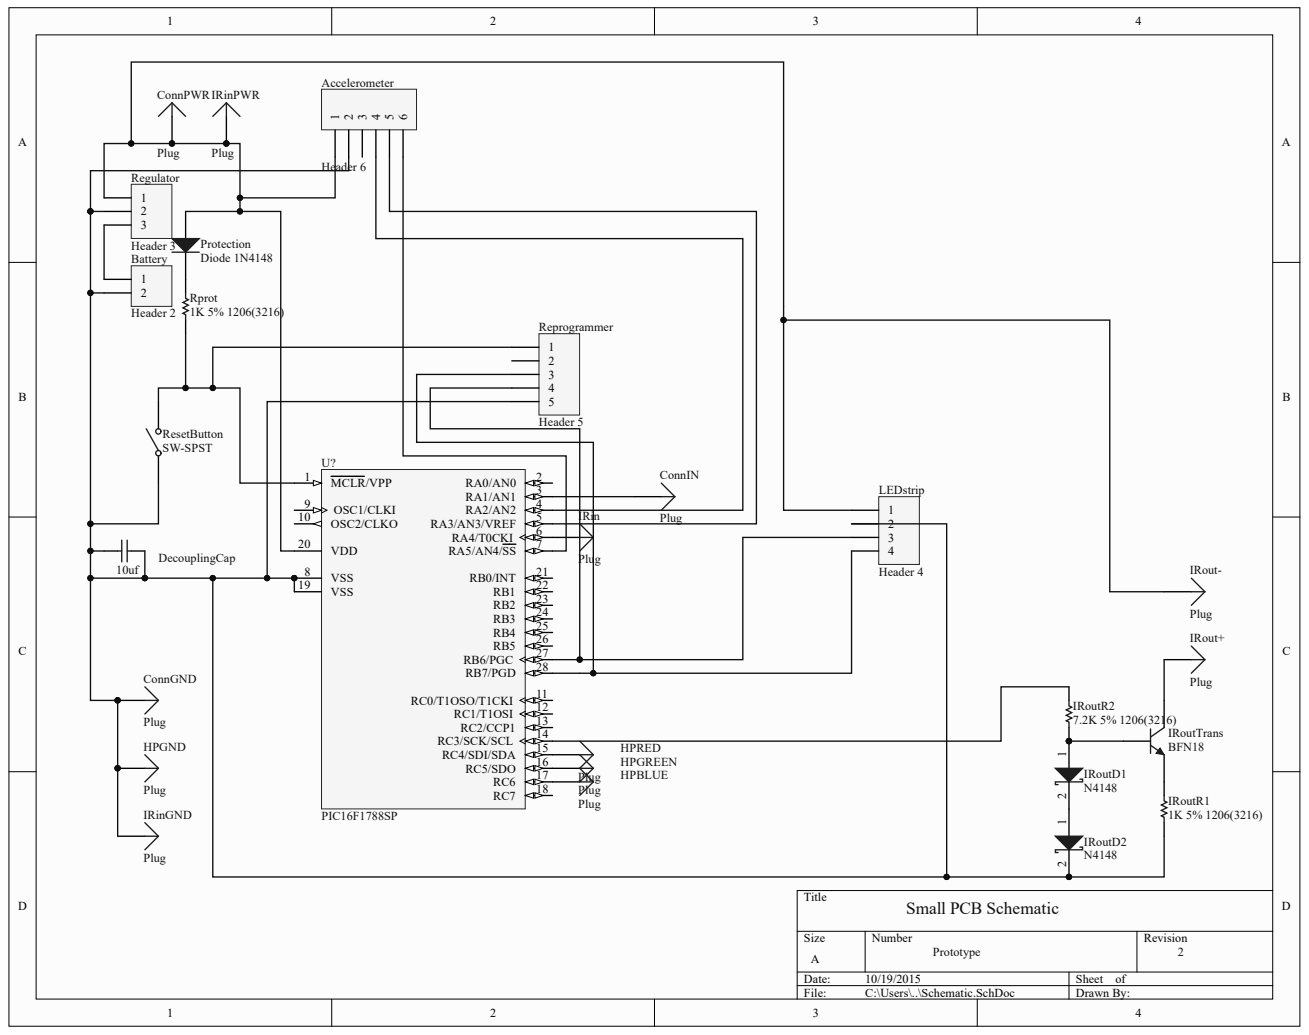
[picture p127: page 1]

Protection Diode 1N4148 Rprot

Small PCB Schematic Prototype
