team2seniordesignwiki/OmegaBlade/4013 Senior Design/Research/Brandon Hogue/Transmit software flowchart.pdf

# IR Transmission Software Flow Chart

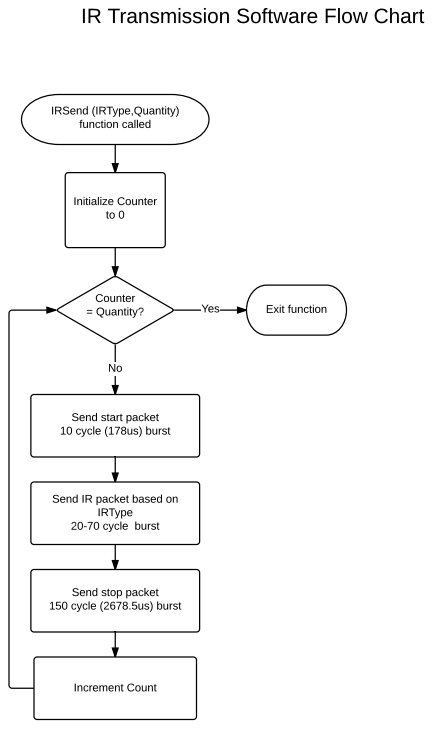
[picture p128: page 1]
Counter = Quantity?; Initialize Counter to 0; Yes; Exit function; IRType 20-70 cycle burst; Increment Count

IRSend (IRType,Quantity)
function called

Send start packet
10 cycle (178us) burst

Send IR packet based on

Send stop packet
150 cycle (2678.5us) burst
