team2seniordesignwiki/OmegaBlade/4013 Senior Design/Research/Brandon Hogue/IR/Transmit/NPN-CC-Driver-Current.pdf

## Design1 Transient

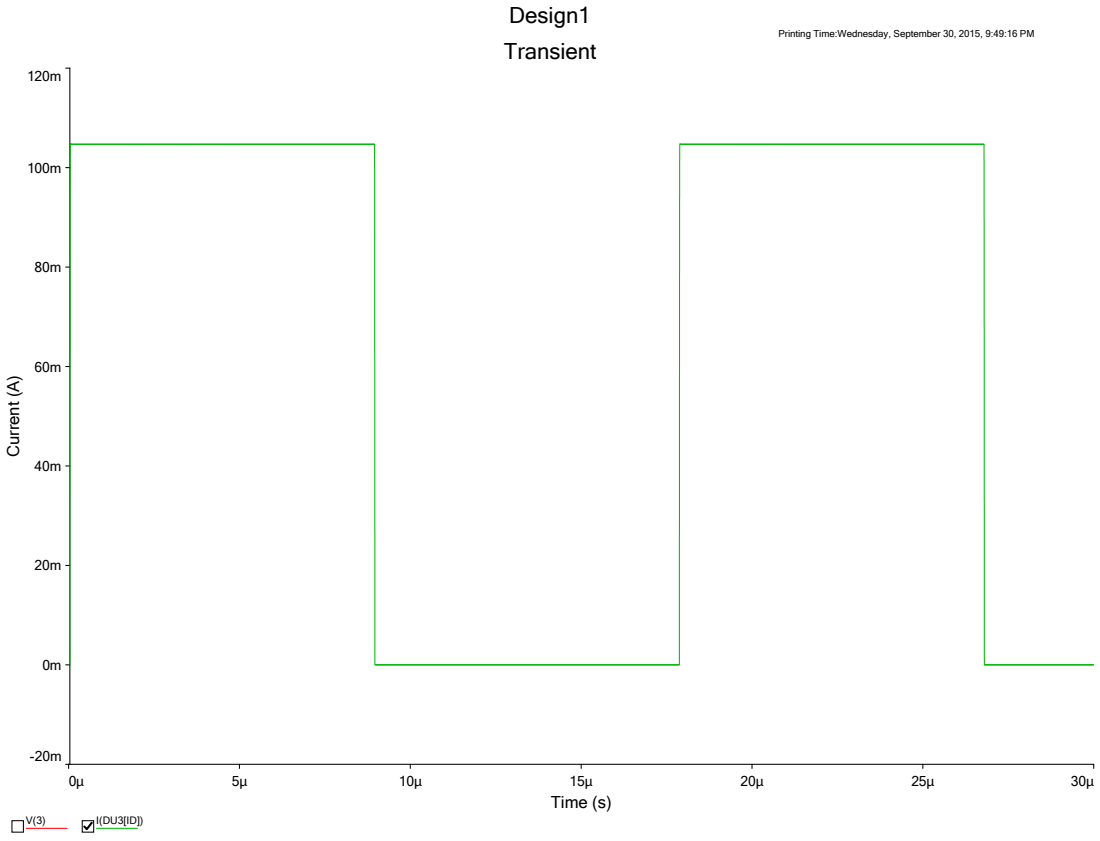
[picture p129: page 1]
Time (s); 30µ Current (A⁾

Printing Time:Wednesday, September 30, 2015, 9:49:16 PM
