team2seniordesignwiki/OmegaBlade/4013 Senior Design/Research/Brandon Hogue/IR/Transmit/NPN-CC-Driver-Voltage.pdf

## Design1 Transient

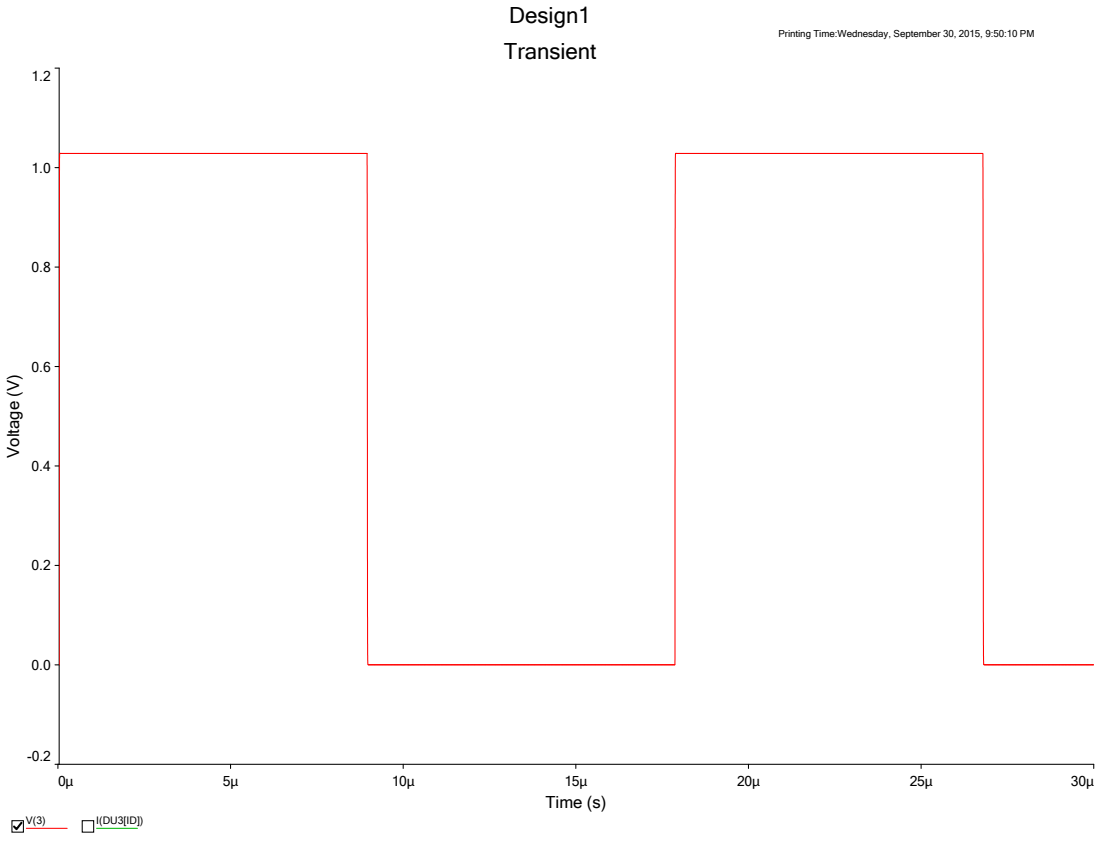
[picture p130: page 1]
Time (s); 30µ Voltage ⁽V⁾

Printing Time:Wednesday, September 30, 2015, 9:50:10 PM
