team2seniordesignwiki/OmegaBlade/4013 Senior Design/Integration/Integration I PCB/PCB13d.pdf

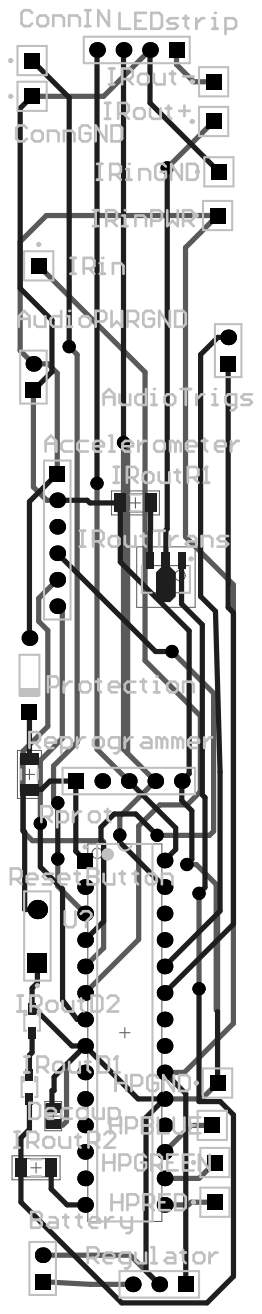
[picture p131: page 1]
