team2seniordesignwiki/OmegaBlade/4013 Senior Design/Managerial Docs/Team Block Diagram/Alpha Delta Gamma Flowcharts.pdf

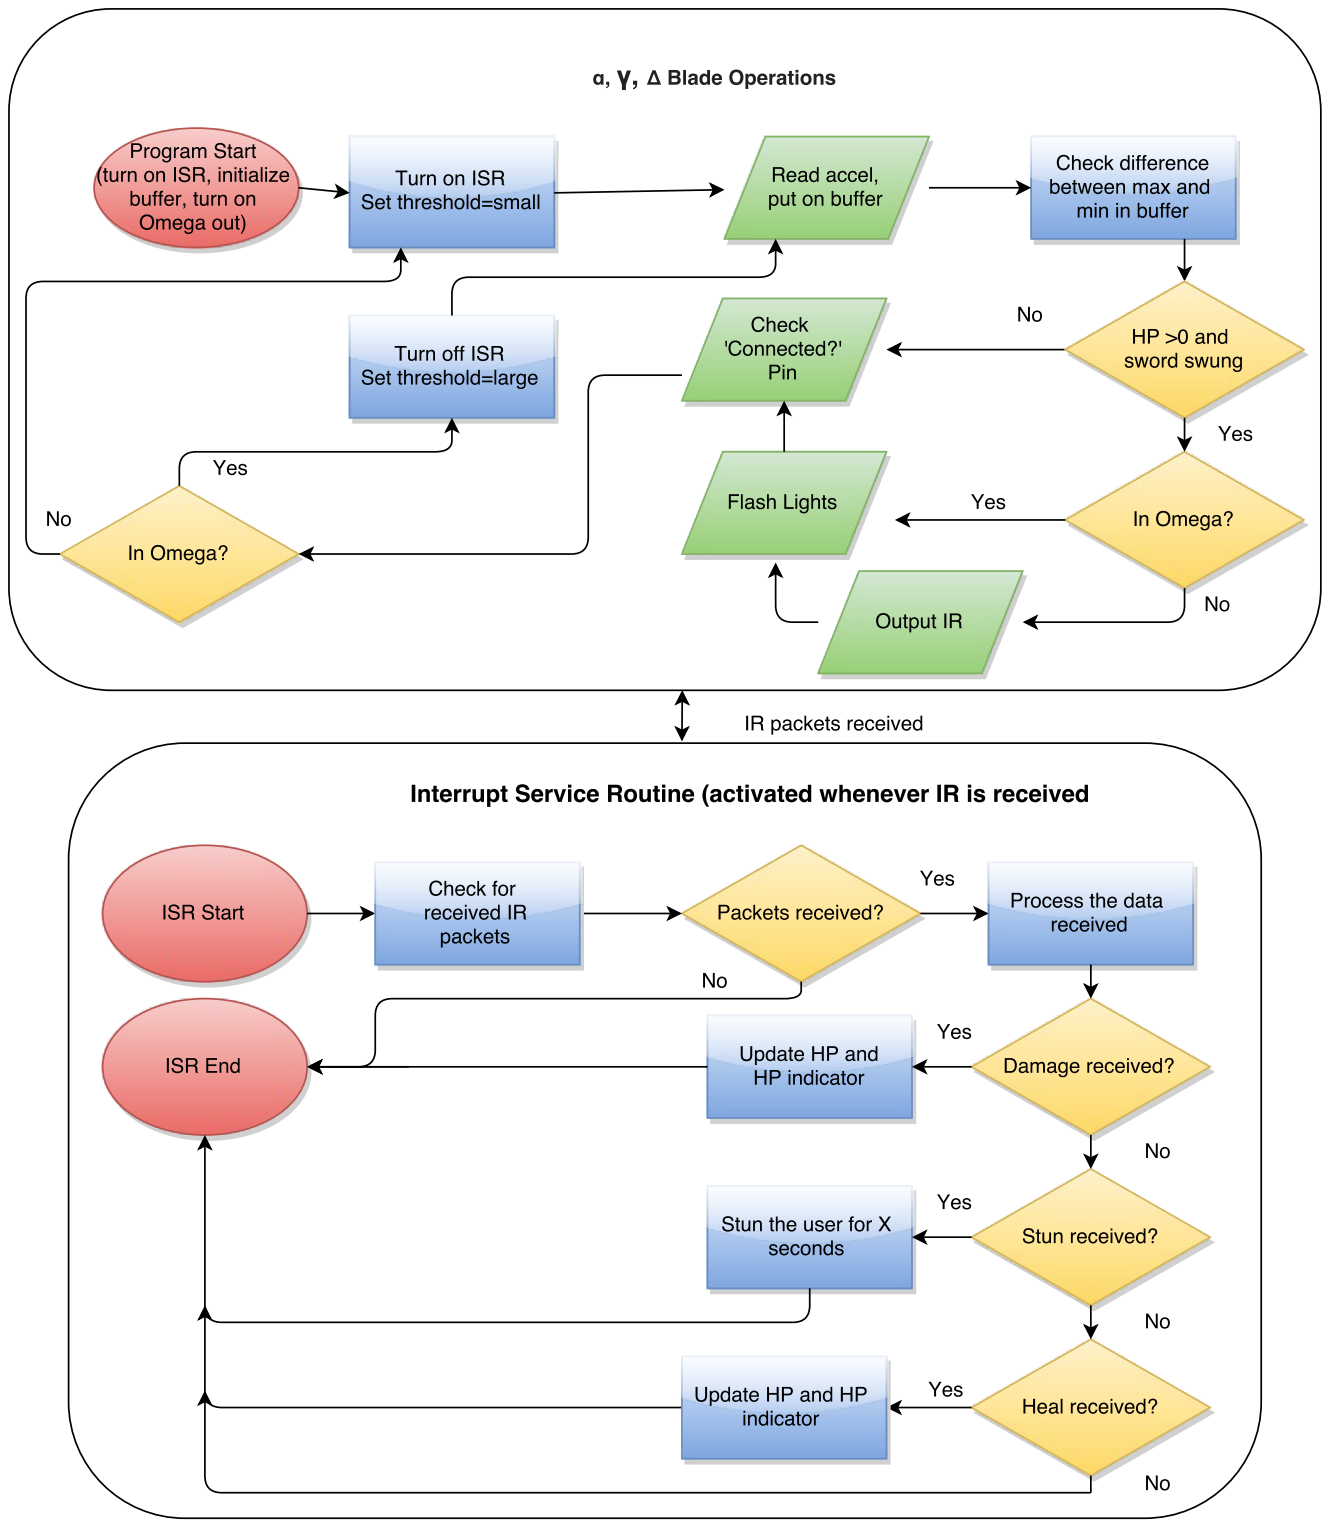
[picture p132: page 1]
