team2seniordesignwiki/OmegaBlade/4013 Senior Design/Managerial Docs/Team Block Diagram/Beta Flowchart.pdf

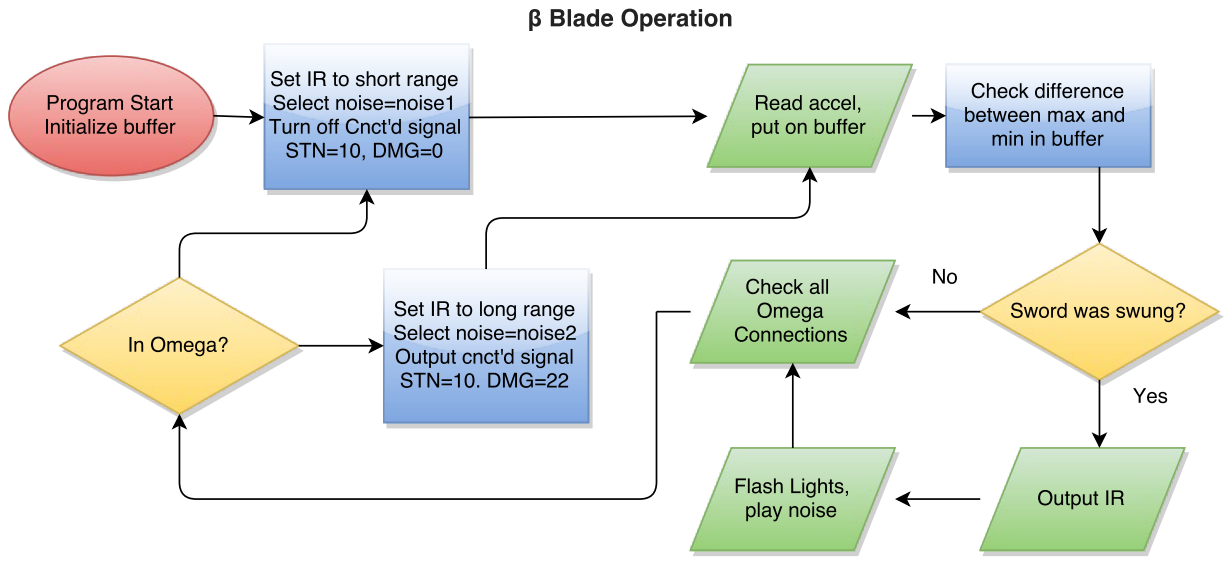
[picture p133: page 1]
