team2seniordesignwiki/OmegaBlade/4013 Senior Design/Prototyping/Ben/main_program_flowchart_alpha_gamma_1.3.pdf

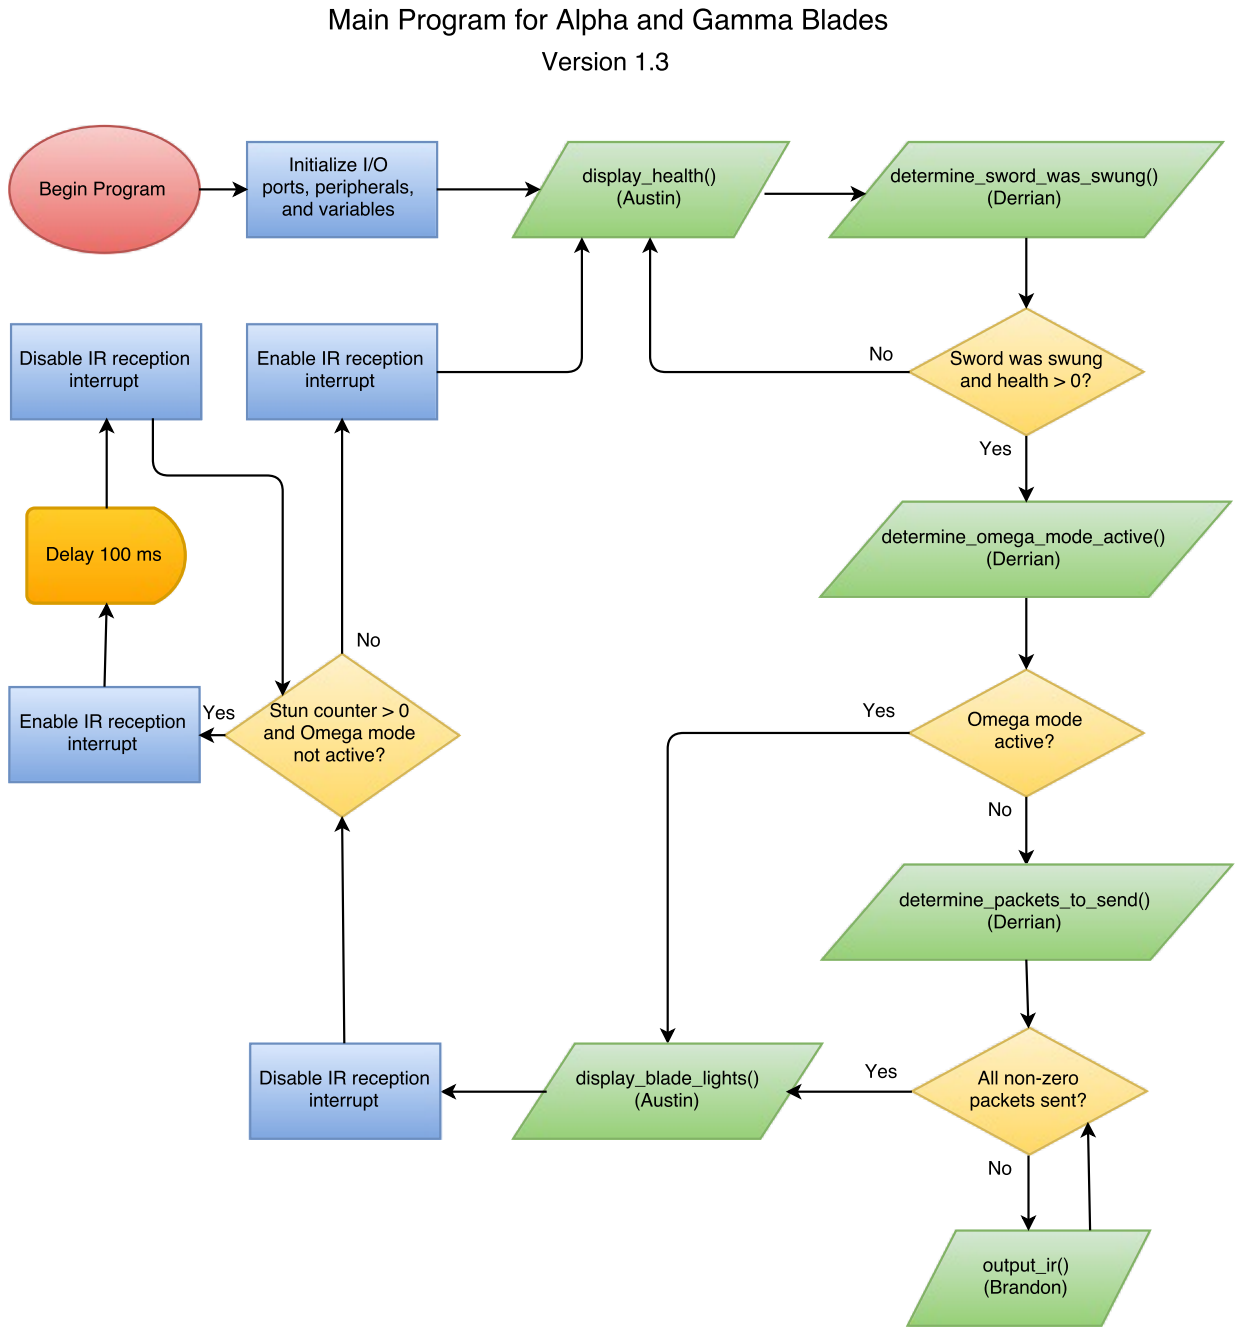
[picture p134: page 1]
