team2seniordesignwiki/OmegaBlade/4013 Senior Design/Prototyping/Ben/main_program_flowchart_beta_1.3.pdf

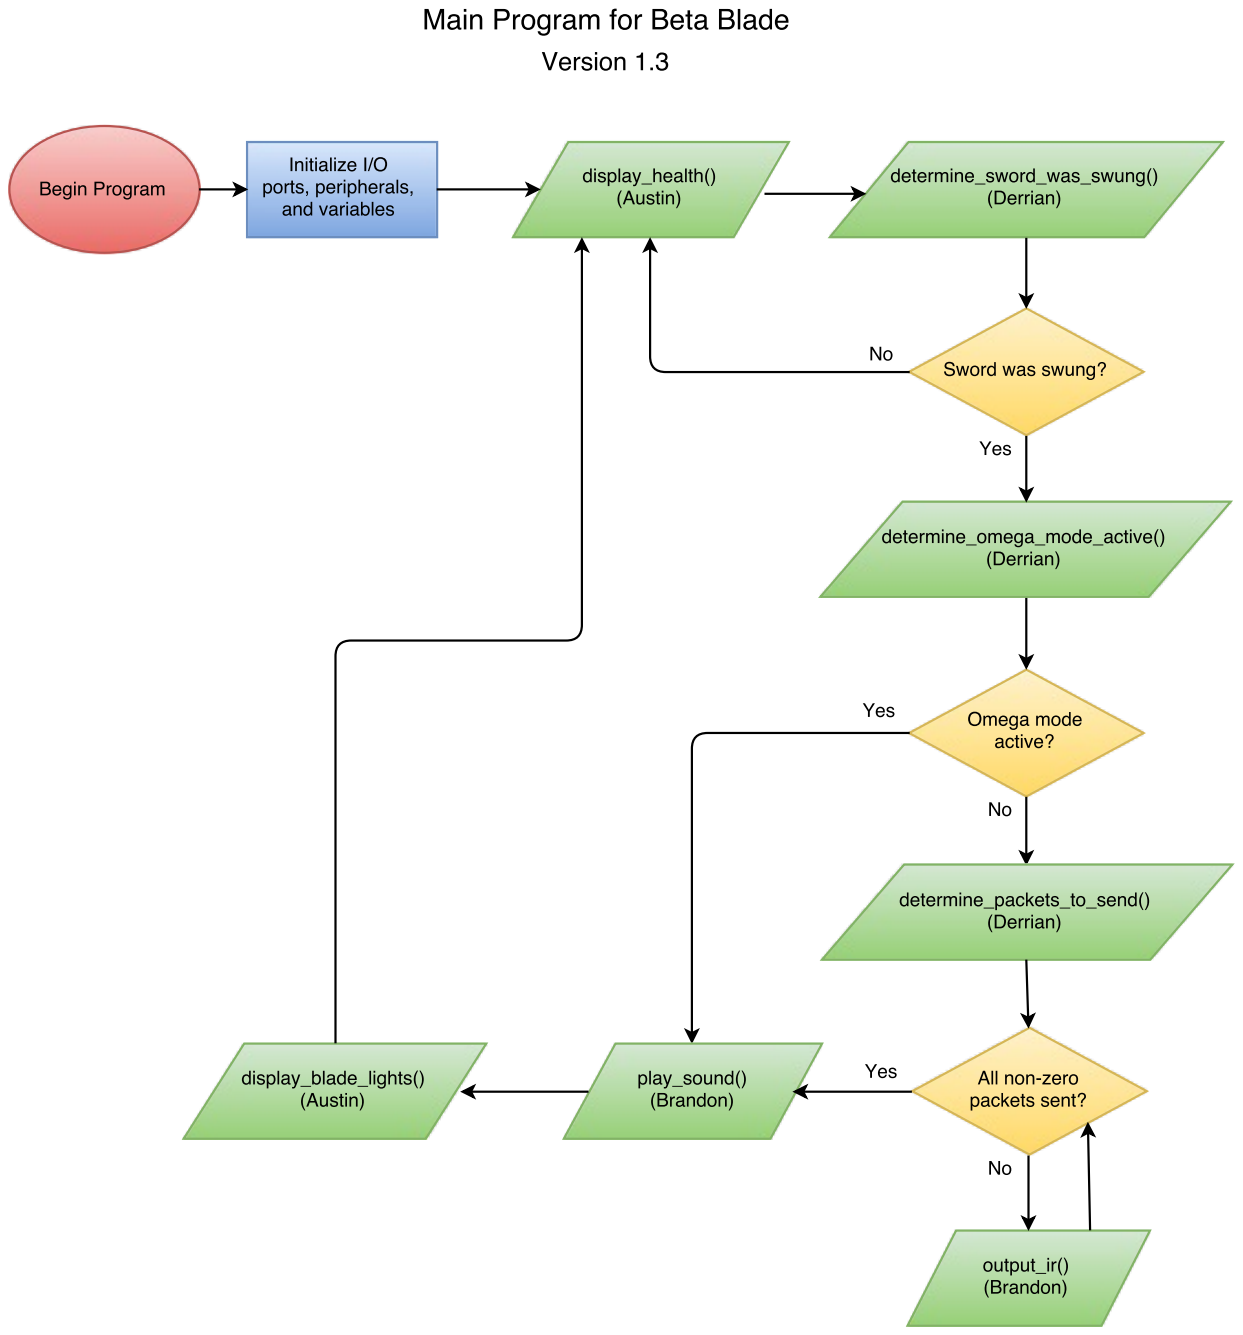
[picture p135: page 1]
