team2seniordesignwiki/OmegaBlade/4013 Senior Design/Prototyping/Christian/PCB/Small PCB.pdf

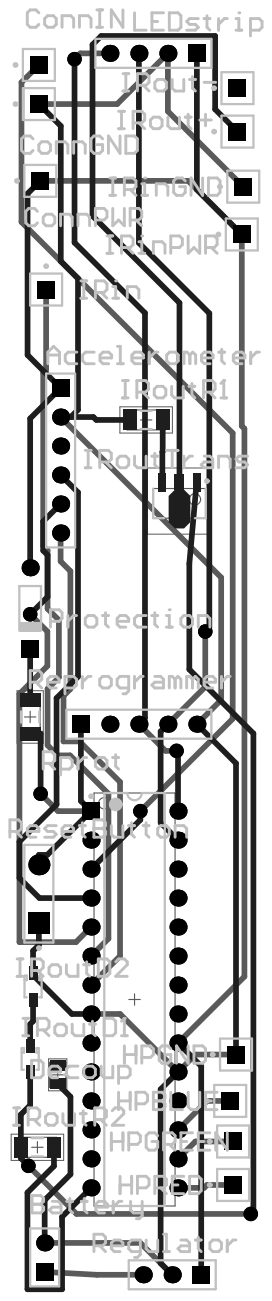
[picture p138: page 1]
