team2seniordesignwiki/OmegaBlade/4013 Senior Design/Prototyping/Brandon/IR/Transmit/IR Transmit Prototype board.pdf

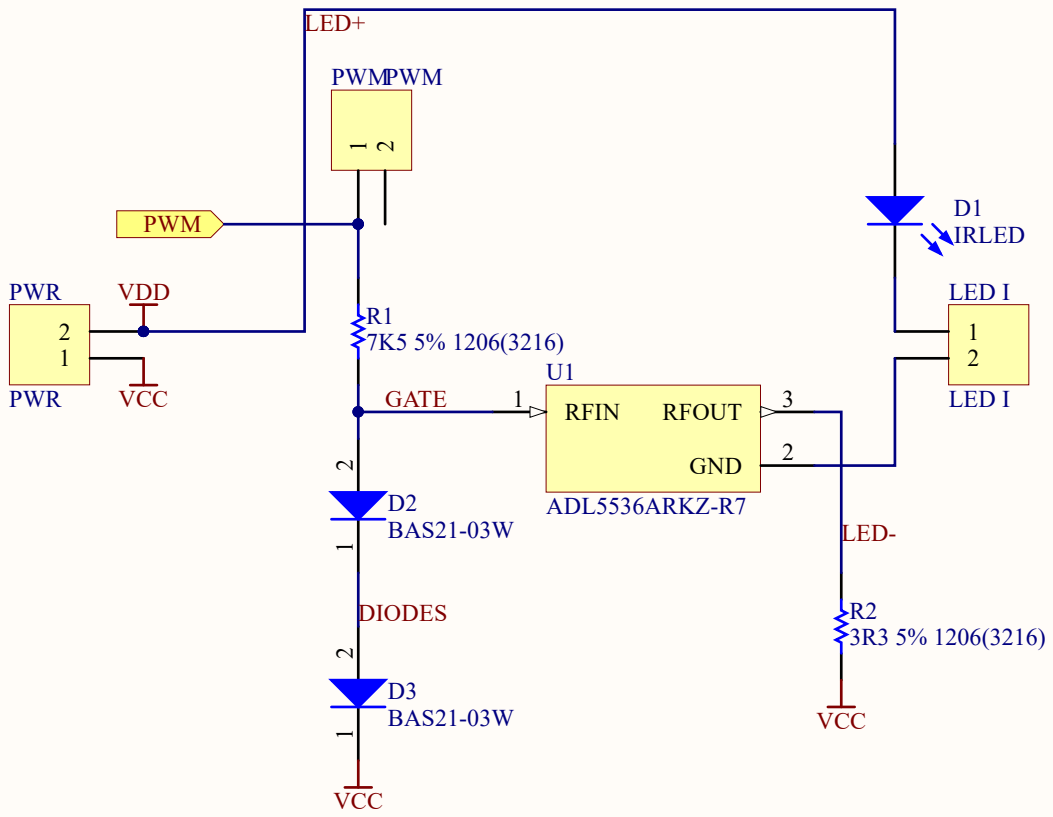
[picture p139: page 1]

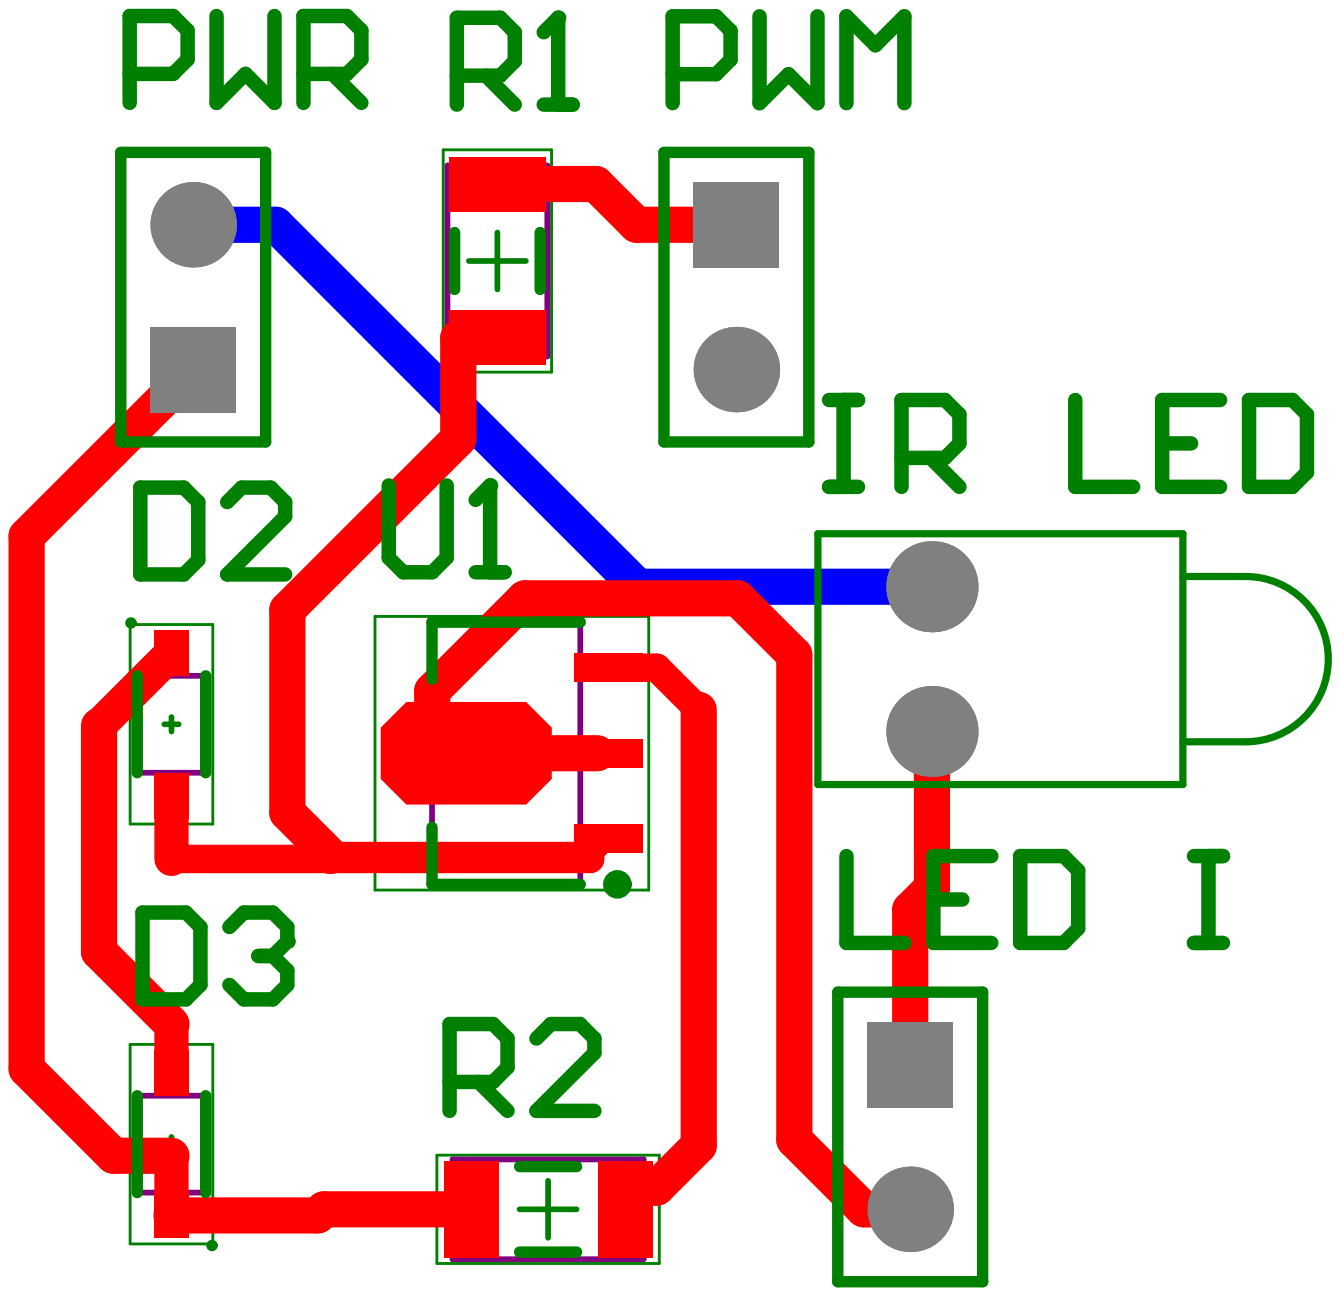
[picture p140: page 2]
