team2seniordesignwiki/OmegaBlade/4013 Senior Design/Prototyping/Brandon/IR/Receive/IR Recieve Breakout/PCB.pdf

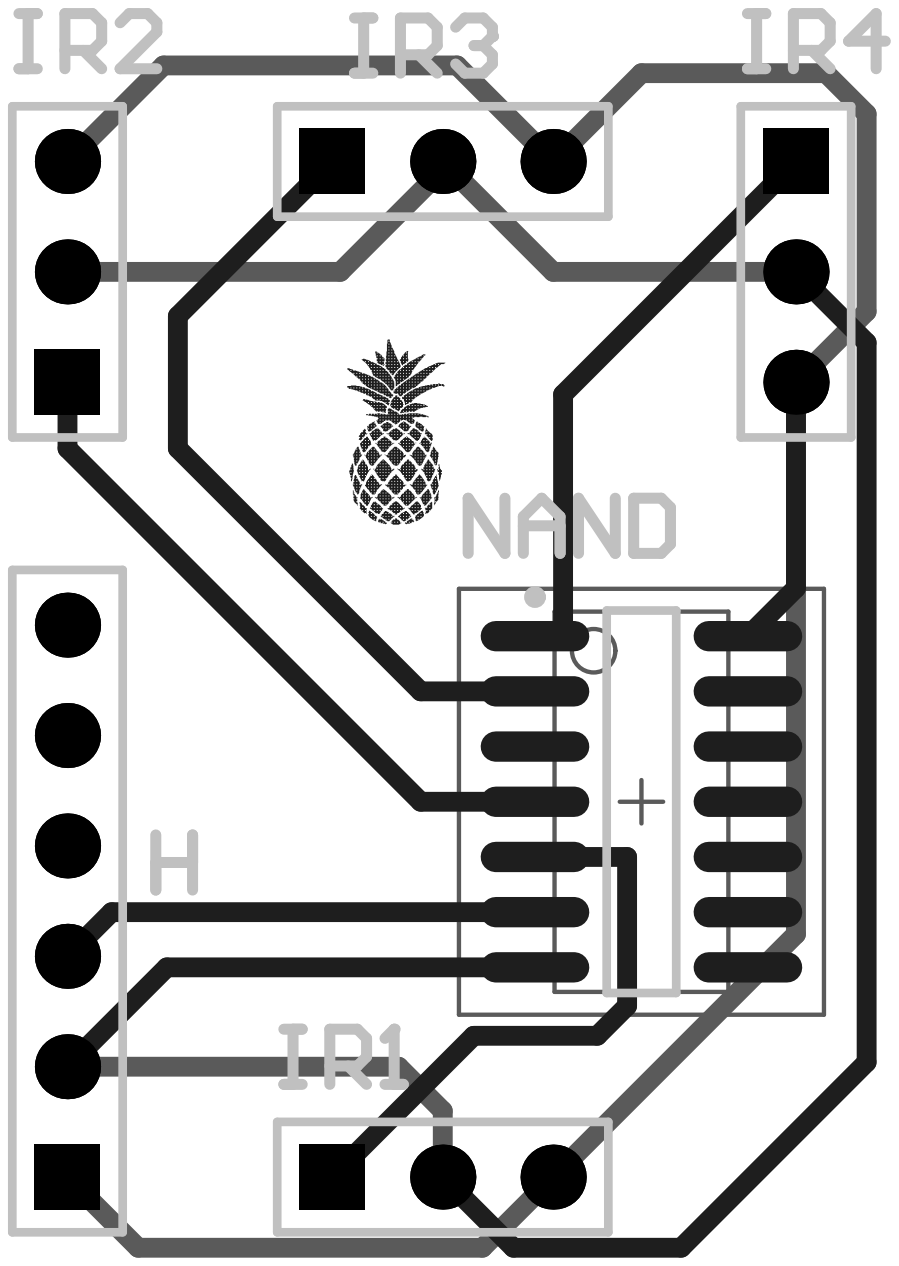
[picture p141: page 1]
