team2seniordesignwiki/OmegaBlade/4013 Senior Design/Prototyping/Brandon/IR/Receive/IR Recieve Breakout/Schematic.pdf

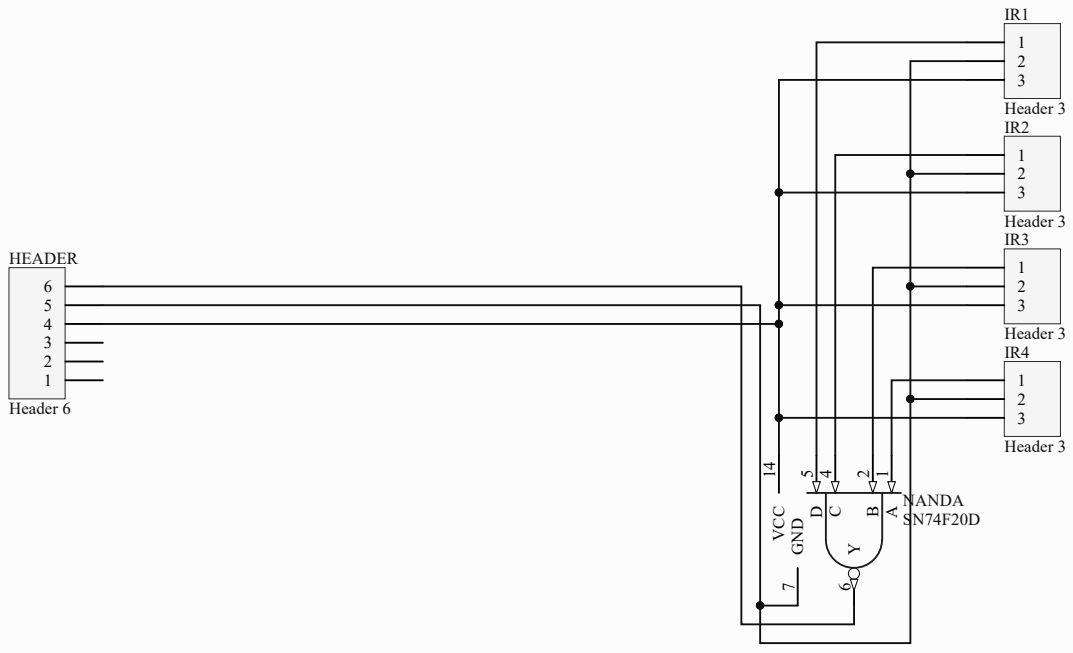
[picture p142: page 1]
