team2seniordesignwiki/OmegaBlade/4013 Senior Design/Research/Ben/PIC/main_program_flowchart_beta_1.2.pdf

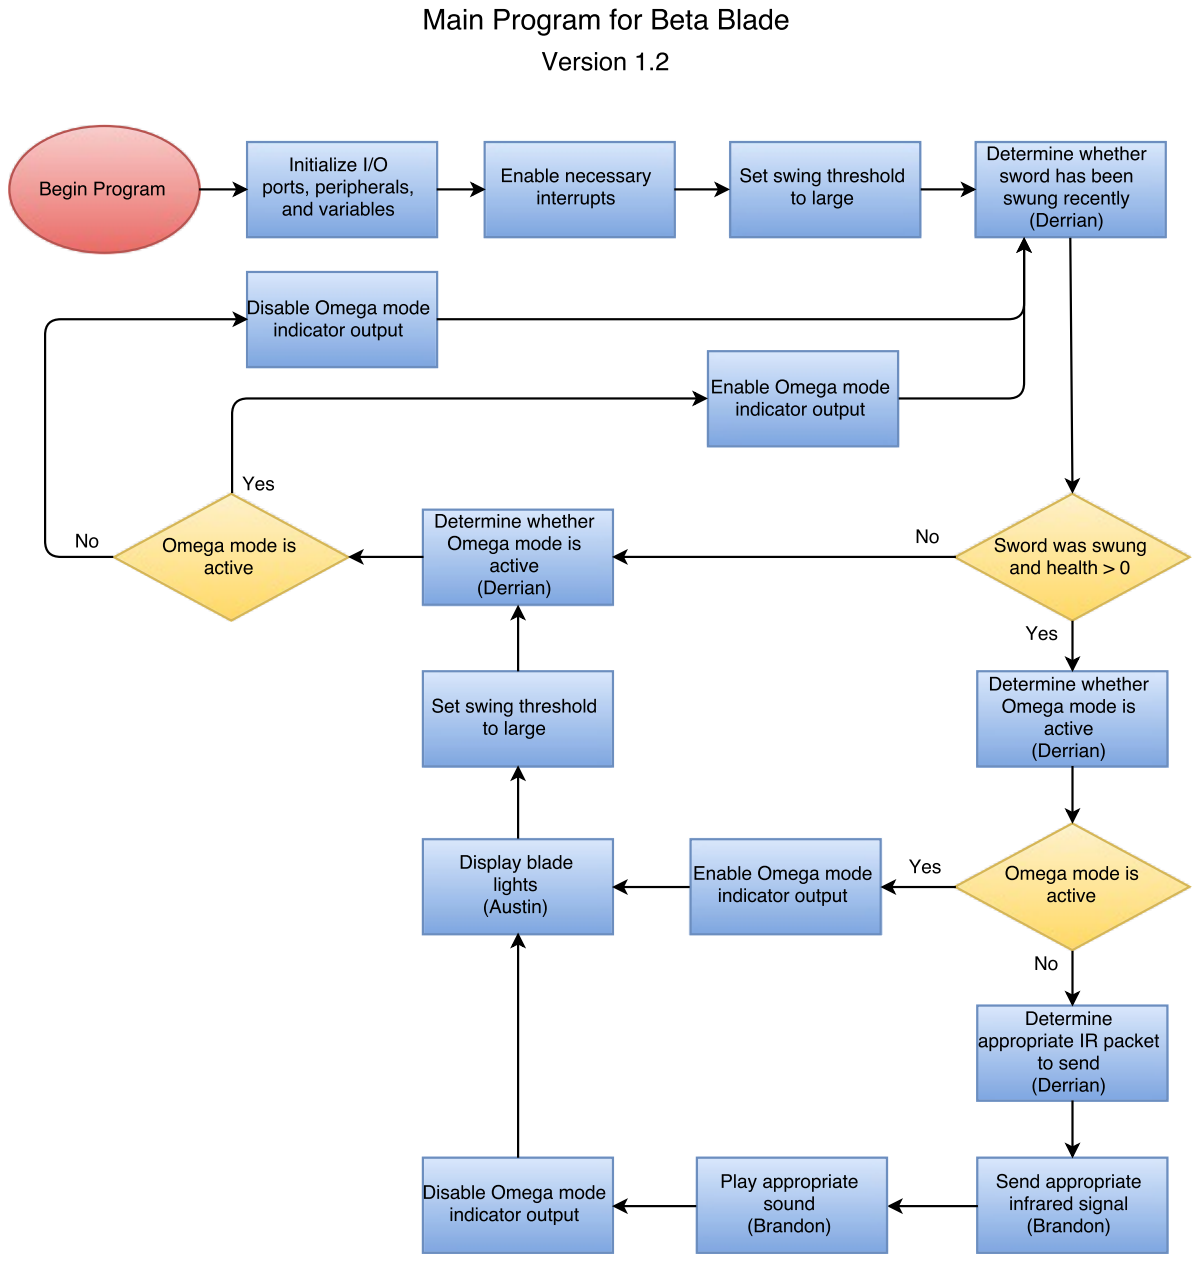
[picture p143: page 1]
