team2seniordesignwiki/OmegaBlade/4013 Senior Design/Research/Ben/PIC/pic_management_block_diagram_1.0.pdf

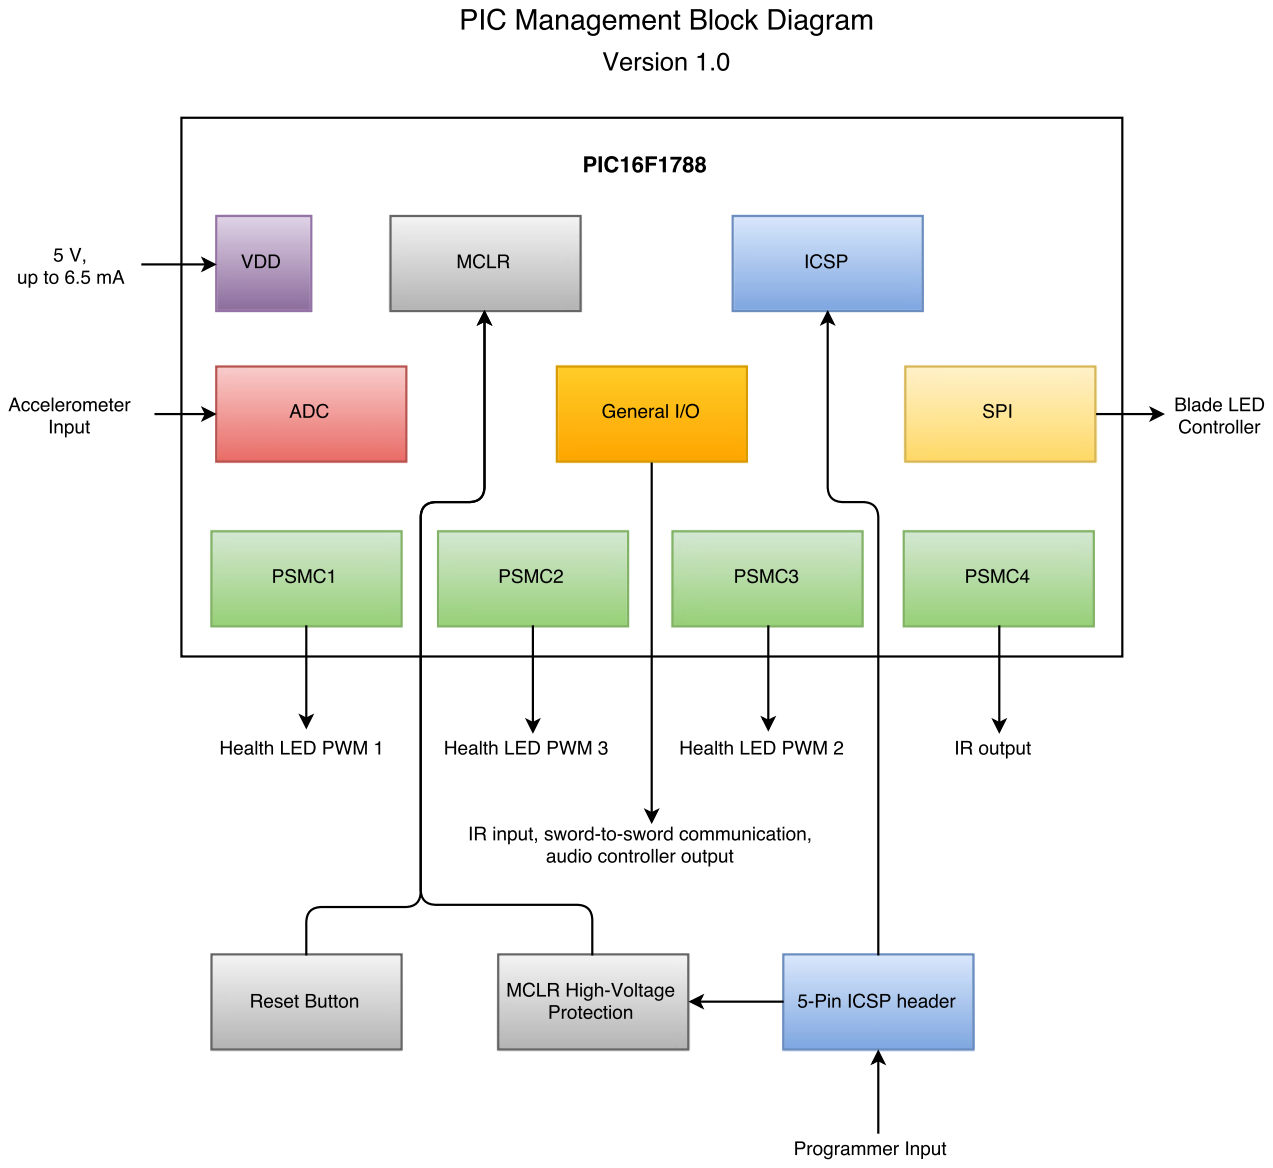
[picture p147: page 1]
