team2seniordesignwiki/OmegaBlade/4013 Senior Design/Research/Blake/Resources and Other/PS1024ARED.pdf

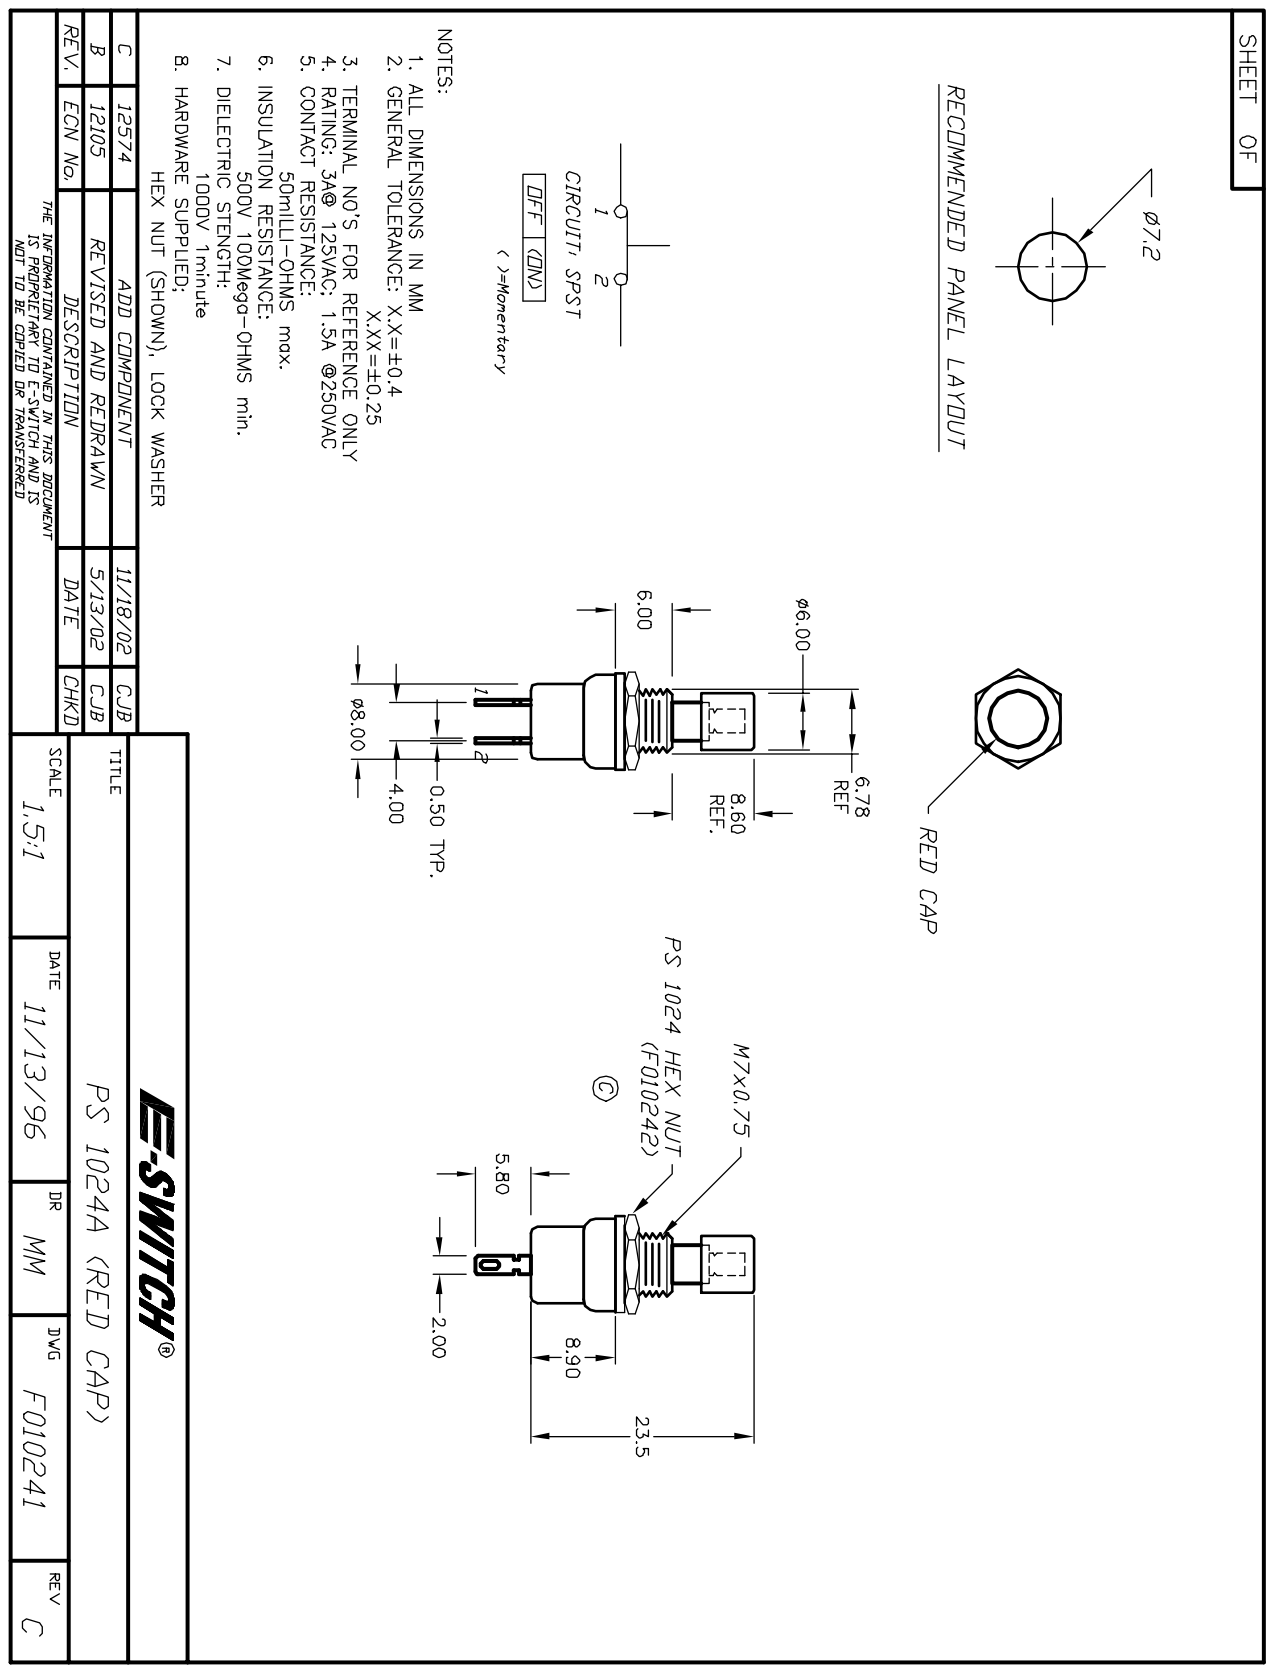
[picture p149: page 1]
