team2seniordesignwiki/OmegaBlade/4013 Senior Design/Research/Christian/ISR/Flowchart - ISR 9-26-15.pdf

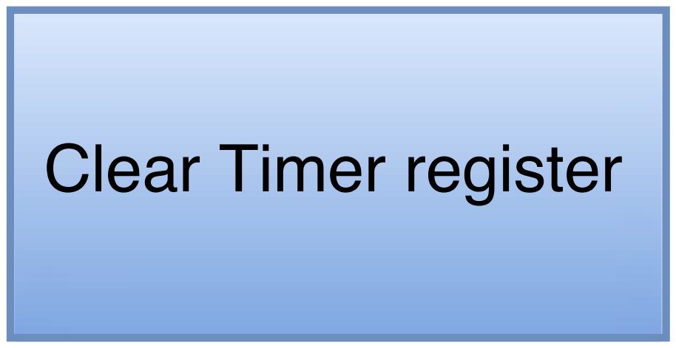
[picture p150: page 1]
