team2seniordesignwiki/OmegaBlade/4013 Senior Design/Research/Derrian/Blade Locking Communication/M90-606.pdf

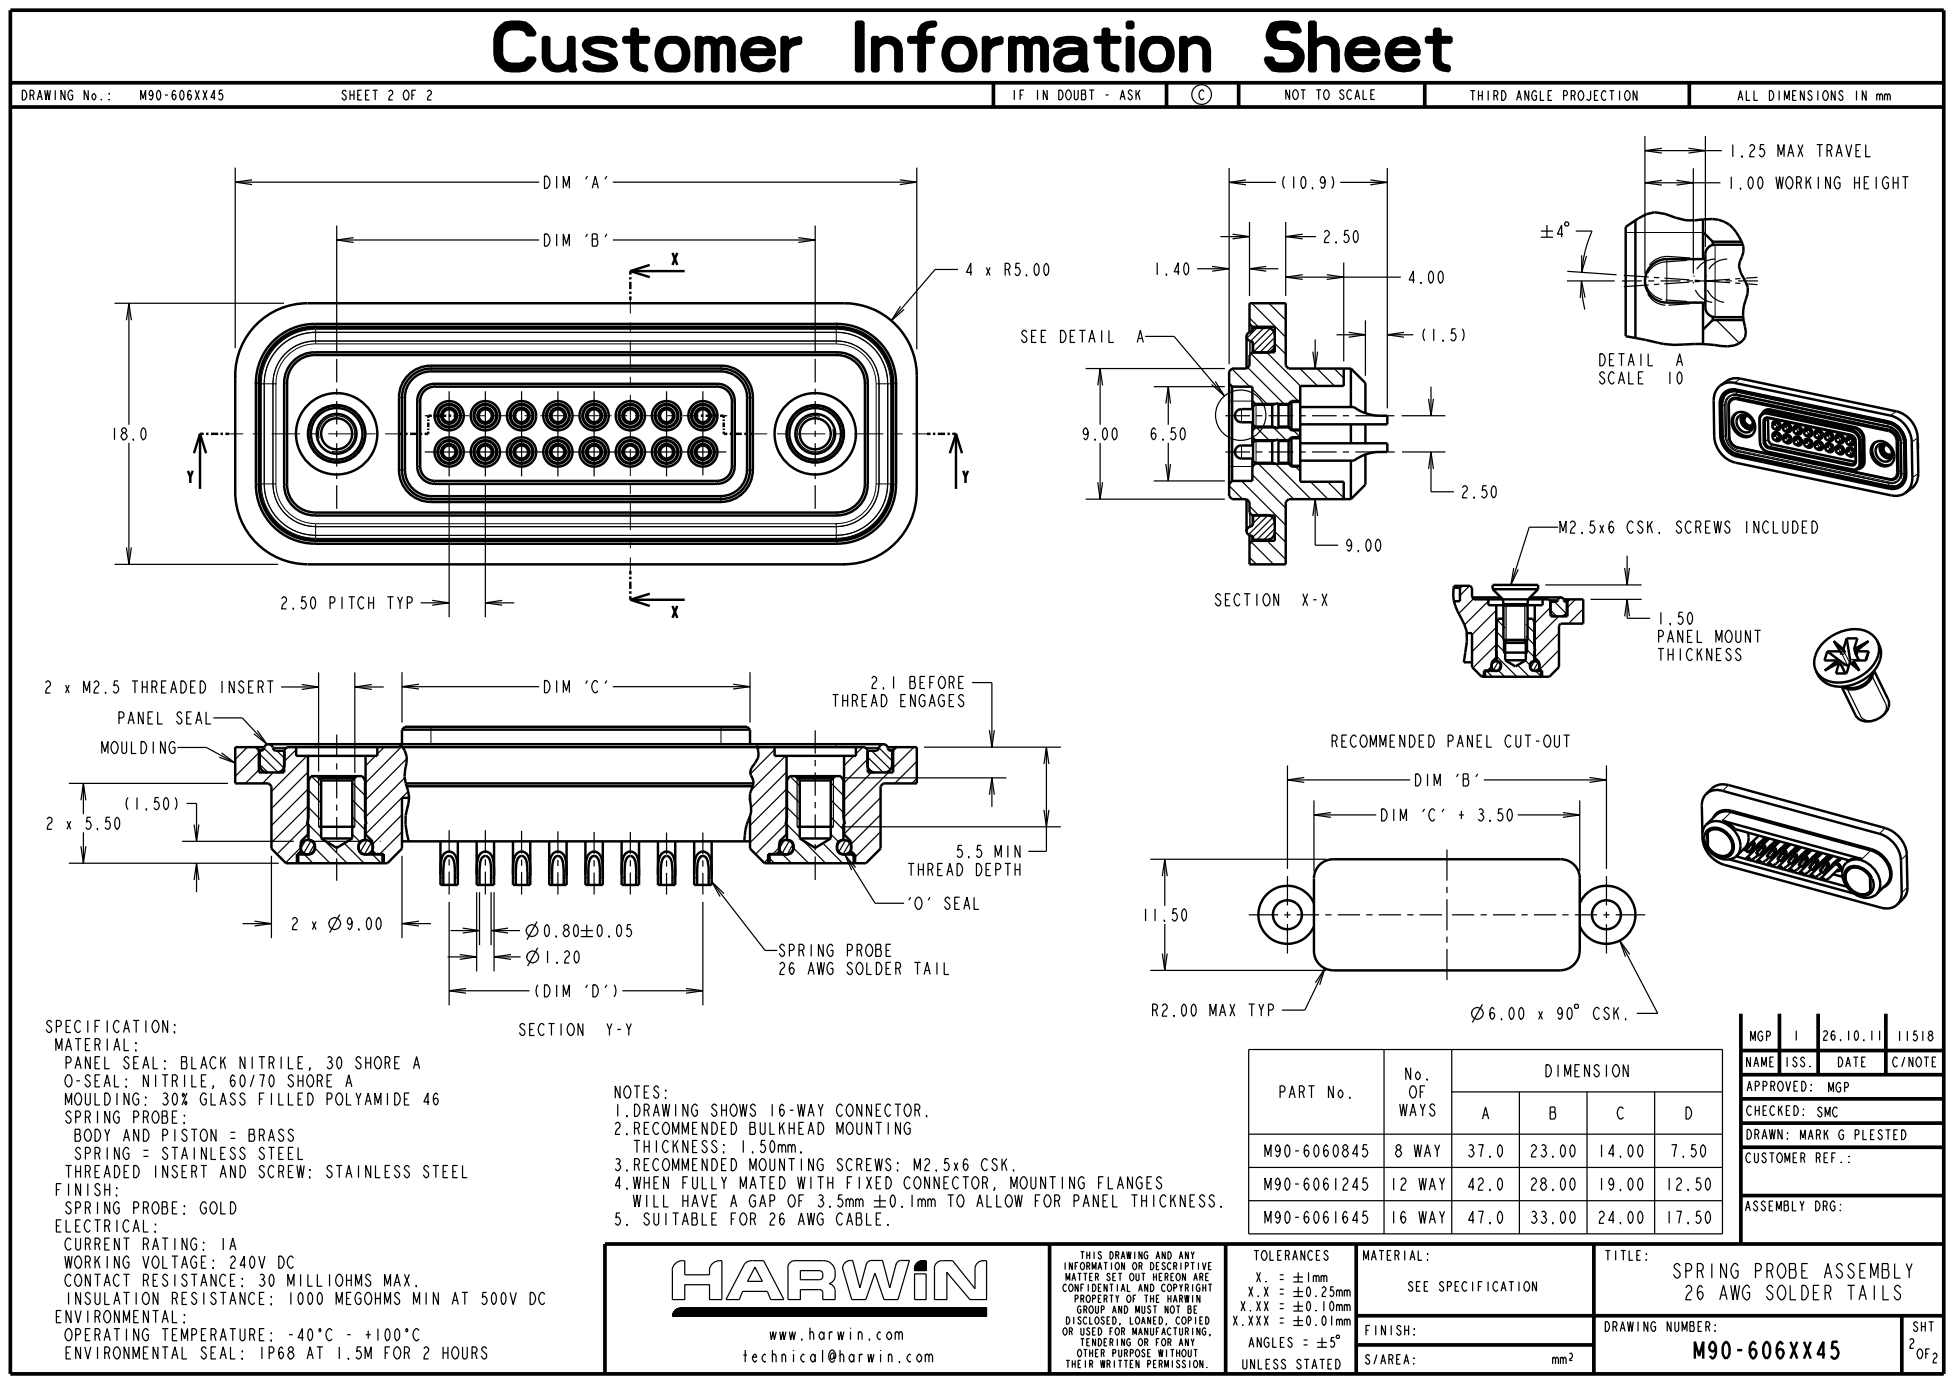
[picture p151: page 1]
