team2seniordesignwiki/OmegaBlade/4013 Senior Design/Research/Derrian/Blade Locking Communication/M90-706.pdf

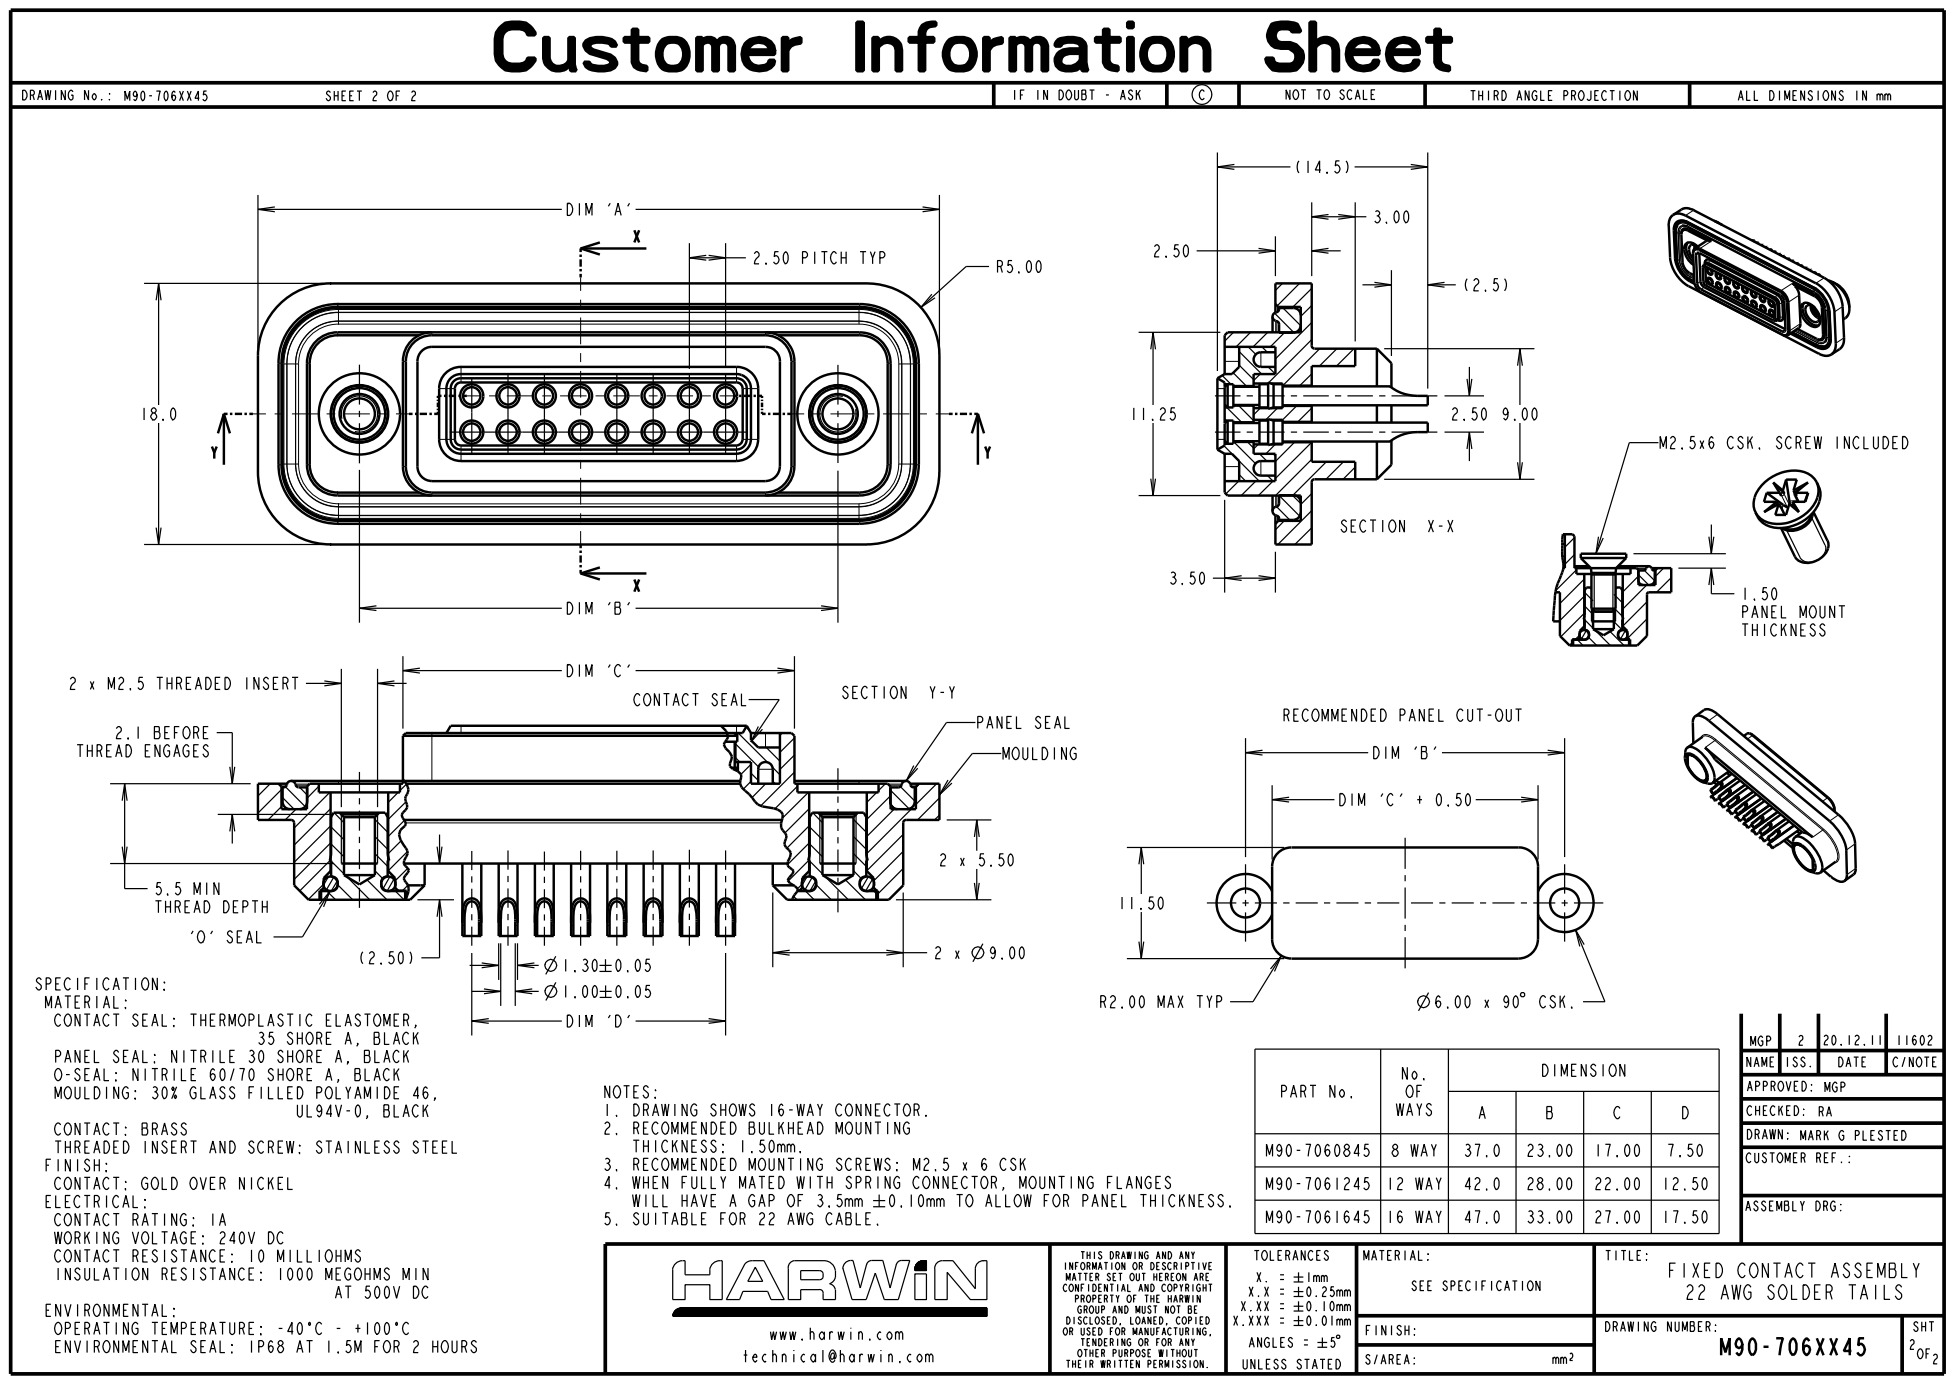
[picture p152: page 1]
