team2seniordesignwiki/OmegaBlade/(list of files, drawings)

Other design files:
4013 Senior Design/Homework/Altium/Firefly.SchDoc
4013 Senior Design/Integration/Integration I PCB/INTEGRATION ! Omega Blade PCB and Schematic.PrjPcb
4013 Senior Design/Integration/Integration I PCB/PCB1.PcbDoc
4013 Senior Design/Integration/Integration I PCB/PCB2.PcbDoc
4013 Senior Design/Integration/Integration I PCB/PIC Library File.PcbLib
4013 Senior Design/Integration/Integration I PCB/PIC Schematic File.SchLib
4013 Senior Design/Integration/Integration I PCB/Schematic.SchDoc
4013 Senior Design/Prototyping/Ben/PIC_Prototyping_PCB/PIC Library File.PcbLib
4013 Senior Design/Prototyping/Ben/PIC_Prototyping_PCB/PIC_Prototyping_PCB.PcbDoc
4013 Senior Design/Prototyping/Ben/PIC_Prototyping_PCB/PIC_Prototyping_PCB.PrjPcb
4013 Senior Design/Prototyping/Ben/PIC_Prototyping_PCB/PIC_Prototyping_Schematic.SchDoc
4013 Senior Design/Prototyping/Brandon/IR/Receive/IR Recieve Breakout/IR Recieve Breakout.PrjPcb
4013 Senior Design/Prototyping/Brandon/IR/Receive/IR Recieve Breakout/PCB.PcbDoc
4013 Senior Design/Prototyping/Brandon/IR/Receive/IR Recieve Breakout/Schematic.SchDoc
4013 Senior Design/Prototyping/Brandon/IR/Transmit/PCB.PcbDoc
4013 Senior Design/Prototyping/Brandon/IR/Transmit/Schematic.SchDoc
4013 Senior Design/Prototyping/Christian/ISR/ISR Prototyping/ISR Prototype.PrjPcb
4013 Senior Design/Prototyping/Christian/ISR/ISR Prototyping/PCB1.PcbDoc
4013 Senior Design/Prototyping/Christian/ISR/ISR Prototyping/PIC Library File.PcbLib
4013 Senior Design/Prototyping/Christian/ISR/ISR Prototyping/PIC Schematic File.SchLib
4013 Senior Design/Prototyping/Christian/ISR/ISR Prototyping/Schematic.SchDoc
4013 Senior Design/Prototyping/Christian/PCB/LARGE PCB/Omega Blade PCB and Schematic.PrjPcb
4013 Senior Design/Prototyping/Christian/PCB/LARGE PCB/PCB1.PcbDoc
4013 Senior Design/Prototyping/Christian/PCB/LARGE PCB/PIC Library File.PcbLib
4013 Senior Design/Prototyping/Christian/PCB/LARGE PCB/PIC Schematic File.SchLib
4013 Senior Design/Prototyping/Christian/PCB/LARGE PCB/Schematic.SchDoc
4013 Senior Design/Prototyping/Christian/PCB/SMALL PCB/Omega Blade PCB and Schematic.PrjPcb
4013 Senior Design/Prototyping/Christian/PCB/SMALL PCB/PCB1.PcbDoc
4013 Senior Design/Prototyping/Christian/PCB/SMALL PCB/PIC Library File.PcbLib
4013 Senior Design/Prototyping/Christian/PCB/SMALL PCB/PIC Schematic File.SchLib
4013 Senior Design/Prototyping/Christian/PCB/SMALL PCB/Schematic.SchDoc
4013 Senior Design/Research/Ben/PIC/Mutlisim Simulation/Prototype.ms14
4013 Senior Design/Research/Ben/PIC/research_phase_schematic.ms12
4013 Senior Design/Research/Ben/PIC/research_phase_schematic_1.1.ms12
4013 Senior Design/Research/Ben/PIC/research_phase_schematic_1.2.ms12
4013 Senior Design/Research/Ben/PIC/research_phase_schematic_secondary_1.0.ms14
4013 Senior Design/Research/Brandon Hogue/IR/Brainstorming/56kPWM-1MHzPWMDimmer.ms14
4013 Senior Design/Research/Brandon Hogue/IR/Transmit/NPN-CC-Driver.ms14
